lvschouwen/split-flap/README.md

# Split-Flap



Split Flap Display

---
**NOTE:** I will make my best attempt to provide answers where possible in issues and try to keep things up to date where possible dependency wise, however I do not have the time/capacity to work on this project on a consistent basis. Answers and updates may take time.

My personal Split-Flap has been working since I first published this repository and continues to work to this day happily. Several people have also successfully been in touch with their working creations of this Split-Flap which I am very happy it has worked for :) 

I hope this project continues to work for any whom wish to embark on it but be aware, it is a lot of work to complete.

Thank you everyone whom has contributed, included in the "main" release or not, it is very appreciated. I hope to keep the project going in future.

<3

---

This project has been forked from the brilliant [Split Flap Project](https://github.com/Dave19171/split-flap) by [David Königsmann](https://github.com/Dave19171). None of this would have been possible without the great foundations that have been put in place.

3D-files here on [Printables](https://www.prusaprinters.org/prints/69464-split-flap-display)!

---

## What this is

A mechanical split-flap display driven by an **ESP32-S3 master** that talks over I2C to a chain of **Arduino-Nano flap units** (one Nano per flap drum). The master hosts the web UI, WiFi portal, NTP clock, MQTT/Home-Assistant integration, and pushes both master and unit firmware over the air.

A Split-Flap can have more rows than the master drives itself: each further row hangs on a cheap **ESP-01 row board** that the master pairs with over your LAN. The master lays the text out over all rows, flips them at one instant, and keeps the row boards on its stored row image.

> **Release:** the current stack is **v2** — the full port of the original ESP8266 firmware onto the ESP32-S3 plus row boards for multi-row walls. Releases are date-versioned (`vYYYY.MM.DD`); see the [releases page](https://github.com/lvschouwen/split-flap/releases) for notes and firmware binaries.

## Firmware layout

Everything is built with [PlatformIO](https://platformio.org/) — no Arduino IDE. Each project has its own `platformio.ini`; run `pio` commands from the project directory.

| Folder | Target | Role |
|---|---|---|
| `firmware/v2/Master/` | ESP32-S3-WROOM-1 (N16R8) | **The master.** Web UI, WiFi, NTP, MQTT/HA, I2C unit bus, OTA, the wall link to its row boards. |
| `firmware/v2/Unit/` | Arduino Nano | Per-flap unit: stepper homing, I2C slave, EEPROM offset/address. |
| `firmware/v2/FollowerEsp01/` | ESP8266 ESP-01 | Optional row board — turns legacy ESP-01 master hardware into a further row of an S3 master's wall. |
| `firmware/v2/Rescue/` | ESP32-S3 (factory slot) | Break-glass recovery image; installs a good master image when the app slots are bad. |
| `firmware/v2/Bootloader/` | ESP32-S3 | Custom second-stage bootloader (adds a factory-reset button on GPIO 4). |
| `firmware/v2/UnitBootloader/` | Arduino Nano | Vendored + patched **twiboot** for reflashing units over I2C (see its README). |
| `firmware/v1/ESPMaster/` | ESP8266 ESP-01 | **Frozen, deprecated** — the original v1 master, kept as reference only, out of CI (see its README). |

Install PlatformIO Core once:

```bash
pip install -U platformio
```

Then, from a project directory:

```bash
pio run                  # build
pio run -t upload        # USB flash (first time / devkit)
pio device monitor       # serial monitor at 115200 baud
pio test -e native       # host-side unit tests
python -m pytest tests/  # python-side tests (where present)
```

The operator page and the bundled unit firmware are gzipped and compiled into the master binary at build time by `firmware/v2/Master/build_assets.py` — there is no separate filesystem-flash step; `pio run -t upload` lands the whole thing.

For a Nano whose upload fails on the stock bootloader, use the fallback env:

```bash
pio run -e unit_old_bootloader -t upload
```

## The master (ESP32-S3)

The master is an **ESP32-S3-WROOM-1-N16R8 devkit**. It drives the units over I2C (SDA = GPIO 8, SCL = GPIO 9, 100 kHz) and serves one operator page: the wall, then each board, then each unit, with everything about one thing on its own screen. The same surface is open to scripts as `/api/v2` (`GET /api` lists every route).

Highlights:

- **WiFi portal** — on first boot (or when the stored network can't be reached for ~30 s) the master brings up a `<device-name>-setup` access point. Connect, pick your network, done. Credentials live in NVS and survive reboots and firmware updates.
- **Clock / NTP** — full IANA timezone picker (baked table served at `/tz.json`); the time is set at boot, on WiFi join, and whenever you change the zone.
- **OTA** — upload a new `firmware-<rev>.bin` from **Firmware → Install an update** (mandatory `?md5=` integrity check). The S3's A/B slots mean a bad image rolls back automatically. The Firmware screen shows what every board, unit and bootloader should run and does run.
- **Rescue / factory reset** — hold the GPIO 4 button for 5 s through reset to boot the rescue app from the factory slot, or `POST /firmware/rescue-boot`. WiFi credentials always survive a factory reset.
- **MQTT / Home Assistant** — see below.
- **Verdicts and history** — every board and unit is judged working, worth knowing or needing attention, with the reason; what happened on the wall is kept as a history. The master's board screen shows heap, load, I2C traffic, MQTT state and NTP sync age.

The master takes IPv6 addresses beside its IPv4 one when the network hands them out — a link-local one always, a global one when the router announces a prefix — and the page and the API answer on them; `GET /api/v2/board/<master>` lists them under `ipv6`. The operator API has no login: it relies on the network's firewall, for IPv6 as for IPv4. A global IPv6 address is reachable from the internet unless the router blocks inbound connections, as most do by default; check yours before relying on it. The row boards take IPv6 addresses the same way and answer on them; the link between master and rows, pairing and the rescue image stay on IPv4.

## The units (Arduino Nano)

Each split-flap unit is an Arduino Nano on a custom PCB, driving a **28BYJ-48** 12 V stepper through a **ULN2003** and homing the drum against a **KY-003 hall sensor** + magnet. Per-unit calibration (step offset) and the I2C address live in the Nano's EEPROM.

Flash a unit's Nano from `firmware/v2/Unit/`:

```bash
pio run -t upload
```

### Set the unit address

Each unit's address comes from a 4-way DIP switch (the firmware adds 1 so DIP `0000` → I2C `0x01`; address `0x00` is the reserved general-call address). Set them ascending from zero:

| Unit | DIP  | I2C address |
| ---- | ---- | --- |
| 1 | 0000 | 0x01 |
| 2 | 0001 | 0x02 |
| 3 | 0010 | 0x03 |
| 4 | 0011 | 0x04 |
| 5 | 0100 | 0x05 |
| … | … | … |

The master scans the bus at boot and derives the display width from the highest responding address. A dead unit keeps its slot (the layout doesn't shift), but a unit parked on a high address with nothing below it widens the display. A unit count can also be pinned manually (the master's board screen → **Settings for this board** → **Number of units**) for headless/dummy setups.

### Calibrate the zero position

The zero (blank-flaps) position is set by homing to the hall sensor and stepping a few steps forward — an offset unique to each unit, stored in EEPROM. Calibrate from the page, no reflashing:

1. Open **Calibrate the wall** (under the wall picture).
2. Pick a test letter; the master shows it on every unit.
3. Mark the flaps that show something else, and say what each one actually shows.
4. The master corrects each marked unit's offset, stores it in the unit and finds home again, over I2C; repeat until the wall is right.

A single unit is lined up on its own screen (**Line up this flap**), which also has the raw offset and nudge controls.

### Reflash units over I2C

Units carry the [patched twiboot bootloader](./firmware/v2/UnitBootloader/README.md) (flashed once per unit via ICSP). The master ships the compiled unit sketch in its own binary and:

- auto-installs it on any Nano it finds sitting in twiboot (e.g. a freshly ICSP-flashed one), and
- updates every unit on demand from a board's screen (**Update units**), or automatically for out-of-date units when a board starts.

## Walls of several rows

One ESP32-S3 master per Split-Flap; every further row is an ESP-01 row board (`firmware/v2/FollowerEsp01`) on the same LAN. The row board dials its master and keeps one connection open (the wall link); the master wraps and aligns your text across the grid and names the instant all rows flip.

- Pair a row in **Wall settings → Rows** (**Look for more boards**, or add one by its address), and arrange the rows there. By script: `curl -X POST http://<master>/api/v2/action -H 'Content-Type: application/json' -d '{"name":"pair","target":{"host":"<row address>"}}'`; `release` and `arrange` change the wall the same way, and `GET /api/v2/wall` shows every board.
- Unit jobs (home, calibrate, self-test, unit firmware, bootloader) go through the same call for the master's own units and a row board's.
- Upload a `follower-<rev>.bin` once to the master (`POST /firmware/row?md5=`); every row board on another rev is offered it and fetches it.
- All boards are assumed to be on your own LAN: the link is not authenticated.

Design: [`docs/superpowers/specs/2026-10-05-wall-link-and-console-design.md`](./docs/superpowers/specs/2026-10-05-wall-link-and-console-design.md).

## MQTT / Home Assistant

The display joins Home Assistant over MQTT with automatic discovery: inbound notification text (shown for a dwell, then reverts), a **Mode** select (text/clock), and health telemetry — including per-unit wear and a wall problem sensor when the master has row boards. Configure it in **Wall settings → Home Assistant** (host, port, user, password); leave the host empty to keep MQTT off. Create a dedicated HA user for the display rather than reusing your own login.

## Device name & running multiple displays

Every network-facing name (mDNS `<name>.local`, DHCP hostname, MQTT client id/topics, AP SSIDs) derives from one per-device identity. Out of the box it's `split-flap-<hex chip id>` — unique per board, so several displays can share a LAN running the **same image** with no per-device edits. Set a friendly name on the master's board screen (**Settings for this board** → **Name**; lowercase letters/digits/hyphens, ≤24 chars). Note that the name is also the MQTT client id and the Home Assistant device id: renaming a master that Home Assistant already knows makes it a new device there. Use a **DHCP reservation** on the board's MAC for a fixed IP.

**Boards by their place on the wall.** Besides its identity, every board answers to a name that says where it hangs: `split-flap-row1.local` is the top row, `split-flap-row2.local` the one below, and so on (counted as the page shows them; when two boards share a grid row the name carries the column too, `split-flap-row2-c9`). A row board takes this name from its master as its DHCP hostname and mDNS name, so a router that registers DHCP hostnames in its DNS also knows it under its own domain; the name follows the row when it is moved on the Arrange screen (the row reconnects its WiFi once for that). The master answers for its own row's name on mDNS beside its own name; DHCP carries the master's own name only. A row without a master, or one that was released, is `split-flap-<hex chip id>` again. The identity is what the master's **Find row boards** scan and the pairing go by; it never changes.

## Flashing & provisioning

- **First flash** of an S3 is a USB job (`pio run -t upload`, or the merged factory-bin recipe in [`flashing/README.md`](./flashing/README.md) which lands the custom bootloader + rescue slot in one shot).
- **Subsequent flashes** go over the air — from the page's Firmware screen, or scripted with [`flashing/ota-flash.sh`](./flashing/ota-flash.sh) (fetches the latest staged bin, OTAs master/follower/rescue targets, reads the verdict back from `/settings`).
- The bundled unit firmware is staged into the master (and follower) `data/` dirs by `flashing/flasher/make_manifest.py stage`; CI's `gate` step enforces that it never drifts from the built Unit hex.

See [`flashing/README.md`](./flashing/README.md) for the full recipe (DIP address table, esptool factory-bin, OTA flags).

## PCB

The **currently deployed** hardware uses the original per-unit Arduino-Nano PCB (Gerbers under `PCB/v1/`), one board per unit. Services like [JLCPCB](https://jlcpcb.com/) or [PCBWay](https://www.pcbway.com/) can fabricate and assemble them — some surface-mount parts are best flow-soldered by the fab.

## Common problems

- **Display width looks wrong** — check each unit's DIP-switch address and wiring; address contiguously from DIP `0000` (I2C `0x01`). The **Units: N / W** field shows detected vs. derived width.
- **A unit never homes** — when powered, the KY-003 hall sensor should only light when the magnet passes it. Check the sensor lead and magnet alignment.
- **Only `pio run -t upload`** is needed to flash — web assets and the bundled unit firmware are baked into the binary; there is no separate filesystem upload.
- **WiFi range** — user [@beroliv](https://github.com/beroliv) reported ESP8266 WiFi issues on legacy hardware, resolved by soldering an extension wire to the antenna ([writeup, German](https://www.stall.biz/project/verbesserte-wlan-konnektivitaet-mit-externen-antennen-fuer-wiffi-weatherman-und-andere-module-mit-esp8266/)). Take care if you try it.

## Going deeper

- [`CLAUDE.md`](./CLAUDE.md) — the authoritative map of the current architecture, per-mechanism ownership, and hard invariants.
- [`docs/superpowers/specs/`](./docs/superpowers/specs/) — a dated design spec per feature.
- Per-mechanism detail lives in the header comment of the file that owns it.

Assembly of the mechanical build follows the [instruction manual](./Instructions/SplitFlapInstructions.pdf).
