lvschouwen/split-flap/docs/superpowers/specs/2026-10-02-in-system-twiboot-update-design.md

# In-system twiboot update over I2C (#499)

Status: design approved in chat 2026-10-02. Unit side implemented and
simavr-proven (`firmware/v2/Unit/BootUpdateAvr.h`, `UnitBootloader/sim/`);
master drivers pending. Stage 1 (boot-section dump, #511) already shipped.

## Goal

Replace the bootloader (twiboot) on fielded split-flap units over I2C, with no
ICSP, and leave behind a bootloader that can be updated routinely afterwards.
The update runs from the unit's own application firmware, driven one unit at a
time by whichever master owns the row. **Both masters must be able to drive it:**
the S3 master (16-unit row) and the ESP-01 follower (5-unit row). The unit-side
report + updater is master-agnostic by construction (it answers I2C ops), so the
only per-master work is the driving code; the S3 and ESP-01 drivers ship
together, not as a deferred follow-up. Rollout order on the wall is still S3 row
first, then the ESP-01 row, once the mechanism is proven.

## What is already known (stage 1, #511)

- All 16 S3-row units run the committed prebuilt image
  `UnitBootloader/prebuilt/twiboot-atmega328p-16mhz.hex`: 890 of 1024 bytes,
  CRC32 `18173add`. The vendored `main.c` built with the PlatformIO toolchain
  (avr-gcc 7.3.0) reproduces that image **byte for byte** — confirmed in this
  session. The new image is therefore a known delta from a known base.
- Boot section is the real NRWW section at `0x7C00`–`0x7FFF`,
  `VIRTUAL_BOOT_SECTION=0`, BOOTRST set (HFUSE `0xDC`), so reset enters the
  bootloader first. Interrupt vectors stay in the application section (IVSEL
  clear).
- **Page 7 (`0x7F80`–`0x7FFF`) is empty** (all `0xFF`).
- twiboot's SPM instructions sit at `0x7e60`, `0x7e86`, `0x7ea6`, `0x7eb2`.
  None is a clean callable `do_spm` — each is followed by a jump back into
  twiboot, not a return to the caller.
- The 5 ESP-01-row units were not dumped (the follower has no dump op); they are
  presumed on the same image and are guarded at update time by the same
  boot-section CRC check.

## Why it is safe to attempt

The only moment a unit can be bricked is while a page that is on the reset /
execution path is mid-write and power is lost. Reset always enters 0x7C00
(BOOTRST), so that page is boot page 0: from the start of its erase until its
write completes it is blank, and a reset then executes erased flash. Stage 2
rewrites page 0 twice (trampoline, then the real page), so there are exactly
two such windows per update, each one erase+write (~9 ms). Everything else is
resumable:

1. SPM executes only from the boot section. The application cannot write flash
   directly; it must transfer control to code in the boot section.
2. **Stage 1** gets a proper `do_spm` into the *empty* page 7 by driving
   twiboot's own write handler (below). Page 7 is not on any execution path, so
   a failure here cannot brick a unit — it is the proof of the technique, on the
   wall, at zero risk.
3. **Stage 2** uses that `do_spm` (now a normal callable routine) to rewrite
   pages 0–6. It writes a one-instruction trampoline into page 0 first, then
   pages 1–6, verifying each by read-back, and writes the real page 0 only
   once pages 1–7 all match the target. A reset or power loss after the
   trampoline write completes and before the final page-0 erase starts boots
   the (still intact) application, which detects the half-done state and
   resumes. The simavr kill sweep confirms the windows are exactly these two.

## Stage 1 mechanism — drive twiboot's own write handler (proven)

Writing page 7 needs an SPM, and no callable `do_spm` exists yet. An earlier
plan borrowed a bare boot-section `spm` per fill and returned via a timer IRQ;
simavr **disproved** it — after a non-halting fill `spm`, twiboot's *own* fill
loop (`0x7e86`, ~19 instructions later) starts running during the ~5-cycle
interrupt latency and walks a pointer out of bounds before the ISR can preempt
(crash at `0x7e7e`). Per-word borrow is not viable.

The method that works, and is proven in simavr against the fielded image
(`firmware/v2/UnitBootloader/sim/`), drives twiboot's *entire* write handler
once instead of fighting it:

1. Seed twiboot's page buffer in SRAM (`buf` at `0x011D`..`0x019C`) with the 128
   bytes destined for page 7 (the `do_spm` routine + `0xFF` padding) — plain
   `st`, twiboot is not running.
2. Set the handler's register inputs: `r24:r25 = 0x7F80` (pagestart), the SPMCSR
   constants `r9=0x03`/`r16=0x01`/`r13=0x05`/`r12=0x11`, the fill-loop end
   pointer `r14:r15 = 0x019D` (buf+128), and `r1 = 0`.
3. `jmp 0x7e5a` — into twiboot's handler *just past* its boot-section guard
   (`0x7e52`, `brcc` away if pagestart ≥ `0x7C00`). twiboot then erases page 7,
   fills it from `buf[]`, writes it, re-enables RWW, and `rjmp`s to its **idle
   main loop** (`0x7e12`→`0x7d02`) — no crash.
4. Control does **not** return to the running sketch: twiboot's `buf[]` and
   globals overlay the application's `.data`/`.bss`, so its RAM is gone. The
   updater disables interrupts and TWI *before* seeding (an ISR would run on, or
   write into, the seeded bytes; an ISR between twiboot's `sts SPMCSR` and
   `spm` voids the SPM), arms the watchdog at 250 ms, and jumps. twiboot then
   leaves its idle loop one of two ways: the watchdog reset, or — if the
   overlaid application byte at its command address `0x019D` happens to read
   `0x21` — an immediate jump to the application. Its timeout countdown cannot
   exit, because expiry stores `r10` as the command and the updater zeroes
   `r10`. Either way the application starts from its reset vector, and the
   outcome is read as boot-section state `Page7Installed`, not as a RAM result
   code. All three cases are exercised in simavr.

Stage 2 does **not** use any of this: `do_spm` in page 7 is a normal callable
boot-section routine ending in `ret`, so the sketch rewrites pages 0–6 with
plain `call`s (proven, `PAGE6 128/128`).

The borrow/entry addresses, SPMCSR values and buffer layout are **locked by a
test over the fielded hex** (`tests/test_twiboot_entry_points.py`) and the
mechanism is reproduced by the simavr harness before any unit is touched.

## New twiboot image (lean set)

Built from the vendored `main.c` + a small patch; delivered as a second
prebuilt hex plus a generated PROGMEM header for the unit firmware.

- **`do_spm` in page 7** at a fixed address, optiboot-style calling convention
  (`r24:r25` = address, `r22` = `SPMCSR` action, `r20:r21` = data word for
  fill; caller holds interrupts off; `UnitBootloader/do_spm.S`), plus a 2-byte
  ABI/generation marker at `0x7FFE` (version byte `0x01`, then its complement:
  `01 fe`) so future firmware can identify the bootloader generation it runs
  under.
- **MCUSR stash:** `.init3` copies `MCUSR` into `GPIOR0` before clearing it, so
  the sketch can finally read the reset cause (today twiboot clears it — see
  #502 item 6, which this partly addresses).
- **Bounded pin:** a pinned bootloader falls back to the application after a
  quiet period, *unless* application flash word 0 reads `0xFFFF` (blank, keep
  waiting for a push). The quiet period is anchored to the measured worst-case
  reflash batch gap, not an invented number.
- **EEPROM access removed** (the master never uses twiboot's EEPROM path) to
  buy space. Measured budget with avr-gcc 7.3.0: EEPROM off = 728 B text,
  EEPROM+LED off = 694 B. Built image: 778 B in pages 0–6 (896 B available),
  leaving headroom; `do_spm` lives in page 7.
- **Unchanged:** flash *write* stays bounded to the application section; flash
  *read* stays unbounded so `boot-dump` keeps working.

The generated PROGMEM header is gated to match the prebuilt hex, the same way
the unit bundle is gated against the Unit build.

## Unit firmware: report + updater

All additive to the I2C contract — no `SFP_PROTOCOL_VERSION` bump.

### `GET_BOOT_INFO` (query, 0x8B)

Checksummed reply carrying: lock byte, three fuse bytes, CRC32 of the boot
section, a classified boot-section state, and the last update result. Reading
lock/fuses is done by **application** code (twiboot cannot report them). This
closes **#502 item 8**.

Part of the fleet cannot read them: on 11 of 21 units the read returns the
sketch's own first four flash bytes (#518). The unit recognises that, sets the
unreadable flag (bit 7 of the result byte) and sends placeholder bytes; masters
report `lockfuse: unreadable`. For the update guard an unreadable lock counts as
open — the read-back verification is what catches a write that did not land.

Boot-section state is derived from flash, never stored — a pure,
natively-tested classifier in a new `shared/` header maps the section to:
`Old` (CRC == `18173add`), `Page7Installed`, `Trampoline`, `New`, or `Unknown`.

### `BOOT_UPDATE` (mutation, 0x9A, stage byte + complement)

Deferred to `loop()` via a `pending*` flag like every other mutation; refused
while the drum is moving or not homed.

- **Stage 1** allowed only from `Old` with lock bits permitting boot writes.
  Writes `do_spm` into page 7 by driving twiboot's write handler, then the unit
  restarts (above). Success = state `Page7Installed` on the next
  `GET_BOOT_INFO`. The unit comes back unhomed (staggered boot-home, #309) and
  stage 2 is refused `REFUSED_BUSY` until the master homes it. Brick-free: a half-done stage 1 keeps the fielded pages 0–6
  and classifies `Old`, so it is simply retried.
- **Stage 2** allowed only from `Page7Installed` or `Trampoline`, and only when
  page 7 is byte-identical to the target `do_spm` page (`Trampoline` is keyed on
  page 0 alone, so it does not imply this). Interrupts off and TWI disabled
  (bus NACKs) for the ~80 ms; TWI is re-initialised afterwards. Any EEPROM
  write still in progress is drained first (both stages, and before lock/fuse
  reads): it silently blocks SPM, and one ending between a page-0 erase and
  its write would program an unerased page 0. Order:
  1. page 0 → trampoline (`jmp 0` to the application), skipped when it already
     is one, then read back; a page-0 write that does not verify is retried
     (3 attempts) while the application is still alive to repair it;
  2. pages 1–6 → target, skipping pages that already match, each read back;
     the first mismatch stops with the trampoline in place (resumable);
  3. only when pages 1–7 all match: page 0 → target, read back. If it does not
     match, the trampoline is written back — the only page 0 a reset can boot;
  4. whole-section CRC must classify `New` → `STAGE2_OK`, else `VERIFY_FAILED`.
  No reset afterwards: the sketch at 0x0000 is untouched, so the master reads
  the result via `GET_BOOT_INFO` and then issues `REBOOT`. Masters key on the
  **state**; the result byte only explains it (a resent stage 2 on a unit
  already New is refused but does not overwrite `STAGE2_OK`).
- **Auto-resume:** a unit that boots and classifies as `Trampoline` runs stage
  2 once unprompted, from `setup()` before `Wire.begin()` — it has no working
  bootloader until stage 2 finishes, so it must not wait for a command. A
  resume adds no page-0 window (the trampoline is already there).

The updater and the embedded target image stay in the unit firmware afterwards
(unit firmware is 16.9 KB of 30.7 KB with them) as the routine path for future
bootloader updates.

## Masters (S3 **and** ESP-01 follower)

Both masters must be able to drive the report + update, so the master-side work
ships for both trees in this arc.

### S3 master

Mirrors the stage-1 (#511) op structure: a `DisplayOpcode`, a
`makeBootUpdateCommand`, an `exec*` in `DisplayTask.cpp`, a `UnitBus` entry, and
two web routes.

- **`POST /unit/boot-update?address=N&stage=1|2`** and **`POST
  /unit/boot-info?address=N`** / result reads, on the existing `{"seq":N}`
  op-result contract.
- Arms the probe-inhibit deadline after **both** stages (as `/unit/reboot` and
  the address burns do): stage 1 restarts the unit, and stage 2 is followed by
  a `REBOOT`. After stage 1 the result is the re-polled `GET_BOOT_INFO` state,
  not the result byte (it does not survive the restart).
- **Reflash-order change (load-bearing):** the normal unit reflash job writes
  application page 0 **last** (blank it first). An interrupted reflash then
  leaves word 0 blank, so both the old and the new twiboot stay in the
  bootloader for auto-install. This is what makes the new twiboot's bounded pin
  safe.
- **`flashing/update-unit-bootloaders.sh`:** gated, per-unit, stops at the
  first failure — the twiboot-generation twin of `commission-units.sh`.

### ESP-01 follower

The follower drives its own 5-unit row's update over the same I2C ops. It has no
web UI of its own, so the leader exposes the trigger (the follower already
proxies unit ops in the cluster). Constraints carried from the follower's known
limits: the ping/op digest body ceiling (#386) — the boot-info reply must fit —
and the follower's narrower flash/RAM budget for the embedded target image. The
boot-section CRC guard still protects the 5 ESP-01-row units even though they
were never dumped (#511).

1. OTA the master, then an ordinary unit reflash campaign carrying the report +
   updater (no EEPROM-layout bump, so it is a cheap reflash).
2. `GET_BOOT_INFO` on all 16 units; confirm `Old` and lock bits open.
3. Stage 1 on all 16; confirm `Page7Installed` by read-back, then home each
   unit (it restarts unhomed and stage 2 is refused until it is homed).
4. Stage 2 on **one** unit, then accept it three ways: `boot-dump` CRC through
   the new twiboot, a full application reflash through it, and the unit homing
   afterwards.
5. Stage 2 on the remaining 15, one at a time, stopping at the first failure.

## Verification

- **Native tests** (`pio test -e native`, Unit + Master): the boot-section
  classifier, the stage guards, and the reply encoders.
- **Entry-point gate** (pytest): asserts the fielded hex (CRC `18173add`) still
  carries the exact instruction bytes at every address the stage-1 borrow
  depends on, and the exact `do_spm` entry in the new image — proven by breaking
  it once (per the verify-guards-by-falsification rule). A toolchain or image
  change that moves a byte fails CI rather than bricking a unit.
- **Generated-header gate** (pytest): the PROGMEM target image header matches
  the prebuilt hex.
- **simavr** (installed on the build host), standing in for the declined
  spare-Nano bench stage: `UnitBootloader/sim/prove.sh` compiles the unit's own
  `BootUpdateAvr.h` into a test app and runs the whole update from the real
  fielded image, a power-loss + reset before every one of its 603 flash
  operations (each must recover by itself to the byte-exact target, except the
  130 points inside the two page-0 windows), verify failures on a middle page
  and on the final page 0, a missing `do_spm`, and an idempotent resume. Every
  guard is proven by breaking it. It does not model SPM duration, lock bits or
  other ISRs, but it exercises the register setup, addresses and page ordering
  — where a defect would actually live.
- **Review:** `cpp-reviewer` on the unit updater and the master reflash-order
  change (OTA/flash/concurrency surface).

## Risks and non-goals

- A power loss during either page-0 write (erase start to write end, ~9 ms
  each, twice per update) bricks that unit until ICSP. A failed final page-0
  read-back adds a third (the trampoline restore), which is still better than
  leaving an unverified page 0 for the next reset. Everything else is
  resumable. No brown-out handling is added: a slow supply collapse during a
  window is the same loss.
- A unit whose lock byte reads closed is refused and stays on the old twiboot.
  A unit whose lock byte cannot be read at all proceeds (#518).
- The ESP-01 row is in scope for this arc (both masters must drive the update).
  Its 5 units are still guarded by the boot-section CRC check even though they
  were never dumped. Only the on-the-wall rollout is sequenced S3-first.
- Not doing the "full #499 list": an in-twiboot application CRC check is
  deferred — it needs a length+CRC trailer and a wire change and does not fit
  the lean budget. The bounded pin + application-written page-0-last gives the
  interrupted-reflash safety without it.
