lvschouwen/split-flap/PCB/v1/BOM_PCB_Splitflap_2022-03-11.csv

ID | Name | Designator | Footprint | Quantity | Manufacturer Part | Manufacturer | Supplier | Supplier Part
1 | 22μF | C5 | CAP-SMD_L3.2-W1.6 | 1 | CA45-A-10V-22μF-K | TORCH | LCSC | C503893
2 | AMS1117-3.3 | U9 | SOT-223-3_L6.5-W3.4-P2.30-LS7.0-BR | 1 | AMS1117-3.3 | AMS | LCSC | C6186
3 | 330nF | C1 | C0805 | 1 | GCJ219R71H334KA12D | Murata Electronics | LCSC | C527609
4 | 100nF | C2 | C0805 | 1 | GCM21BR11E104KA01L | Murata Electronics | LCSC | C521242
5 | BSS138 | Q1,Q2 | SOT-23-3_L2.9-W1.3-P1.90-LS2.4-BR | 2 | BSS138 | CJ | LCSC | C78284
6 | ULN2003A | U4 | SOP-16_L10.0-W3.9-P1.27-LS6.0-BL | 1 | ULN2003A | MIXIC | LCSC | C107221
7 | 10K | R1,R2,R3,R4 | R0805 | 4 | RMC080510K1%N | Tyohm | LCSC | C269742
8 | DSWB04LHGET | SW1 | SW-TH_DSWB04LHGET | 1 | - | Dongguan Guangzhu Industrial | LCSC | C99418
9 | B5B-XH-AM (LF)(SN) | U10 | CONN-TH_B5B-XH-AM-LF-SN | 1 | - | JST Sales America | LCSC | C161872
10 | ESP-01S | U2 | WIFIM-TH_ESP-01S | 1 | ESP-01S | Ai-Thinker | LCSC | C111009
11 | ARDUINO_NANO | U1 | ARDUINO_NANO | 1
12 | L7805CV | U3 | TO-220-3_L10.0-W4.5-P2.54-L | 1 | L7805CV | STMicroelectronics | LCSC | C111887
13 | B3B-XH-A(LF)(SN) | U6 | CONN-TH_3P-P2.50_B3B-XH-A-LF-SN | 1 | B3B-XH-A(LF)(SN) | JST Sales America | LCSC | C144394
14 | B4B-XH-AM(LF)(SN) | U7,U8 | CONN-TH_B4B-XH-AM-LF-SN | 2 | B4B-XH-AM(LF)(SN) | JST Sales America | LCSC | C161871
