lvschouwen/split-flap/firmware/v2/Unit/UnitMotion.ino

// Stepper motion + hall-sensor calibration, extracted from Unit.ino (#175).
// Same single-translation-unit rules as UnitI2CProtocol.ino: Unit.ino's
// globals/#defines are visible here (main sketch concatenates first).
// The blocking step loops here kick the 8 s watchdog per iteration.

// Hall-edge latch inhibit (#372): runSelfTest() drives ~2 full revolutions
// through raw stepCounted() calls that never feed driftObserveEdge(), so the
// odometer boundary latch in stepCounted() would otherwise snapshot a phantom
// near-zero hall-edge count and make a healthy unit report a false
// "edges/rev != 1" degraded-sensor fault. Set for the duration of a self-test;
// the odometer's own revolution counting is unaffected (wear still accrues).
static bool extHallLatchInhibit = false;

//Single funnel for every drum move (#231): steps the motor and folds the
//magnitude into the revolution odometer. All motion runs in loop context,
//so the plain-state update is safe; the ISR-visible mirror write must be
//interrupt-guarded (4 bytes — torn-read class #96) and only happens when a
//revolution actually completed.
void stepCounted(int steps) {
  stepper.step(steps);
  odometerAddSteps(odometer, steps, STEPS);
  // Drift position tracking (#263): drumPosition advances along the drum's
  // physical rotation direction. Callers already bake ROTATIONDIRECTION
  // into `steps`, so multiplying again deliberately CANCELS it (d² = 1) —
  // physical-forward motion always advances the position regardless of the
  // wiring direction. Not a bug; do not "fix" to a single multiply.
  driftAdvance(drift, (long)steps * ROTATIONDIRECTION, STEPS);
  if (odometer.revolutions != odometerRevolutions) {
    noInterrupts();
    odometerRevolutions = odometer.revolutions;
    interrupts();
    // Hall-edges-per-rev (#372): a healthy drum sweeps the fixed hall marker
    // exactly once per full revolution. Latch the running count at the
    // odometer's revolution boundary (the marker need not align with it — any
    // 2038-step window passes the marker once) and start the next window.
    // Skip while self-test stepping owns the drum (extHallLatchInhibit): that
    // motion never feeds the edge counter, so latching it would report a
    // phantom fault. The odometerRevolutions mirror above still advances.
    if (!extHallLatchInhibit) {
      extHallEdgesLastRev =
          (extHallEdgesThisRev > 0xFF) ? 0xFF : (uint8_t)extHallEdgesThisRev;
      extHallEdgesThisRev = 0;
    }
  }
}

//Steps the drum forward by `flaps` flap-positions. Each flap is
//STEPS_PER_FLAP_WHOLE whole steps plus a fractional remainder accumulated in
//missedSteps — when it exceeds one step we add a step and subtract, keeping
//cumulative drift below one flap. Caller must have set the speed and started
//the motor. Extracted from the two identical loops in rotateToLetter (#136).
//
//Steps one at a time with a per-step hall watch (#263): a forward move only
//sweeps the hall marker when the drum physically slipped (letter 0 sits at
//the marker and forward moves never wrap past it — any backward target goes
//through calibrate instead), so an entering edge here is a direct drift
//observation. Two consecutive low samples debounce the edge; the ~4 us
//digitalRead per >=2 ms step is noise. Stepper::step(1) keeps its inter-step
//pacing across calls (last_step_time is a member). driftObserveEdge resyncs
//the position to the edge (truth for the #264 readback) and past-threshold
//deviations arm the idle re-home in loop().
void stepFlaps(int flaps) {
  bool inWindow = digitalRead(HALLPIN) == 0;  // no re-fire when starting inside
  uint8_t lowStreak = 0;
  for (int i = 0; i < flaps; i++) {
    wdt_reset(); //a many-flap move at low speed exceeds the 8 s window (#107)
    int roundedStep = STEPS_PER_FLAP_WHOLE;
    missedSteps += STEPS_PER_FLAP_FRAC;
    if (missedSteps > 1) {
      roundedStep++;
      missedSteps--;
    }
    for (int s = 0; s < roundedStep; s++) {
      stepCounted(ROTATIONDIRECTION * 1);
      if (digitalRead(HALLPIN) == 0) {
        if (lowStreak < 2) lowStreak++;
        if (lowStreak == 2 && !inWindow) {
          inWindow = true;
          if (extHallEdgesThisRev < 0xFFFF) extHallEdgesThisRev++;  // #372
          if (driftObserveEdge(drift, STEPS, DRIFT_THRESHOLD_STEPS)) {
            drift.driftPending = true;
          }
        }
      } else {
        lowStreak = 0;
        inWindow = false;
      }
    }
  }
}

//rotate to letter
void rotateToLetter(int toLetter) {
  // Defensive bounds check (#136): receiveLetter() already constrains letter
  // indices to 0..AMOUNTFLAPS-1, but a corrupted target must never drive the
  // step loop below into a runaway motor spin. Kept before the overheat gate so
  // an invalid target can never latch currentlyrotating = 1 below and leave the
  // unit reporting busy forever — it just no-ops, staying idle.
  if (toLetter < 0 || toLetter >= AMOUNTFLAPS) {
    return;
  }

  // A unit whose home failed has no position to move from, and seeking again
  // before the retry gap is over would only repeat the failure
  // (UnitHomePolicy.h). The letter stays commanded: loop() calls back every
  // pass and the seek runs when the gap ends. Ahead of the overheat gate,
  // which would report the unit busy for the whole wait.
  if (!homed && !homeAttemptAllowed(homeBackoff, millis())) {
    return;
  }

  // Anti-overheat gate: after a rotation starts, the stepper won't move again
  // until OVERHEATINGTIMEOUT has passed. While a target is pending but the gate
  // hasn't cleared, report "busy" so the master's waitForDisplayToStop() waits
  // for the deferred move instead of running its #106 verify pass against the
  // stale displayedLetter. loop() keeps re-calling us (displayedLetter !=
  // receivedNumber) until the gate opens and the move actually runs (#135).
  if (!(lastRotation == 0 || (millis() - lastRotation > OVERHEATINGTIMEOUT * 1000UL))) {
    currentlyrotating = 1;
    return;
  }

  // Supply hold (#505, UnitSupplyWait.h), behind its gate: with the rail well
  // under this unit's idle level the coils stay off and the unit answers busy, like the overheat
  // gate above; loop() calls back every pass. Bounded, so a rail that stays
  // low delays the move and never parks it.
  if (unitGateEnabled(lifetime.featureGates, UNIT_GATE_SUPPLY_WAIT)) {
    vitalsSample(false);
    if (supplyWaitHold(supplyWait, vitalsVccNow, supplyIdleLevelMv, millis())) {
      currentlyrotating = 1;
      return;
    }
  }
  if (supplyWaitTakeHeld(supplyWait)) {
    extStatusBits |= EXT_DIAG_STATUS_SUPPLY_WAIT;
  } else {
    extStatusBits &= ~EXT_DIAG_STATUS_SUPPLY_WAIT;
  }

  lastRotation = millis();
  if (lastRotation == 0) lastRotation = 1;  // 0 = "no rotation yet" sentinel
  // Committed to a move now (past the overheat/unhomed gates): arm the per-move
  // Vcc sag (#371) and count the move into the rolling duty window (#373).
  extVccSagLastMove = 0xFFFF;
  if (extDutyWindow < 0xFFFF) extDutyWindow++;
  unsigned long extMoveStartMs = millis();  // #374 stall timing
  uint32_t extExpectedMs = 0;
  int posCurrentLetter = displayedLetter;
#ifdef SERIAL_ENABLE
  Serial.print("go to letter: ");
  Serial.println((char)pgm_read_byte(&LETTER_CHARS[toLetter]));
#endif
  //letter on a higher-or-equal index: no full rotation needed, step directly.
  //But while UNHOMED (#309 boot-home trigger 2) the drum position is unknown —
  //force the calibrate branch so a driving master that skips an explicit HOME
  //still gets a homed unit before the first move.
  if (homed && toLetter >= posCurrentLetter) {
#ifdef SERIAL_ENABLE
    Serial.println("direct");
#endif
    startMotor();
    stepper.setSpeed(stepperSpeed);
    int flaps = toLetter - posCurrentLetter;
    extExpectedMs = stallExpectedMoveMs((uint32_t)flaps * STEPS / AMOUNTFLAPS,
                                        stepperSpeed, STEPS);  // #374
    stepFlaps(flaps);
  }
  else {
    //full rotation is needed, good time for a calibration
#ifdef SERIAL_ENABLE
    Serial.println("full rotation incl. calibration");
#endif
    int homingSteps = calibrate(false); //calibrate revolver and do not stop motor
    if (homingSteps < 0) {
      // No marker, so no position to count flaps from: stepping on would park
      // the drum on an arbitrary flap and report it as the letter. calibrate()
      // already stopped the motor, dropped `homed` and started the retry gap;
      // the letter stays commanded for that retry.
      return;
    }
    stepper.setSpeed(stepperSpeed);
    // #374: the homing seek and the offset steps calibrate() made after it
    // (at HOMING_RPM) plus the flap move (at the commanded speed).
    extExpectedMs = stallExpectedSeekMoveMs(
        (uint32_t)homingSteps, (int16_t)calOffset,
        (uint32_t)toLetter * STEPS / AMOUNTFLAPS, HOMING_RPM, stepperSpeed, STEPS);
    stepFlaps(toLetter);
  }
  //store new position
  displayedLetter = toLetter;
  // Stall detection (#374, UnitStallPolicy.h). The stepper blocks a fixed
  // period per step regardless of mechanical load, so this catches abnormal
  // wall-time stretch, not a silently-slipping drum — bench-tier heuristic.
  unsigned long extActualMs = millis() - extMoveStartMs;
  if (stallExceeded(extActualMs, extExpectedMs)) {
    extStatusBits |= EXT_DIAG_STATUS_STALL;
  } else {
    extStatusBits &= ~EXT_DIAG_STATUS_STALL;
  }
  //Loaded Vcc sample (#306): the coils are still energised here, so the rail
  //is at its steady loaded level — the sag the #305 brownout saga chased.
  //Taken once per move, before the motor de-energises below.
  vitalsSample(true);
  //rotation is done, stop the motor
  delay(100); //important to stop rotation before shutting of the motor to avoid rotation after switching off current
  stopMotor();
}

//gets magnet sensor offset from EEPROM in steps
void getOffset() {
  uint8_t block[EE_CAL_BLOCK_LEN];
  for (uint8_t i = 0; i < EE_CAL_BLOCK_LEN; i++) {
    block[i] = EEPROM.read(EE_CAL_OFFSET + i);
  }
  // A blank or torn block decodes to 0 (uncalibrated), never to whatever the
  // bytes happened to say. The range clamp stays as the second guard: an
  // offset beyond one full revolution is never a legitimate calibration and
  // would make every homing overshoot by whole turns.
  int16_t stored = 0;
  unitEeCalDecode(block, stored);
  if (stored < -STEPS || stored > STEPS) {
    stored = 0;
  }
  calOffset = stored;
#ifdef SERIAL_ENABLE
  Serial.print("CalOffset from EEPROM: ");
  Serial.print(calOffset);
  Serial.println();
#endif
}

// Every seek's outcome goes through here, so the ISR's copy of the stand-down
// (#667) never lags the policy.
void recordHomeOutcome(bool found, bool hallSeen) {
  homeNoteResult(homeBackoff, found, hallSeen, millis());
  statusHomeStoodDown = homeStoodDown(homeBackoff);
}

//doing a calibration of the revolver using the hall sensor
int calibrate(bool initialCalibration) {
#ifdef SERIAL_ENABLE
  Serial.println("calibrate revolver");
#endif
  currentlyrotating = 1; //set active state to active
  // Any seek stands in for the boot self-home (#309): once this one fails and
  // drops `homed`, that fallback must not fire a second seek on the next pass.
  bootHomeAttempted = true;
  // Step-excess (#370): snapshot the believed drum position BEFORE any search
  // stepping mutates it. Meaningful only with a prior belief — a homed unit
  // whose position is known. The initial boot-home has neither, so skip it
  // there and never pollute the worst-seen max with a fabricated first value.
  bool extExcessValid = homed && drift.positionKnown;
  uint16_t extStartPos = drift.drumPosition;
  bool reachedMarker = false;
  // Track whether the hall sensor ever read 0 (magnet detected) during this
  // homing attempt. Stays true only if hall was 0 from step 0 OR we stepped
  // through to find it. If we time out with hall stuck at 1, the status bit
  // tells the master "magnet fell off / bad KY-003 / wiring issue".
  // Issue #47.
  bool hallSawMagnet = false;
  stepper.setSpeed(HOMING_RPM); //fixed speed — never the last message's speed (issue #108). rotateToLetter() re-sets the commanded speed after calibrate(false).
  int i = 0;
  while (!reachedMarker) {
    wdt_reset(); //a full homing at low speed legitimately exceeds the 8 s window (#107)
    int currentHallValue = digitalRead(HALLPIN);
    if (currentHallValue == 0) {
      hallSawMagnet = true;
    }
    if (currentHallValue == 0 && i == 0) {
      //Started inside the magnet window (e.g. SFP_CMD_HOME while parked at the
      //calibrated zero). Accepting this position as "marker found" would
      //make the zero point drift with wherever we happened to stop inside
      //the window — step out until the sensor releases, then clear the
      //edge, so the marker is always approached from the same side (#96).
      while (digitalRead(HALLPIN) == 0) {
        wdt_reset(); //stepping out of the magnet window can also run long (#107)
        stepCounted(ROTATIONDIRECTION * 1);
        i++;
        if (i > 3 * STEPS) break; //hall stuck at 0 — fall through to the failure check below
      }
      if (i <= 3 * STEPS) {
        stepCounted(ROTATIONDIRECTION * 50);
        i += 50;
      }
    }
    else if (currentHallValue == 1 && i == 0) { //already in zero position move out a bit and do the calibration {
      //not reached yet
      i = 50;
      stepCounted(ROTATIONDIRECTION * 50); //move 50 steps to get out of scope of hall
    }
    else if (currentHallValue == 1) {
      //not reached yet
      stepCounted(ROTATIONDIRECTION * 1);
    }
    else {
      //reached marker, go to calibrated offset position
      reachedMarker = true;
      //Drift measurement (#263): the search stepping above flowed through
      //stepCounted, so drumPosition says where the belief expected this
      //edge — a past-threshold deviation is a measured drift event. The
      //homing itself IS the correction, so only count; pending clears.
      driftObserveEdge(drift, STEPS, DRIFT_THRESHOLD_STEPS);
      drift.driftPending = false;
      if (extHallEdgesThisRev < 0xFFFF) extHallEdgesThisRev++;  // #372
      // #370: actual homing steps (i) vs geometry-expected (belief -> edge =
      // one rev minus the believed distance already past the last edge). Excess
      // = extra commanded steps to physically reach the marker = drag/slip.
      if (extExcessValid) {
        uint16_t expected = (uint16_t)(STEPS - extStartPos);
        uint16_t excess = ((uint16_t)i >= expected)
                              ? (uint16_t)((uint16_t)i - expected) : 0;
        extStepExcessLast = excess;
        if (excess > extStepExcessMax) extStepExcessMax = excess;
        // #406: extStepExcessMax is the SINCE-BOOT worst, so every reboot
        // forgets the drag record. Keep a lifetime high-water mark too — it
        // is what turns a one-off reading into evidence of slow mechanical
        // decline. Only a new record writes EEPROM.
        if (unitEeRecordStepExcess(lifetime, excess)) persistLifetimeHealth();
      }
      stepCounted(ROTATIONDIRECTION * calOffset);
      displayedLetter = 0;
      missedSteps = 0;
#ifdef SERIAL_ENABLE
      Serial.println("revolver calibrated");
#endif
      noInterrupts();
      statusLastHomeFailed = false;
      statusHallNeverTriggered = !hallSawMagnet;
      lastHomingStepCount = (uint16_t)i;
      homed = true;  // boot-home satisfied (#309); disables the self-home drain
      interrupts();
      recordHomeOutcome(true, true);
      //Only stop motor for initial calibration
      if (initialCalibration) {
        stopMotor();
      }
      return i;
    }
    if (i > 3 * STEPS) {
      //seems that there is a problem with the marker or the sensor. turn of the motor to avoid overheating.
      displayedLetter = 0;
      reachedMarker = true;
      //No marker found: the position estimate is meaningless and an auto
      //re-home would just fail the same way — drop both (#263). The master
      //sees the fault via statusLastHomeFailed / hallNeverTriggered.
      drift.positionKnown = false;
      drift.driftPending = false;
#ifdef SERIAL_ENABLE
      Serial.println("calibration revolver failed");
#endif
      noInterrupts();
      statusLastHomeFailed = true;
      statusHallNeverTriggered = !hallSawMagnet;
      lastHomingStepCount = (uint16_t)i;
      homed = false;  // position unknown: no direct moves, no letter to report
      interrupts();
      // #406: statusLastHomeFailed is a single current-state bit, so a unit
      // that fails intermittently looks healthy between attempts. The
      // lifetime count would have been climbing on a15 for hours before
      // anything else showed it.
      unitEeBumpSaturating(lifetime.homeFailedCount);
      persistLifetimeHealth();
      stopMotor();
      // The retry gap starts here; a third seek in a row that never saw the
      // magnet stands the unit down (#667).
      recordHomeOutcome(false, hallSawMagnet);
      return -1;
    }
    i++;
  }
  return i;
}

//switching off the motor driver
void stopMotor() {
  lastInd1 = digitalRead(STEPPERPIN1);
  lastInd2 = digitalRead(STEPPERPIN2);
  lastInd3 = digitalRead(STEPPERPIN3);
  lastInd4 = digitalRead(STEPPERPIN4);

  digitalWrite(STEPPERPIN1, LOW);
  digitalWrite(STEPPERPIN2, LOW);
  digitalWrite(STEPPERPIN3, LOW);
  digitalWrite(STEPPERPIN4, LOW);
#ifdef SERIAL_ENABLE
  Serial.println("Motor Stop");
#endif
  currentlyrotating = 0; //set active state to not active
  delay(100);
}

void startMotor() {
#ifdef SERIAL_ENABLE
  Serial.println("Motor Start");
#endif
  currentlyrotating = 1; //set active state to active
  digitalWrite(STEPPERPIN1, lastInd1);
  digitalWrite(STEPPERPIN2, lastInd2);
  digitalWrite(STEPPERPIN3, lastInd3);
  digitalWrite(STEPPERPIN4, lastInd4);
}

//Re-encodes the ISR-visible GET_DIAG / GET_SELF_TEST reply buffers from the
//loop-context drift/selfTest state (#263/#265). The interrupt-guarded copy
//is the only ISR handshake — requestEvent() streams the buffers verbatim,
//so it can never see a torn multi-byte value (#96 class). Called once per
//loop() pass, from setup() before the Wire handlers register (#173), and at
//runSelfTest's state transitions.
void driftRefreshReplyBuffers() {
  uint8_t diag[DRIFT_REPLY_LEN];
  uint8_t flags = 0;
  if (drift.driftPending) flags |= DRIFT_FLAG_PENDING;
  if (drift.positionKnown) flags |= DRIFT_FLAG_POSITION_KNOWN;
  int16_t offsetShadow = (int16_t)calOffset;  //volatile → local
  driftEncodeDiagReply(
      driftPhysicalLetter(drift, offsetShadow, STEPS, AMOUNTFLAPS), flags,
      drift.driftEvents, drift.lastDriftSteps, diag);
  uint8_t st[SELFTEST_REPLY_LEN];
  selfTestEncodeReply(selfTest, st);
  noInterrupts();
  for (uint8_t i = 0; i < DRIFT_REPLY_LEN; i++) diagReplyBuf[i] = diag[i];
  for (uint8_t i = 0; i < SELFTEST_REPLY_LEN; i++) selfTestReplyBuf[i] = st[i];
  interrupts();
}

//Supply-Vcc diagnostics (#306). Reads the AVR's own rail via the internal
//1.1V bandgap referenced to AVcc — no external divider, so it works on any
//unit. ADMUX 0b1110 selects the bandgap channel; the reference needs ~1 ms
//to settle after the mux switch before a valid conversion. Runs in loop
//context (never the Wire ISR) — the blocking conversion is ~0.1 ms.
uint16_t readVccMv() {
  ADMUX = (1 << REFS0) | 0b1110;  // AVcc ref, 1.1V bandgap as input
  delay(2);                        // let the bandgap settle
  ADCSRA |= (1 << ADSC);           // start conversion
  while (ADCSRA & (1 << ADSC)) {}  // wait (~13 ADC clocks)
  uint16_t adc = ADC;
  return unitVccFromAdc(adc);
}

//Free SRAM = gap between the heap top (__brkval, or __heap_start before any
//malloc) and the current stack pointer. The classic AVR idiom; a lower value
//means less headroom before a stack/heap collision.
uint16_t freeRamBytes() {
  extern int __heap_start, *__brkval;
  int v;
  int top = (__brkval == 0) ? (int)&__heap_start : (int)__brkval;
  int freeBytes = (int)&v - top;
  return (freeBytes < 0) ? 0 : (uint16_t)freeBytes;
}

//Take one Vcc + free-RAM sample and fold the minima. `loaded` distinguishes a
//mid-move sample (coils energised, the sag we care about) from an idle rail
//check; both feed the since-boot minimum, so the loaded samples drive vccMin
//down toward the brownout floor while idle samples keep vccNow fresh.
void vitalsSample(bool loaded) {
  vitalsVccNow = readVccMv();
  if (vitalsVccNow != 0 && vitalsVccNow < vitalsVccMin) vitalsVccMin = vitalsVccNow;
  // Per-move Vcc sag (#371): only loaded samples (coils energised, taken from
  // rotateToLetter) feed it — idle samples refresh vccNow but say nothing about
  // the move's rail droop. rotateToLetter re-arms the 0xFFFF sentinel per move.
  if (loaded && vitalsVccNow != 0 && vitalsVccNow < extVccSagLastMove) {
    extVccSagLastMove = vitalsVccNow;
  }
  uint16_t fr = freeRamBytes();
  if (fr < vitalsFreeRamMin) vitalsFreeRamMin = fr;
}

//Re-encodes the ISR-visible GET_VITALS reply from loop-context state (#306),
//same interrupt-guarded handshake as driftRefreshReplyBuffers(). Cheap (no
//ADC — the sampling is throttled separately), so it runs every loop pass and
//once in setup() before the Wire handlers register.
void vitalsRefreshReplyBuffer() {
  UnitVitals v;
  v.vccNow_mV = vitalsVccNow;
  v.vccMin_mV = (vitalsVccMin == 0xFFFF) ? vitalsVccNow : vitalsVccMin;
  v.cmdPos = (uint8_t)(receivedNumber & 0xFF);  // last commanded flap index
  v.freeRamMin = (vitalsFreeRamMin == 0xFFFF) ? 0 : vitalsFreeRamMin;
  uint8_t buf[VITALS_REPLY_LEN];
  vitalsEncodeReply(v, buf);
  noInterrupts();
  for (uint8_t i = 0; i < VITALS_REPLY_LEN; i++) vitalsReplyBuf[i] = buf[i];
  interrupts();
}

//Re-encodes the ISR-visible GET_EXT_DIAG reply from loop-context measurement
//state (#365), same interrupt-guarded handshake as the buffers above. The raw
//counters are folded by the UnitMotion.ino hooks; here we only snapshot them
//into the wire struct. The Vcc-sag sentinel falls back to vccNow exactly like
//vitalsRefreshReplyBuffer() handles its min sentinel.
void refreshExtDiagReply() {
  UnitExtDiag d;
  d.stepExcessLast   = extStepExcessLast;
  d.stepExcessMax    = extStepExcessMax;
  d.vccSagLastMove   = (extVccSagLastMove == 0xFFFF) ? vitalsVccNow : extVccSagLastMove;
  d.hallEdgesLastRev = extHallEdgesLastRev;
  d.dutyWindow       = extDutyWindow;
  d.statusBits       = extDiagWithTwiHeal(extStatusBits, twiHeal.selfResets);
  uint8_t buf[EXT_DIAG_REPLY_LEN];
  extDiagEncodeReply(d, buf);
  noInterrupts();
  for (uint8_t i = 0; i < EXT_DIAG_REPLY_LEN; i++) extDiagReplyBuf[i] = buf[i];
  interrupts();
}

//Phase 1: approach the entering edge from outside the window. Returns true
//when it failed (selfTest.reason says why).
static bool selfTestFindEdge() {
  long guard = 0;
  bool failed = false;
  if (digitalRead(HALLPIN) == 0) {
    while (digitalRead(HALLPIN) == 0) {
      wdt_reset();
      stepCounted(ROTATIONDIRECTION * 1);
      if (++guard > 3L * STEPS) {
        //Could not step OUT of the window: magnet against the sensor, or a
        //sensor stuck low (#404).
        failed = true;
        selfTest.reason = SELFTEST_REASON_HALL_STUCK;
        break;
      }
    }
    if (!failed) {
      stepCounted(ROTATIONDIRECTION * 50);  //clear the release edge
      guard += 50;
    }
  }
  while (!failed && digitalRead(HALLPIN) != 0) {
    wdt_reset();
    stepCounted(ROTATIONDIRECTION * 1);
    if (++guard > 3L * STEPS) {
      //Never saw the hall go low: magnet fallen off, dead KY-003, or broken
      //wiring (#404).
      failed = true;
      selfTest.reason = SELFTEST_REASON_HALL_NEVER;
    }
  }
  return failed;
}

//Phase 2: one measured revolution from the edge. The window width is the
//initial hall-low stretch; the revolution completes when the hall goes
//low again after leaving it (2-sample debounce on both transitions).
//Returns true when it failed; on success parks at the calibrated zero and
//counts as a home.
static bool selfTestMeasureRev() {
  bool failed = false;
  driftMarkSynced(drift);  //we are AT the entering edge
  uint16_t measuredSteps = 0;
  //Seed 1: the entering-edge position itself (where phase 1 stopped) is
  //inside the window but phase 2 only samples AFTER each step.
  uint16_t windowSteps = 1;
  unsigned long t0 = millis();
  bool leftWindow = false;
  uint8_t streak = 0;
  for (;;) {
    wdt_reset();
    stepCounted(ROTATIONDIRECTION * 1);
    measuredSteps++;
    if (measuredSteps > (uint16_t)(2 * STEPS)) {  //edge never came back
      //A drum that slips or binds part-way round (#404). windowSteps was
      //already measured this pass — runSelfTest keeps it, it is the most
      //diagnostic number available for this failure.
      failed = true;
      selfTest.reason = SELFTEST_REASON_REV_INCOMPLETE;
      selfTest.hallWindowSteps = windowSteps;
      break;
    }
    int hall = digitalRead(HALLPIN);
    if (!leftWindow) {
      if (hall == 0) {
        windowSteps++;
        streak = 0;
      } else if (++streak >= 2) {
        leftWindow = true;
        streak = 0;
      }
    } else {
      if (hall == 0) {
        if (++streak >= 2) break;  //re-entered: revolution complete
      } else {
        streak = 0;
      }
    }
  }
  if (!failed) {
    unsigned long dt = millis() - t0;
    selfTest.revTimeMs = dt > 65535UL ? 65535 : (uint16_t)dt;
    //The break landed on the debounce CONFIRM sample — the true edge was
    //one step earlier (phase 1 stopped at the first low sample, so both
    //ends of the measurement use the same edge definition).
    selfTest.stepsPerRev = measuredSteps - 1;
    selfTest.hallWindowSteps = windowSteps;
    selfTest.state = SELFTEST_STATE_OK;
    //Parked <=2 steps past the entering edge (the debounce confirm) —
    //well under the drift threshold; re-park at the calibrated zero.
    driftMarkSynced(drift);
    stepCounted(ROTATIONDIRECTION * calOffset);
    displayedLetter = 0;
    missedSteps = 0;
    drift.driftPending = false;
    // Parked at the calibrated zero from a freshly found edge — the state a
    // successful home leaves, so it counts as one.
    noInterrupts();
    statusLastHomeFailed = false;
    statusHallNeverTriggered = false;
    homed = true;
    interrupts();
    recordHomeOutcome(true, true);
  }
  return failed;
}

//On-demand diagnostic revolution (#265): sync to the hall entering edge
//(calibrate's approach rules), then measure one full revolution stepping 1
//at a time — actual steps/rev, hall window width in steps, wall time. All
//at HOMING_RPM. Parks at the calibrated zero like calibrate() so the
//letter-diff check in loop() restores the commanded letter; the 2 s
//overheat gate gives the motor a breather after the ~2 revolutions of
//continuous motion. A timeout in either phase reports FAILED and drops the
//position estimate (same reasoning as calibrate's failure path).
void runSelfTest() {
  selfTest.state = SELFTEST_STATE_RUNNING;
  bootHomeAttempted = true;  // a seek, like calibrate(): no boot self-home after it
  selfTest.reason = SELFTEST_REASON_NONE;  //#404: never report a stale reason
  selfTest.stepsPerRev = 0;
  selfTest.hallWindowSteps = 0;
  selfTest.revTimeMs = 0;
  extHallLatchInhibit = true;  //#372: don't latch the phantom edge count below
  driftRefreshReplyBuffers();  //publish RUNNING before the ~12 s of motion
  startMotor();
  stepper.setSpeed(HOMING_RPM);

  //Phase 1: approach the entering edge from outside the window, then
  //phase 2: one measured revolution from it.
  bool failed = selfTestFindEdge();
  if (!failed) failed = selfTestMeasureRev();
  if (failed) {
    //#404: keep whatever WAS measured instead of zeroing it. A phase-2
    //failure already knows its hall window, and that number is exactly what
    //diagnoses the unit; throwing it away is what made address 15 take four
    //runs and a healthy control to explain.
    selfTest.state = SELFTEST_STATE_FAILED;
    //The hall edge was never found: the drum's position is unknowable, so
    //park instead of letting the letter-diff check "restore" the commanded
    //letter from a fake blank origin. The master's next
    //frame re-sends content deliberately; until then the unit stays put.
    displayedLetter = 0;
    receivedNumber = 0;
    drift.positionKnown = false;
    drift.driftPending = false;
    // Same consequence as a failed home: the next letter must seek the marker
    // rather than step from here, and that seek waits out the retry gap.
    noInterrupts();
    homed = false;
    interrupts();
    recordHomeOutcome(false, selfTest.reason != SELFTEST_REASON_HALL_NEVER);
  }
  // #406: carry the measurements into lifetime storage. The FIRST valid
  // reading becomes the baseline this unit is compared against forever;
  // later ones move `last`. a15's healthy hallWindow of 46 survived only in
  // a session note, so "46 when new, failing now" was a thing a human had to
  // remember — now the unit carries it.
  //
  // ONLY a passing run records. #404 deliberately preserves whatever a failed
  // run measured — but that is for the GET_SELF_TEST reply a human reads, not
  // for the lifetime record. A REV_INCOMPLETE failure carries a windowSteps
  // measured against a drum that then stopped cooperating, and #268 now
  // consumes this field as a CONTROL input, so persisting it would let one bad
  // run drive the idle check's model until someone re-runs the test. The
  // reply keeps the number; the record does not.
  if (selfTest.state == SELFTEST_STATE_OK) {
    unitEeRecordSelfTest(lifetime, selfTest.hallWindowSteps,
                         selfTest.stepsPerRev);
    persistLifetimeHealth();
  }

  lastRotation = millis();  //overheat gate before the restore move
  if (lastRotation == 0) lastRotation = 1;  // 0 = "no rotation yet" sentinel
  delay(100);
  stopMotor();
  // #372: drop the partial window the self-test stepping spanned (it crossed
  // one or two odometer boundaries with the latch inhibited) so the first
  // post-self-test normal revolution latches a clean count, then re-enable.
  extHallEdgesThisRev = 0;
  extHallLatchInhibit = false;
  driftRefreshReplyBuffers();  //publish the result before loop() resumes
}
