lvschouwen/split-flap/firmware/v2/shared/MaintenancePolicy.h

#pragma once
// MaintenancePolicy.h — pure validation, wire encoding, postcondition
// classification and the result vocabulary ({"seq":N} → /unit/op-result,
// /unit/self-test-result) of the calibration/provisioning ops (#204). Both
// row masters answer through it, so an op means the same on every row.
// Natively tested by test_maintenance_policy and test_follower_ops.
//
// The validators are v1's parseCalibrationAddress/endpoint checks as a
// seam. The occupancy check deliberately runs TWICE per set-address: at the
// web boundary against the handler's snapshot copy (fast 409 for the user)
// and in displayTask against its live facts right before the EEPROM burn
// (authoritative — the queue delay makes the web-side view stale by
// design). Postcondition classifiers grade the compound address ops after
// their reprobe: "ok" means the expected bus state was OBSERVED, not merely
// that the EEPROM write ACKed.

#ifdef UNIT_TEST
  #include <cstdint>
  #include <cstdio>
  #include <cstdlib>
#else
  #include <Arduino.h>
#endif

#include "BootUpdatePlan.h"  // BootUpdateFailure (#516)
#include "SplitFlapProtocol.h"
#include "UnitHealth.h"
#include "UnitWireContract.h"  // UNIT_BUS_GATES_*
#include "UnitSelfTest.h"  // SELFTEST_REASON_* + selfTestReasonName (#404)

// The validators below spell the lower I2C bound as literal 1; they only
// stay correct while the wire contract's base agrees.
static_assert(SFP_I2C_ADDRESS_BASE == 1,
              "maintenance validators assume address base 1");

// Verdict for a web-boundary check: httpStatus 200 = pass, else the HTTP
// error to send with `message` as the body (v1's response texts).
struct MaintVerdict {
  int httpStatus = 200;
  const char* message = "";
};

// v1 parseCalibrationAddress: raw query param (nullptr = missing) → 1..126
// I2C range → within the managed window → sketch-running unit. On pass,
// `outAddr` holds the parsed address. strtol base 0 keeps v1's hex support.
inline MaintVerdict maintValidateAddress(const char* raw,
                                         const UnitFacts* units, int maxUnits,
                                         int& outAddr) {
  if (raw == nullptr) {
    return {400, "Missing 'address' query param"};
  }
  char* end = nullptr;
  long parsed = strtol(raw, &end, 0);
  if (end == raw) {
    return {400, "Address must be a number"};
  }
  if (parsed < 1 || parsed > 126) {
    return {400, "Address must be 1..126"};
  }
  int unitIndex = (int)parsed - SFP_I2C_ADDRESS_BASE;
  if (unitIndex < 0 || unitIndex >= maxUnits || units[unitIndex].state != 1) {
    return {404, "No sketch-running unit at that address"};
  }
  // #405: a unit reporting a wire contract we do not speak is present but not
  // drivable, so every single-unit op behind this gate is refused. Without it
  // an operator could still fire the most consequential one of all —
  // SET_I2C_ADDRESS, an unverifiable address burn whose recovery is a physical
  // trip — at a unit whose reply layout we cannot even parse.
  //
  // POST /unit/reboot deliberately does NOT come through here (it range-checks
  // itself), which is what keeps ENTER_BOOTLOADER reachable and a mismatched
  // unit always recoverable by reflash.
  if (!unitDrivable(units[unitIndex])) {
    return {409, "Unit reports an unrecognised protocol version — reflash it"};
  }
  outAddr = (int)parsed;
  return {};
}

// ±one drum revolution (v1 #171): the unit clamps the same bound in its
// SET_OFFSET path — past it, its post-homing rotation outruns the 8 s
// watchdog. Rejecting here gives the calibration UI a real error instead of
// a silently-dropped write.
inline MaintVerdict maintValidateOffset(long value) {
  if (value < -SFP_OFFSET_LIMIT_STEPS || value > SFP_OFFSET_LIMIT_STEPS) {
    return {400, "Offset must be within +/-2038 steps (one revolution)"};
  }
  return {};
}

// Jog rides the wire as one signed byte.
inline MaintVerdict maintValidateJog(long steps) {
  if (steps < -127 || steps > 127) {
    return {400, "Steps must be -127..127"};
  }
  return {};
}

// Feature gates ride the wire as one byte (#409). This used to check the byte
// range only, on the reasoning that the vocabulary belongs to the unit's
// firmware, "which refuses any bit it has no code for", with the write's
// read-back grading that refusal as a postcondition failure.
//
// The reasoning was sound; the premise was false (#458). UNIT_GATE_ALL admits
// 0x02 — declared in UnitEeprom.h, implemented nowhere — so the unit accepts
// it, persists it to EEPROM, and reports it as ACTIVE in GET_LIFETIME. The
// read-back then CONFIRMS a feature that does not exist, because it is
// truthful about storage and silent about behaviour. It cannot grade a
// vocabulary it never observes.
//
// Narrowing UNIT_GATE_ALL needs a fleet reflash, so until one happens the
// master refuses to send a bit nothing honours. The old comment's
// counter-argument still stands — a master second-guessing the vocabulary
// could reject gates a newer unit understands — which is why the mask lives
// in the shared wire contract next to the opcode, to be widened in the same
// change that adds the code honouring the bit.
inline MaintVerdict maintValidateGates(long gates) {
  if (gates < 0 || gates > 255) {
    return {400, "Gates must be a 0..255 bit mask"};
  }
  if ((gates & ~(long)SFP_UNIT_GATE_IMPLEMENTED) != 0) {
    return {400, "Gates contain bits no unit firmware implements"};
  }
  return {};
}

// Set-address target: bounded to the managed window (an address above it
// would strand the unit beyond all over-I2C management — v1 rule), and the
// target must not answer on the bus unless it IS the unit's current address
// (the bulk-migration case is always allowed).
inline MaintVerdict maintValidateSetAddressTarget(long target, int currentAddr,
                                                  const UnitFacts* units,
                                                  int maxUnits) {
  if (target < 1 || target > maxUnits) {
    return {400, "Address must be within the managed unit range"};
  }
  if (target != currentAddr &&
      units[(int)target - SFP_I2C_ADDRESS_BASE].state != 0) {
    return {409, "Target address is already occupied on the bus"};
  }
  return {};
}

// --- wire-byte encoders ---------------------------------------------------------
// Kept pure so the negative encodings UnitBus puts on the bus are asserted
// natively (v1 encoded these inline in ServiceFlapFunctions.ino).

inline void maintEncodeOffsetLE(int16_t value, uint8_t out[2]) {
  out[0] = (uint8_t)((uint16_t)value & 0xFF);
  out[1] = (uint8_t)(((uint16_t)value >> 8) & 0xFF);
}

inline uint8_t maintEncodeJogByte(int steps) {
  if (steps > 127) steps = 127;
  if (steps < -127) steps = -127;
  return (uint8_t)(int8_t)steps;
}

// --- execution outcomes (the /unit/op-result vocabulary) ------------------------

enum class MaintOutcome : uint8_t {
  Pending = 0,         // slot default; a real result always overwrites it
  Ok,                  // wire ACK + (for compound ops) postcondition observed
  WireFail,            // Wire transaction failed / unit did not ACK
  ExecValidationFail,  // displayTask recheck refused the op (stale web view)
  PostconditionFail,   // burn ACKed but the reprobe contradicts the intent
};

enum class MaintReason : uint8_t {
  None = 0,
  UnitMissingAfterReprobe,  // expected responder absent from the rescan
  TargetAddressOccupied,    // pre-burn exec recheck found the target taken
  BootInfoReadFail,         // GET_BOOT_INFO wire fail or checksum rejected
  BootStateUnknown,         // boot section is in an unrecognized state
  BootLockRefused,          // lock bits prohibit boot-section self-program
  BootUnitLost,             // unit did not come back after stage 1 WDT reset
  BootVerifyFailed,         // boot state after update is not the expected one
  BootAlreadyNew,           // already on the new twiboot — nothing to do (Ok)
  BootUnitBusy,             // unit refused: drum moving or not homed
  BootNotStarted,           // stage 1 was requested and the unit never left the
                            // bus, without recording a refusal
  HomeNotFound,             // the unit reports that its home search failed
  HomeNotEnded,             // the drum was still turning when the wait ran out
};

// The reason for a failure the unit itself reported. BOOT_FAIL_NONE means it
// reported none; the caller says what that amounts to at its point in the op.
inline MaintReason maintReasonForBootFailure(BootUpdateFailure f,
                                             MaintReason whenNone) {
  switch (f) {
    case BOOT_FAIL_BUSY:   return MaintReason::BootUnitBusy;
    case BOOT_FAIL_LOCK:   return MaintReason::BootLockRefused;
    case BOOT_FAIL_STATE:  return MaintReason::BootStateUnknown;
    case BOOT_FAIL_VERIFY: return MaintReason::BootVerifyFailed;
    default:               return whenNone;
  }
}

// What an op amounts to once it ran: the outcome and, where one applies, why.
struct MaintGrade {
  MaintOutcome outcome;
  MaintReason reason;
};

// A plain single-write op: the unit ACKed it or it did not.
inline MaintGrade maintGradeWire(int wireStatus) {
  return {wireStatus == 0 ? MaintOutcome::Ok : MaintOutcome::WireFail,
          MaintReason::None};
}

// SET_GATES is verified by a read-back (#409). A unit that refused the bits
// answers with its old gates: the write landed on the wire and the intent did
// not, which is a postcondition failure rather than a wire one.
inline MaintGrade maintGradeGates(int status) {
  if (status == UNIT_BUS_GATES_MISMATCH || status == UNIT_BUS_GATES_UNVERIFIED) {
    return {MaintOutcome::PostconditionFail, MaintReason::None};
  }
  return maintGradeWire(status);
}

// An op whose wire traffic went through and whose result is a reading of the
// unit: the boot report, the boot-section dump, a self-test.
inline MaintGrade maintGradeObserved(bool ok,
                                     MaintReason whyNot = MaintReason::None) {
  if (ok) return {MaintOutcome::Ok, MaintReason::None};
  return {MaintOutcome::PostconditionFail, whyNot};
}

// After SetAddress burn + settle + reprobe: the unit must answer in sketch
// mode at its new address.
inline MaintOutcome classifySetAddressOutcome(const UnitFacts* facts,
                                              int maxUnits, int target,
                                              MaintReason& reason) {
  int idx = target - SFP_I2C_ADDRESS_BASE;
  if (idx >= 0 && idx < maxUnits && facts[idx].state == 1) {
    reason = MaintReason::None;
    return MaintOutcome::Ok;
  }
  reason = MaintReason::UnitMissingAfterReprobe;
  return MaintOutcome::PostconditionFail;
}

// After ClearAddress + settle + reprobe the unit rejoins at its DIP-derived
// address, which the master cannot know — the observable postcondition is
// that no unit vanished. A drop means DIP collision or DIP beyond the
// managed window (recoverable by DIP switches + power cycle; the UI warns).
inline MaintOutcome classifyClearAddressOutcome(int countBefore,
                                                int countAfter,
                                                MaintReason& reason) {
  if (countAfter >= countBefore) {
    reason = MaintReason::None;
    return MaintOutcome::Ok;
  }
  reason = MaintReason::UnitMissingAfterReprobe;
  return MaintOutcome::PostconditionFail;
}

// --- /unit/op-result (#204) -------------------------------------------------------

enum class OpResultState : uint8_t { Pending, Found, Expired };

// The result slot of the LAST maintenance op is one per row master; each tree
// declares its own (the S3 adds the opcode and address it ran). These read
// only `seq`, `outcome` and `reason`.

// The seq counter is monotonic, so ordering answers everything: the slot
// hasn't reached the queried op (pending), holds it (found), or moved past
// it (expired — the outcome is gone for good; UI treats it as unknown).
template <typename Slot>
inline OpResultState opResultQuery(const Slot& slot, uint32_t seq) {
  if (slot.seq < seq) return OpResultState::Pending;
  if (slot.seq == seq && slot.outcome != MaintOutcome::Pending)
    return OpResultState::Found;
  if (slot.seq == seq) return OpResultState::Pending;
  return OpResultState::Expired;
}

inline const char* maintOutcomeName(MaintOutcome o) {
  switch (o) {
    case MaintOutcome::Ok:                 return "ok";
    case MaintOutcome::WireFail:           return "wire-fail";
    case MaintOutcome::ExecValidationFail: return "exec-validation-fail";
    case MaintOutcome::PostconditionFail:  return "postcondition-fail";
    default:                               return "pending";
  }
}

inline const char* maintReasonName(MaintReason r) {
  switch (r) {
    case MaintReason::UnitMissingAfterReprobe:
      return "unit-missing-after-reprobe";
    case MaintReason::TargetAddressOccupied:
      return "target-address-occupied";
    case MaintReason::BootInfoReadFail:
      return "boot-info-read-fail";
    case MaintReason::BootStateUnknown:
      return "boot-state-unknown";
    case MaintReason::BootLockRefused:
      return "boot-lock-refused";
    case MaintReason::BootUnitLost:
      return "boot-unit-lost";
    case MaintReason::BootVerifyFailed:
      return "boot-verify-failed";
    case MaintReason::BootAlreadyNew:
      return "boot-already-new";
    case MaintReason::BootUnitBusy:
      return "boot-unit-busy";
    case MaintReason::BootNotStarted:
      return "boot-not-started";
    case MaintReason::HomeNotFound:
      return "home-not-found";
    case MaintReason::HomeNotEnded:
      return "home-not-ended";
    default:
      return "";
  }
}

// --- /unit/self-test-result (#265) -----------------------------------------------

// Execution result of the LAST self-test op (#265) — same single-slot,
// best-effort contract as MaintResult (the UI serializes self-tests and
// polls /unit/self-test-result). Carries the unit's three measurements on
// success.
enum class SelfTestOutcome : uint8_t {
  Pending = 0,  // slot default; a real result always overwrites it
  Ok,
  WireFail,     // the START write was not ACKed
  Timeout,      // unit never reported done within the master's window
  UnitFailed,   // unit reported FAILED (hall/marker problem mid-test)
  Unsupported,  // every poll answered garbage — firmware predates #265
  Aborted,      // /stop arrived while waiting
};

// Did the unit turn its drum for this test? Then it stands at home, not at
// the flap its row shows. A start that was never taken, a unit that does not
// know the test and a wait cut short say nothing about the drum.
inline bool selfTestMovedTheDrum(SelfTestOutcome o) {
  return o == SelfTestOutcome::Ok || o == SelfTestOutcome::UnitFailed ||
         o == SelfTestOutcome::Timeout;
}

struct SelfTestSlot {
  uint32_t seq = 0;
  uint8_t addr = 0;
  SelfTestOutcome outcome = SelfTestOutcome::Pending;
  uint16_t stepsPerRev = 0;
  uint16_t hallWindowSteps = 0;
  uint16_t revTimeMs = 0;
  // Which of the unit's three failure modes fired (#404), SELFTEST_REASON_*.
  // `outcome` above is the MASTER's view (wire-fail, timeout, unit-failed);
  // this is the unit's own account of why, which is what tells a person
  // whether to reseat a magnet, replace a sensor, or free a binding drum.
  uint8_t unitReason = SELFTEST_REASON_NONE;
};

inline const char* selfTestOutcomeName(SelfTestOutcome o) {
  switch (o) {
    case SelfTestOutcome::Ok:          return "ok";
    case SelfTestOutcome::WireFail:    return "wire-fail";
    case SelfTestOutcome::Timeout:     return "timeout";
    case SelfTestOutcome::UnitFailed:  return "unit-failed";
    case SelfTestOutcome::Unsupported: return "unsupported";
    case SelfTestOutcome::Aborted:     return "aborted";
    default:                           return "pending";
  }
}

// Renders the self-test result JSON for a queried seq (#265) — the same
// pending / found / expired ordering rules as opResultQuery, from the
// self-test's own slot. Fits well inside 128 bytes.
inline void buildSelfTestJson(char* buf, size_t cap, const SelfTestSlot& slot,
                              uint32_t seq) {
  if (slot.seq < seq ||
      (slot.seq == seq && slot.outcome == SelfTestOutcome::Pending)) {
    snprintf(buf, cap, "{\"state\":\"pending\"}");
    return;
  }
  if (slot.seq > seq) {
    snprintf(buf, cap, "{\"state\":\"expired\"}");
    return;
  }
  if (slot.outcome == SelfTestOutcome::Ok) {
    snprintf(buf, cap,
             "{\"state\":\"ok\",\"steps_per_rev\":%u,\"hall_window\":%u,"
             "\"rev_time_ms\":%u}",
             (unsigned)slot.stepsPerRev, (unsigned)slot.hallWindowSteps,
             (unsigned)slot.revTimeMs);
    return;
  }
  // #404: the failure branch used to be a bare state+reason with every
  // measurement zeroed, so /unit/self-test-result said exactly why the MASTER
  // gave up and nothing about what the unit found. Now it carries the unit's
  // own failure mode and whatever it managed to measure first.
  snprintf(buf, cap,
           "{\"state\":\"failed\",\"reason\":\"%s\",\"unit_reason\":\"%s\","
           "\"steps_per_rev\":%u,\"hall_window\":%u,\"rev_time_ms\":%u}",
           selfTestOutcomeName(slot.outcome),
           selfTestReasonName(slot.unitReason),
           (unsigned)slot.stepsPerRev, (unsigned)slot.hallWindowSteps,
           (unsigned)slot.revTimeMs);
}

// Renders the op-result JSON for a queried seq from the result slot. Fits well inside 96 bytes.
template <typename Slot>
inline void buildOpResultJson(char* buf, size_t cap, const Slot& slot,
                              uint32_t seq) {
  switch (opResultQuery(slot, seq)) {
    case OpResultState::Pending:
      snprintf(buf, cap, "{\"state\":\"pending\"}");
      return;
    case OpResultState::Expired:
      snprintf(buf, cap, "{\"state\":\"expired\"}");
      return;
    case OpResultState::Found:
      break;
  }
  if (slot.outcome == MaintOutcome::Ok) {
    // An ok can carry a reason too — "already new" is not "updated" (#516).
    if (slot.reason == MaintReason::None) {
      snprintf(buf, cap, "{\"state\":\"ok\"}");
    } else {
      snprintf(buf, cap, "{\"state\":\"ok\",\"detail\":\"%s\"}",
               maintReasonName(slot.reason));
    }
  } else if (slot.reason == MaintReason::None) {
    snprintf(buf, cap, "{\"state\":\"failed\",\"reason\":\"%s\"}",
             maintOutcomeName(slot.outcome));
  } else {
    snprintf(buf, cap,
             "{\"state\":\"failed\",\"reason\":\"%s\",\"detail\":\"%s\"}",
             maintOutcomeName(slot.outcome), maintReasonName(slot.reason));
  }
}
