lvschouwen/split-flap/firmware/v2/shared/SplitFlapProtocol.h

#pragma once
/* ###########################################################################
 * SplitFlapProtocol.h — single source of truth for the master<->unit contract
 * ###########################################################################
 *
 * Included by the active firmwares (separate PlatformIO projects — each adds
 * `-I ../shared` to its build so this resolves as a flat include):
 *   - firmware/v2/Master        (ESP32-S3 master / I2C bus master)
 *   - firmware/v2/Unit          (Arduino Nano per-flap / I2C slave)
 *   - firmware/v2/FollowerEsp01 (ESP-01 cluster row master)
 * Migrated from firmware/v1/shared at #311. The frozen firmware/v1/ESPMaster
 * still references it by the old path (dangling — never rebuilt).
 *
 * Before #149 the opcodes, address base and 45-char alphabet were duplicated
 * across the two sketches AND data/script.js, kept in sync by comment only —
 * drift silently sent wrong characters or mis-decoded opcodes and nothing in
 * CI caught it. Everything on the wire now derives from the macros below:
 *   - master  : FlapLetters.h maps text through SFP_ALPHABET
 *   - unit    : `LETTER_CHARS[]` = SFP_ALPHABET, AMOUNTFLAPS  = SFP_FLAP_AMOUNT
 *   - web UI  : data/script.js CALIBRATION_LETTERS is verified byte-for-byte
 *               against SFP_ALPHABET at build time by build_assets.py.
 * The native test env asserts the header's own consistency (test_unit_protocol).
 *
 * Pure preprocessor + a static_assert only — no system includes — so it is
 * safe to include anywhere on AVR, ESP8266 and the native (host) test build.
 */

// ---------------------------------------------------------------------------
// Alphabet — the drum's fixed character set. The master sends an INDEX into
// this table (0..SFP_FLAP_AMOUNT-1), never the character itself. Index 0 is
// blank. ä/ö/ü are wire-encoded as $ & # (the web UI translates user input
// before sending). Changing this string changes what every flap must show —
// keep it in lock-step with the physical flap ordering on the drums.
//Tail order is the PHYSICAL drum order: '!' sits before '?', '-' last —
//verified against hardware (#177). The intuitive ":.-?!" is wrong.
#define SFP_ALPHABET " ABCDEFGHIJKLMNOPQRSTUVWXYZ$&#0123456789:.!?-"

// Number of flaps per unit, derived from the alphabet so the two can never
// disagree. Cast to int to match the historical `#define ... 45` type and to
// avoid size_t/int promotion surprises in the arithmetic both sketches do.
#define SFP_FLAP_AMOUNT ((int)(sizeof(SFP_ALPHABET) - 1))

// ---------------------------------------------------------------------------
// I2C addressing. Address 0x00 is reserved (general call); every unit's
// address is offset by SFP_I2C_ADDRESS_BASE so the master's 0-based unit
// index maps to 0x01..0x10 (DIP "0000" -> 0x01, DIP "1111" -> 0x10).
#define SFP_I2C_ADDRESS_BASE          1

// General-call broadcast address — a write to 0x00 reaches every unit with
// TWGCE enabled. By convention the master only ever broadcasts SFP_CMD_HOME
// (see broadcastHome()); units treat received opcodes the same whether
// addressed individually or via general call, so other opcodes on broadcast
// would produce unintended side effects.
#define SFP_I2C_GENERAL_CALL_ADDRESS  0x00

// ---------------------------------------------------------------------------
// Wire contract version (#405). ONE number describes what a unit speaks — no
// per-command version byte. The master reads it from the GET_VERSION reply,
// which is why that opcode's format is frozen forever: you cannot ask "which
// contract do you speak" through an opcode whose shape depends on the answer.
//
// A unit reporting anything else is NOT ignored — that would take a wall of
// newer units under an older master dark with no way back, since the master
// is what drives the reflash. It is reachable through GET_VERSION and
// ENTER_BOOTLOADER only, surfaced as a fault, and always a reflash target.
// Gate helpers live in UnitWireContract.h.
//
// Bump this whenever any reply length, payload layout or checksum mask below
// changes. It does NOT track the EEPROM layout — that is the unit's own
// UNIT_EE_LAYOUT_VERSION, describing stored bytes rather than the wire.
//
//   1  The #407 day-0 contract, all of it landing in one fleet reflash:
//        #405 checksums on GET_STATUS/GET_VERSION/GET_OFFSET, complement-
//             protected SET_OFFSET/SET_I2C_ADDRESS
//        #406 GET_LIFETIME added
//        #404 GET_SELF_TEST byte 7 (was reserved) carries the failure reason
//        #409 SET_GATES added — the write half of #406's feature-gate byte
#define SFP_PROTOCOL_VERSION       1

// ---------------------------------------------------------------------------
// Command opcodes understood by the unit's receiveLetter(). The unit's first
// received byte is a letter index (0..SFP_FLAP_AMOUNT-1) for a normal display
// command, or one of these opcodes (all >= SFP_FLAP_AMOUNT, i.e. >= 45) for a
// command — so opcode values MUST stay above the highest letter index.
//
// Organized into semantic bands (issue #47):
//   0x80..0x8F  queries   — write opcode, then requestFrom for the reply
//   0x90..0x9F  mutations — write opcode (+ args), no read follow-up
//
// 0x80 (ENTER_BOOTLOADER) and 0x81 (GET_VERSION) are FIXED FOREVER across
// protocol bumps — they are the cross-generation recovery path (how a new
// master updates / detects an old unit). Do not renumber them.

// Highest stepper speed (RPM) a unit runs a letter move at. The speed byte of
// a letter write is clamped to it on the unit, so a corrupted byte cannot ask a
// 28BYJ-48 for a rate at which it only buzzes and loses its position. It is
// the top of the range both row masters send (their MAX_SPEED).
#define SFP_UNIT_SPEED_MAX         12

// SFP_CMD_GET_LETTER index of a unit that does not know where its drum is
// (not homed, or its last home failed). Outside every flap index, so a master
// treats the reply as unreadable instead of verifying against a guess.
#define SFP_LETTER_UNKNOWN         0xFF

// --- 0x8X queries ---
#define SFP_CMD_ENTER_BOOTLOADER   0x80  // trigger watchdog reset into twiboot
#define SFP_CMD_GET_VERSION        0x81  // reply: 8 bytes GIT_REV (null-padded)
#define SFP_CMD_GET_OFFSET         0x82  // reply: 2 bytes int16 LE calOffset
#define SFP_CMD_GET_STATUS         0x83  // reply: 8 bytes health/diag (issue #47)
#define SFP_CMD_GET_LETTER         0x84  // reply: 2 bytes index + ~index (issue #106)
#define SFP_CMD_GET_ODOMETER       0x85  // reply: 5 bytes — uint32 LE drum
                                         //     revolutions + XOR checksum ^ 0xA5
                                         //     (wire format in UnitOdometer.h, #231)
#define SFP_CMD_GET_DIAG           0x86  // reply: 6 bytes — physical letter,
                                         //     drift flags/events/magnitude +
                                         //     XOR checksum ^ 0xB7 (wire format
                                         //     in UnitDrift.h, #263/#264)
#define SFP_CMD_GET_SELF_TEST      0x87  // reply: 9 bytes — state + steps/rev,
                                         //     hall window, rev time (u16 LE) +
                                         //     XOR checksum ^ 0x5C (wire format
                                         //     in UnitSelfTest.h, #265)
#define SFP_CMD_GET_VITALS         0x88  // reply: 8 bytes — supply Vcc now/min
                                         //     (u16 LE mV), last commanded flap
                                         //     index, min free SRAM (u16 LE) +
                                         //     XOR checksum ^ 0x3C (wire format
                                         //     in UnitVitals.h, #306). Frozen v1
                                         //     ESPMaster never sends it.
#define SFP_CMD_GET_EXT_DIAG       0x89  // reply: 11 bytes — step-excess last/max,
                                         //     per-move Vcc sag, hall edges/rev,
                                         //     duty window, status bits + XOR
                                         //     checksum ^ 0x93 (wire format in
                                         //     UnitExtDiag.h, #365). Unversioned;
                                         //     a format change takes a new opcode.
#define SFP_CMD_GET_LIFETIME       0x8A  // reply: 15 bytes — EEPROM layout
                                         //     version, lifetime home-failure
                                         //     count, active feature gates,
                                         //     lifetime step-excess max, first/
                                         //     last self-test measurements +
                                         //     XOR checksum ^ 0x6E (wire format
                                         //     in UnitLifetime.h, #406/#407).
                                         //     GET_EXT_DIAG's since-boot twin:
                                         //     this is what survives a reboot.
#define SFP_CMD_GET_BOOT_INFO      0x8B  // reply: 11 bytes — lock byte, 3 fuse
                                         //     bytes, boot-section CRC32 LE,
                                         //     classified boot-section state,
                                         //     last update result + XOR checksum
                                         //     ^ 0x5A (wire format in
                                         //     BootUpdateReport.h, #499). Lets a
                                         //     master see each unit's bootloader
                                         //     generation + whether a twiboot
                                         //     update is safe. Closes #502 item 8.
#define SFP_CMD_GET_BUS_RECORD     0x8C  // reply: 9 bytes — the silences the
                                         //     unit lived through (how often,
                                         //     how long, what it tried, whether
                                         //     it saw traffic) + XOR checksum
                                         //     ^ 0xD4 (wire format in
                                         //     UnitBusRecord.h, #584). Kept in
                                         //     EEPROM: it survives the power
                                         //     cycle that ends a silence.

// --- 0x9X mutations ---
// The no-argument ones travel as opcode + ~opcode (#512); the acceptance
// rules, and why ENTER_BOOTLOADER above is the exception, are in
// UnitWireContract.h.
// All mutation opcodes defer heavy work (EEPROM write, motor moves, WDT reset)
// to the unit's loop() via pending* flags — doing it in the Wire ISR stalls
// the bus and can drop follow-up transactions.
#define SFP_CMD_HOME               0x90  // no args; unit runs full calibrate(true)
#define SFP_CMD_JOG                0x91  // +1 signed byte (-127..+127) + its
                                         //     complement (#512)
#define SFP_CMD_REBOOT             0x92  // no args; soft watchdog reset (stays in sketch)
#define SFP_CMD_SET_OFFSET         0x93  // +2 bytes int16 LE; persist to EEPROM
                                         //     accepted range: ±SFP_OFFSET_LIMIT_STEPS
// Provisioning wizard opcodes (issue #56). EEPROM address takes precedence
// over DIP, so burning an EEPROM address makes the DIP switch irrelevant.
#define SFP_CMD_SET_I2C_ADDRESS    0x94  // +1 byte new I2C address (1..126); persist + reboot
#define SFP_CMD_CLEAR_I2C_ADDRESS  0x95  // no args; clear EEPROM magic, reboot -> DIP
#define SFP_CMD_IDENTIFY           0x96  // no args; non-blocking LED_BUILTIN blink (~3 s)
#define SFP_CMD_RESET_ODOMETER     0x97  // no args; zero the revolution odometer +
                                         //     its EEPROM ring — for physical rebuilds
                                         //     (flap swap, new motor) only (#231)
#define SFP_CMD_START_SELF_TEST    0x98  // no args; unit runs the ~2-revolution
                                         //     diagnostic (#265), reports busy while
                                         //     running; result via GET_SELF_TEST
#define SFP_CMD_SET_GATES          0x99  // +2 bytes gates + ~gates; persist the
                                         //     UNIT_GATE_* byte to EEPROM (#409).
                                         //     The write half of #406's feature-gate
                                         //     byte: motion changes ship OFF and are
                                         //     switched on over the wire, so enabling
                                         //     one costs no second reflash. Verify by
                                         //     reading GET_LIFETIME back.
#define SFP_CMD_BOOT_UPDATE        0x9A  // +2 bytes: stage (1 or 2) + ~stage.
                                         //     In-system twiboot update (#499),
                                         //     deferred to loop() like every
                                         //     mutation and refused unless the
                                         //     drum is homed and idle. Stage 1
                                         //     installs do_spm into twiboot's
                                         //     empty page 7 (brick-free); stage 2
                                         //     rewrites pages 0-6 with the new
                                         //     bootloader (page 0 last). Result
                                         //     and state read back via
                                         //     GET_BOOT_INFO.

// Feature-gate bits a master may SET_GATES, i.e. the ones some unit firmware
// actually implements. Mirrors the unit's UNIT_GATE_* (Unit/UnitEeprom.h),
// which is unit-local because it also names the EEPROM byte.
//
// WHY A SEPARATE MASK (#458): the unit's UNIT_GATE_ALL is knowingly WIDER
// than this — it still admits 0x02 (#269 scheduled re-home), a bit declared
// but implemented nowhere. A unit accepts it, persists it, and reports it as
// active through GET_LIFETIME, so the op's read-back verification confirms a
// feature that does not exist: the read-back is truthful about STORAGE and
// silent about BEHAVIOUR. Narrowing UNIT_GATE_ALL needs a reflash, so the
// masters refuse to send an unimplemented bit in the meantime. Widen this
// only together with the code that honours the bit.
#define SFP_UNIT_GATE_IDLE_HALL_CHECK  0x01  // #268 idle hall consistency check
#define SFP_UNIT_GATE_STRICT_OPCODES   0x04  // #512 no-argument mutations must
                                             //     carry their ~opcode guard
                                             //     byte and JOG its complement
                                             //     (UnitWireContract.h).
                                             //     Turn on only once every
                                             //     master on that row sends it.
#define SFP_UNIT_GATE_SUPPLY_WAIT      0x08  // #505 a letter move waits while
                                             //     the unit's own supply reads
                                             //     low. A unit without the
                                             //     code refuses the bit.
#define SFP_UNIT_GATE_SILENCE_RESTART  0x10  // #584 a unit that is not
                                             //     addressed for twenty minutes
                                             //     restarts itself, once (it
                                             //     then finds home: the drum
                                             //     moves). A unit without the
                                             //     code refuses the bit.
#define SFP_UNIT_GATE_IMPLEMENTED                                 \
  (SFP_UNIT_GATE_IDLE_HALL_CHECK | SFP_UNIT_GATE_STRICT_OPCODES | \
   SFP_UNIT_GATE_SUPPLY_WAIT | SFP_UNIT_GATE_SILENCE_RESTART)

// SET_OFFSET's accepted range (#171). The bound is one full revolution of the
// unit's 28BYJ-48 drum (its STEPS constant — a static_assert there pins the
// two together): a larger offset is never a legitimate calibration, and past
// ~2700 steps the unit's post-homing stepper.step(calOffset) — one blocking
// library call — outruns its 8 s watchdog window and resets the Nano
// mid-rotation. Enforced on BOTH sides: the master's /unit/offset rejects
// out-of-range values with a 400, the unit's SET_OFFSET path drops them and
// bumps its bad-command counter.
#define SFP_OFFSET_LIMIT_STEPS     2038

// Opcodes must never collide with a valid letter index. Guard it here so a
// future alphabet growth (or opcode renumber) fails at compile time on both
// firmwares rather than silently mis-decoding on the wire.
static_assert(SFP_CMD_ENTER_BOOTLOADER >= SFP_FLAP_AMOUNT,
              "command opcodes must be >= SFP_FLAP_AMOUNT to not alias letter indices");
