lvschouwen/split-flap/firmware/v2/Master/MqttService.cpp

// MQTT / Home Assistant service (#224) — v1 ServiceMqttFunctions.ino ported
// onto espMqttClient and the v2 task model. See MqttService.h for the
// threading contract; deviations from v1 are called out inline and in the
// spec (docs/superpowers/specs/2026-07-12-v2-mqtt-ha-slice.md).

#include "MqttService.h"

#include <WiFi.h>
#include <espMqttClient.h>

#include <atomic>
#include <time.h>

#include "BuildVersion.h"  // GIT_REV — the discovery device block's sw field
#include "ClockPolicy.h"
#include "QuietPolicy.h"  // #227
#include "ReleaseSource.h"  // RELEASE_NOTES_URL_PREFIX (#620)
#include "ReleaseUpdate.h"  // releaseStatusGet (#620)
#include "RestartUnits.h"  // restartUnitsStart (#624)
#include "DisplayCommand.h"
#include "DisplayIpc.h"
#include "HelpersSerialHandling.h"
#include "MqttHelpers.h"
#include "WearPolicy.h"
#include "MqttLifecyclePolicy.h"
#include "MqttTransport.h"  // #630: writes that never wait
#include "OtaService.h"
#include "SplitFlapProtocol.h"
#include "UnitHealth.h"
#include "WallMqtt.h"
#include "TextTransliterate.h"  // #618
#include "WallShow.h"
#include "WallState.h"
#include "WallWatch.h"
#include "WallUpdatePolicy.h"  // wallUpdatePhaseName
#include "WebEndpoints.h"

#include <memory>

#define MQTT_TELEMETRY_INTERVAL_S 60
#define MQTT_MAX_TEXT_LEN 256

#include "MqttTextResult.h"  // #622, after the length above

// Wall surfacing cadence: it copies the wall snapshot and every row's unit
// facts — too heavy for every ~10 ms pass, and Home Assistant needs nothing
// faster for supervision state.
#define MQTT_WALL_INTERVAL_MS 5000

// A frozen session must never outlive a torn upload forever (v1 resumed
// from loop() when the display thawed; v2's upload callbacks resume on
// their error paths, which misses a dead-TCP upload) — failsafe deadline.
#define MQTT_OTA_FREEZE_FAILSAFE_MS (10UL * 60UL * 1000UL)

// The inbox POD must fit the wire: the longest command topic is
// "splitflap/<name>/alignment/set" and text/set payloads run to
// MQTT_MAX_TEXT_LEN (v1 truncation rule).
static_assert(10 + DEVICE_NAME_MAX_LEN + 14 + 1 <=
                  sizeof(MqttInboxMessage::topic),
              "MqttInboxMessage.topic too small for a command topic");
static_assert(MQTT_MAX_TEXT_LEN + 1 <= sizeof(MqttInboxMessage::payload),
              "MqttInboxMessage.payload too small for a text/set payload");

// The client runs WITHOUT its internal task: the default ESP32 constructor
// would spawn one on core 1 — the display core. UseInternalTask::NO means
// loop() (and therefore every callback) runs inside mqttServiceTick() on
// mqttTask, core 0.
static MqttWallClient mqttClient;  // #630: its writes never wait for the broker

// --- service state (mqttTask-owned unless noted) -----------------------------
static bool mqttInitialised = false;
static bool mqttStoppedForOta = false;
static uint32_t mqttFrozenAtMs = 0;
static MqttBackoffState mqttBackoff;
static uint32_t mqttNextTelemetryMs = 0;

// Cross-task staging (any task -> tick). Atomics, not a mutex: each is an
// independent single-shot request flag.
static std::atomic<bool> stopForOtaRequested{false};
static std::atomic<bool> resumeAfterOtaRequested{false};
static std::atomic<bool> cancelNotificationRequested{false};
// Web transient request (#219/#616/#625): the fields are written before the
// flag (release) and read after it (acquire). The dwell is pre-applied to
// the 600 s default by the requester.
static std::atomic<bool> transientRequested{false};
static std::atomic<long> transientDwellRequested{0};
static std::atomic<bool> transientHoldRequested{false};
static std::atomic<int> transientPriorityRequested{0};
static std::atomic<bool> discoveryClearRequested{false};
static std::atomic<bool> connectedAtomic{false};
static std::atomic<bool> notifActiveAtomic{false};
static std::atomic<bool> notifHeldAtomic{false};
static std::atomic<int> notifPriorityAtomic{0};
static std::atomic<uint32_t> notifEndsAtomic{0};

// Text results (#622): noted from any task, published by the tick. Static
// queue, a few deep — a burst past that loses its oldest-but-unsent, never
// blocks a producer.
static constexpr UBaseType_t TEXT_RESULT_DEPTH = 4;
static StaticQueue_t textResultQueueBuf;
static uint8_t textResultQueueStorage[TEXT_RESULT_DEPTH * sizeof(MqttTextResult)];
static QueueHandle_t textResultQueue = nullptr;
static uint32_t textResultSeq = 0;

// Callback -> tick hand-off (same task here, but callbacks stay dumb —
// v1's copy+flag rule kept structural).
static volatile bool mqttJustConnected = false;
static volatile bool mqttDisconnectedEvent = false;

// Show-then-revert notification state (MqttHelpers.h), mqttTask-owned.
// notifActiveAtomic mirrors .active for the cross-core clockTask gate.
static MqttNotification mqttNotification;

// Stable broker identity + topics (espMqttClient stores raw POINTERS for
// host/client id/credentials/will — these must outlive the client and never
// be reassigned after init; the settings Strings can be reassigned by a web
// POST mid-run, which is exactly why the client gets its own copies, v1 #57).
static String mqttResolvedDeviceId;
static String mqttActiveHost;
static String mqttActiveUser;
static String mqttActivePassword;
static String mqttTopicAvailability;
static String mqttTopicTelemetry;
static String mqttTopicModeState;
static MqttCommandTopics mqttCmdTopics;
static String mqttFwVersion;
static uint32_t mqttBootCount = 0;

// Event-driven state trackers (v1 #132): publish a retained topic only on
// change; reset to sentinels on each (re)connect to force a full republish.
static String mqttLastPublishedMode;
static String mqttLastPublishedText = "\x01";
static int mqttLastPublishedNotif = -1;
static int mqttLastPublishedWidth = -1;
static int mqttLastPublishedUnits = -1;
static int mqttLastPublishedSpeed = -1;
static String mqttLastPublishedAlignment = "\x01";

// Wall surfacing trackers. mqttLastWallConfigured is -1 on every fresh
// session: the first wall pass RECONCILES — publish the discovery config
// when the rows table has rows, blank the retained wall topics when not (the
// last row may have been released while the broker was unreachable, leaving
// a stale retained config only this sweep can remove; blanking never-set
// retained topics is a broker no-op). mqttWallCapacity caches the wall's
// total units between 5 s wall passes for the width publish below.
// The update entity's state (#620): published when what it says changes,
// looked at every MQTT_WALL_INTERVAL_MS.
static String mqttLastUpdateState = "\x01";
static uint32_t mqttNextUpdateMs = 0;
static int mqttLastWallConfigured = -1;
static int mqttLastWallState = -1;
// Quiet switch (#227, QuietPolicy.h): command topic, last published state
// (-1 = not yet this session).
static String mqttQuietCmdTopic;
static int mqttLastQuietState = -1;
static String mqttLastWallAttrs = "\x01";
static uint32_t mqttNextWallMs = 0;
static int mqttWallCapacity = 0;

// Inbound chunk assembly (callback context). MQTT delivers one message at a
// time per connection, so a single staging pair suffices; payloads past the
// buffer truncate (v1 rule — the display path truncates to width anyway).
static char rxTopic[sizeof(MqttInboxMessage::topic)];
static char rxPayload[sizeof(MqttInboxMessage::payload)];

static void onMqttConnect(bool /*sessionPresent*/) { mqttJustConnected = true; }

static std::atomic<uint32_t> mqttDropCounter{0};  // the board page (#245);
                                                  // mqttTask writes, sampler reads

uint32_t mqttDropCount() { return mqttDropCounter.load(); }

static void onMqttDisconnect(espMqttClientTypes::DisconnectReason /*reason*/) {
  mqttDisconnectedEvent = true;
  mqttDropCounter.fetch_add(1);
}

static void onMqttMessage(const espMqttClientTypes::MessageProperties& props,
                          const char* topic, const uint8_t* payload,
                          size_t len, size_t index, size_t total) {
  // Retained messages replay on every (re)connect — a retained command
  // would re-trigger after every broker restart or WiFi blip, forever.
  // Command topics are live-only by convention: drop them (v1 rule).
  if (props.retain) return;

  if (index == 0) {
    strncpy(rxTopic, topic, sizeof(rxTopic) - 1);
    rxTopic[sizeof(rxTopic) - 1] = '\0';
  }
  for (size_t i = 0; i < len; i++) {
    size_t pos = index + i;
    if (pos >= sizeof(rxPayload) - 1) break;
    rxPayload[pos] = (char)payload[i];
  }
  if (index + len >= total) {
    size_t end =
        total > sizeof(rxPayload) - 1 ? sizeof(rxPayload) - 1 : total;
    rxPayload[end] = '\0';
    MqttInboxMessage msg;
    strncpy(msg.topic, rxTopic, sizeof(msg.topic) - 1);
    strncpy(msg.payload, rxPayload, sizeof(msg.payload) - 1);
    if (!mqttInboxPost(msg)) {
      SerialPrintln(F("MQTT: inbox full — inbound command dropped"));
    }
  }
}

void mqttServiceInit(MasterSettings& settings, SettingsStore& store,
                     const String& effectiveDeviceName, uint32_t bootCount) {
  (void)store;
  mqttBootCount = bootCount;
  textResultQueue = xQueueCreateStatic(TEXT_RESULT_DEPTH, sizeof(MqttTextResult),
                                       textResultQueueStorage, &textResultQueueBuf);
  if (settings.mqttHost.length() == 0) {
    SerialPrintln(
        F("MQTT: no broker configured (web UI, General card) — MQTT disabled"));
    return;
  }
  mqttActiveHost = settings.mqttHost;
  mqttActiveUser = settings.mqttUser;
  mqttActivePassword = settings.mqttPassword;
  int port = settings.mqttPort;
  if (port < 1 || port > 65535) port = SETTINGS_DEFAULT_MQTT_PORT;

  // MQTT identity follows the per-device network identity (#125) — chip-id
  // default or the stored pretty name. No separate mqttDeviceId knob.
  mqttResolvedDeviceId = effectiveDeviceName;
  mqttFwVersion = GIT_REV;
  mqttCmdTopics = makeMqttCommandTopics(mqttResolvedDeviceId);
  mqttQuietCmdTopic = mqttTopic(mqttResolvedDeviceId, "quiet/set");
  mqttTopicAvailability = mqttTopic(mqttResolvedDeviceId, "availability");
  mqttTopicTelemetry = mqttTopic(mqttResolvedDeviceId, "telemetry");
  mqttTopicModeState = mqttTopic(mqttResolvedDeviceId, "mode");

  mqttClient.setServer(mqttActiveHost.c_str(), (uint16_t)port);
  if (mqttActiveUser.length() > 0) {
    mqttClient.setCredentials(mqttActiveUser.c_str(),
                              mqttActivePassword.c_str());
  }
  mqttClient.setClientId(mqttResolvedDeviceId.c_str());
  mqttClient.setKeepAlive(30);
  // Last Will: broker publishes retained "offline" if we vanish uncleanly.
  mqttClient.setWill(mqttTopicAvailability.c_str(), 1, true, "offline");
  mqttClient.onConnect(onMqttConnect);
  mqttClient.onDisconnect(onMqttDisconnect);
  mqttClient.onMessage(onMqttMessage);

  mqttInitialised = true;
  mqttBackoffInit(mqttBackoff, millis());
  SerialPrintln("MQTT: initialised, device id: " + mqttResolvedDeviceId);
}

// Retained HA discovery configs, one per entity. Truncation guard (v1):
// snprintf returning >= bufLen means a cut-mid-string JSON/topic that would
// poison HA's retained config — skip and log instead.
static void publishMqttDiscovery() {
  char topicBuf[96];
  char payloadBuf[MQTT_DISCOVERY_MAX];
  for (int entity = 0; entity < DISCOVERY_ENTITY_COUNT; entity++) {
    size_t tLen = buildDiscoveryTopic(topicBuf, sizeof(topicBuf), entity,
                                      mqttResolvedDeviceId.c_str());
    size_t pLen =
        buildDiscoveryPayload(payloadBuf, sizeof(payloadBuf), entity,
                              mqttResolvedDeviceId.c_str(),
                              mqttFwVersion.c_str());
    if (tLen == 0 || tLen >= sizeof(topicBuf) || pLen == 0 ||
        pLen >= sizeof(payloadBuf)) {
      SerialPrintf(
          "MQTT: discovery entity %d skipped — would truncate (device id too "
          "long?)\n",
          entity);
      continue;
    }
    mqttClient.publish(topicBuf, 0, true, payloadBuf);
  }
  // The text result event (#622), outside the shared enum.
  size_t tLen = buildTextResultDiscoveryTopic(topicBuf, sizeof(topicBuf), mqttResolvedDeviceId.c_str());
  size_t pLen = buildTextResultDiscovery(payloadBuf, sizeof(payloadBuf), mqttResolvedDeviceId.c_str(),
                                         mqttFwVersion.c_str());
  if (tLen > 0 && tLen < sizeof(topicBuf) && pLen > 0 && pLen < sizeof(payloadBuf)) {
    mqttClient.publish(topicBuf, 0, true, payloadBuf);
  } else {
    SerialPrintln(F("MQTT: text result discovery skipped — would truncate"));
  }
}

// What became of the texts since the last pass (#622): published as events
// while connected, dropped while not — a result is about now.
static void mqttPublishTextResults(const DisplaySnapshot& snap, bool connected) {
  if (textResultQueue == nullptr) return;
  MqttTextResult r;
  while (xQueueReceive(textResultQueue, &r, 0) == pdTRUE) {
    if (!connected) continue;
    const int width = mqttWallCapacity > 0 ? mqttWallCapacity : snap.displayWidth;
    const String json = buildTextResultJson(r, ++textResultSeq, width, unsupportedFlapCount(String(r.text)));
    mqttClient.publish(mqttTopic(mqttResolvedDeviceId, "text/result").c_str(), 0, false, json.c_str());
  }
}

// The update entity's state (#620): the running rev against the release the
// master would install (#629); in progress while its update runs.
static void mqttPublishUpdateState() {
  if ((int32_t)(millis() - mqttNextUpdateMs) < 0) return;
  mqttNextUpdateMs = millis() + MQTT_WALL_INTERVAL_MS;
  const ReleaseStatus status = releaseStatusGet();
  const bool found = releaseOffered(status);
  char buf[256];
  const size_t n = buildUpdateStateJson(buf, sizeof(buf), mqttFwVersion.c_str(),
                                        found ? status.release.master.rev : "",
                                        found ? status.release.tag : "", RELEASE_NOTES_URL_PREFIX,
                                        status.op != 0 && status.step != ReleaseStep::None &&
                                            status.step != ReleaseStep::Looking);
  if (n == 0 || n >= sizeof(buf)) return;
  if (mqttLastUpdateState == buf) return;
  mqttLastUpdateState = buf;
  mqttClient.publish(mqttTopic(mqttResolvedDeviceId, "update").c_str(), 0, true, buf);
}

// Retained, static-ish diagnostics — once per connect (they change only on
// reboot/reconfig). Plain per-field payloads, no JSON escaping (v1 #132).
static void publishMqttDiagnostics() {
  mqttClient.publish(mqttTopic(mqttResolvedDeviceId, "diag/ip").c_str(), 0,
                     true, WiFi.localIP().toString().c_str());
  mqttClient.publish(mqttTopic(mqttResolvedDeviceId, "diag/ssid").c_str(), 0,
                     true, WiFi.SSID().c_str());
  mqttClient.publish(mqttTopic(mqttResolvedDeviceId, "diag/reset").c_str(), 0,
                     true, webResetReasonString());
  char n[12];
  snprintf(n, sizeof(n), "%lu", (unsigned long)mqttBootCount);
  mqttClient.publish(mqttTopic(mqttResolvedDeviceId, "diag/boots").c_str(), 0,
                     true, n);
  mqttClient.publish(mqttTopic(mqttResolvedDeviceId, "diag/ota").c_str(), 0,
                     true, otaVerdictSnapshot().otaReverted ? "ON" : "OFF");
  mqttClient.publish(mqttTopic(mqttResolvedDeviceId, "diag/tz").c_str(), 0,
                     true, webTimezoneSnapshot().c_str());
}

// mqttTask: the overlay's mirrors for the other tasks, from its state.
static void mirrorNotification() {
  notifPriorityAtomic.store(mqttNotification.priority);
  notifHeldAtomic.store(mqttNotification.held);
  notifActiveAtomic.store(mqttNotification.active);
  if (!mqttNotification.active || mqttNotification.held) notifEndsAtomic.store(0);
}

// #618: what a text may be made of, beside the Text entity. The character
// set is the drum's (SplitFlapProtocol.h); the width is the wall's units.
static void publishMqttTextAttrs() {
  char buf[128];
  const size_t n = buildTextAttrsJson(buf, sizeof(buf), SFP_ALPHABET,
                                      mqttWallCapacity > 0 ? mqttWallCapacity
                                                           : displaySnapshotGet().displayWidth);
  if (n > 0 && n < sizeof(buf)) {
    mqttClient.publish(mqttTopic(mqttResolvedDeviceId, "text/attrs").c_str(), 0, true, buf);
  }
}

static void cancelNotificationLocal() {
  notificationCancel(mqttNotification);
  mirrorNotification();
}

// mqttTask: a notification of `dwellSeconds` has just been started.
static void noteNotificationEnd(long dwellSeconds) {
  const time_t now = time(nullptr);
  notifEndsAtomic.store(notificationEndsEpoch((uint32_t)now, clockIsTimeSynced(now), dwellSeconds));
}

// mqttTask: the overlay takes `text` as asked (#616/#625). The text itself
// was handed to the display or the wall by the caller.
static void startNotificationLocal(const String& text, const MqttTextRequest& req) {
  if (req.hold) {
    notificationHold(mqttNotification, text, req.priority);
    mirrorNotification();
  } else {
    notificationStart(mqttNotification, text, req.dwellSeconds, millis(), req.priority);
    mirrorNotification();
    noteNotificationEnd(req.dwellSeconds);
  }
}

// mqttTask: hands a text to the wall (every row board, #566) or, on a master
// on its own, to the display. False when the display queue is full.
static bool showTextNow(const String& text) {
  WebContentSnapshot content = webDisplayContentSnapshot();
  if (wallShowActive()) {
    // The gate first: a text under the clock is dropped by a clock frame that
    // meets it without one (WallShow.h). The caller starts the overlay next.
    notifActiveAtomic.store(true);
    wallShowOverMode(text, content.alignment, content.flapSpeed,
                     content.deviceMode == "clock" && !tasksQuiet());
    return true;
  }
  return displayEnqueue(makeShowTextCommand(text, content.alignment, content.flapSpeed));
}

// Device renamed (#125): while this run still IS the old identity, blank
// the old retained discovery configs (empty retained payload = "delete this
// entry" per the HA spec) and every retained state topic under the old id.
static void publishDiscoveryClear() {
  char topicBuf[96];
  for (int entity = 0; entity < DISCOVERY_ENTITY_COUNT; entity++) {
    size_t tLen = buildDiscoveryTopic(topicBuf, sizeof(topicBuf), entity,
                                      mqttResolvedDeviceId.c_str());
    if (tLen == 0 || tLen >= sizeof(topicBuf)) continue;
    mqttClient.publish(topicBuf, 0, true, "");
  }
  // The wall sensor lives outside the shared enum — clear its config too
  // (blanking a never-set retained topic is harmless).
  size_t cLen = buildWallProblemDiscoveryTopic(
      topicBuf, sizeof(topicBuf), mqttResolvedDeviceId.c_str());
  if (cLen > 0 && cLen < sizeof(topicBuf)) {
    mqttClient.publish(topicBuf, 0, true, "");
  }
  // So does the text result event (#622).
  cLen = buildTextResultDiscoveryTopic(topicBuf, sizeof(topicBuf), mqttResolvedDeviceId.c_str());
  if (cLen > 0 && cLen < sizeof(topicBuf)) {
    mqttClient.publish(topicBuf, 0, true, "");
  }
  // So does the quiet switch (#227), with its retained command.
  cLen = buildQuietDiscoveryTopic(topicBuf, sizeof(topicBuf),
                                  mqttResolvedDeviceId.c_str());
  if (cLen > 0 && cLen < sizeof(topicBuf)) {
    mqttClient.publish(topicBuf, 0, true, "");
  }
  mqttClient.publish(mqttQuietCmdTopic.c_str(), 0, true, "");
  static const char* const stateSuffixes[] = {
      "mode",     "text/state", "notification", "width",     "units", "text/attrs",
      "speed",    "alignment",  "units_faulty", "units/attrs",
      "diag/ip",  "diag/ssid",  "diag/reset",   "diag/boots",
      "diag/ota", "diag/tz",    "wall_problem", "wall/attrs",
      "quiet",    "update",     "flips"};
  for (unsigned i = 0; i < sizeof(stateSuffixes) / sizeof(stateSuffixes[0]);
       i++) {
    mqttClient.publish(mqttTopic(mqttResolvedDeviceId, stateSuffixes[i]).c_str(),
                       0, true, "");
  }
  SerialPrintln(
      F("MQTT: cleared retained discovery configs for old device id (rename)"));
}

// Quiet (#227): its own topic, outside the shared command table.
static void mqttHandleQuietCommand(const String& payload) {
  bool want = false;
  if (!quietParseCommand(payload, want)) {
    SerialPrintln("MQTT: ignored invalid quiet command: " + payload);
  } else if (webMqttApplyQuiet(want)) {
    SerialPrintln(want ? F("quiet: ON (MQTT) — no flap commands")
                       : F("quiet: OFF (MQTT)"));
  }
}

static void mqttHandleModeCommand(const String& payload) {
  String requested = parseModeCommand(payload);
  if (requested.length() == 0) {
    SerialPrintln("MQTT: ignored invalid mode command: " + payload);
  } else if (webMqttApplyMode(requested)) {
    // Explicit mode change trumps a running notification (v1 #130); the
    // 1 Hz ticker re-shows the new mode's content by itself.
    cancelNotificationLocal();
    SerialPrintln("MQTT: mode set to " + requested);
  }
}

static void mqttHandleSpeedCommand(const String& payload) {
  int v = parseSpeedCommand(payload);
  if (v < 0) {
    SerialPrintln("MQTT: ignored invalid speed command: " + payload);
  } else if (webMqttApplySpeed(v)) {
    SerialPrintf("MQTT: flap speed set to %d\n", v);
  }
}

static void mqttHandleAlignmentCommand(const String& payload) {
  String a = parseAlignmentCommand(payload);
  if (a.length() == 0) {
    SerialPrintln("MQTT: ignored invalid alignment command: " + payload);
  } else if (webMqttApplyAlignment(a)) {
    SerialPrintln("MQTT: alignment set to " + a);
  }
}

// #620: the update entity's install runs the update-from-release job, under
// the gates the API's action has.
static void mqttHandleInstallCommand(const String& payload) {
  if (!parseInstallCommand(payload)) return;
  uint32_t op = 0;
  int status = 0;
  if (const char* refusal = webStartRelease(true, op, status)) {
    SerialPrintln("MQTT: update from the release refused: " + String(refusal));
  } else {
    SerialPrintf("MQTT: update from the release started (op %lu)\n", (unsigned long)op);
  }
}

// #624: the button restarts every unit of the wall, one at a time, under the
// gates the API's action has.
static void mqttHandleRestartUnitsCommand(const String& payload) {
  if (!parseRestartCommand(payload)) return;
  uint32_t op = 0;
  int status = 0;
  if (const char* refusal = restartUnitsStart(op, status)) {
    SerialPrintln("MQTT: restart of the units refused: " + String(refusal));
  } else {
    SerialPrintf("MQTT: restart of the units started (op %lu)\n", (unsigned long)op);
  }
}

static void mqttHandleTextCommand(const String& payload) {
  MqttTextRequest req;
  if (!parseMqttTextRequest(payload, req)) {
    // Malformed/plain payload → show it verbatim with the default dwell.
    req = MqttTextRequest();
    req.text = payload;
  }
  req.text = transliterateForFlaps(req.text);  // #618
  if (req.text.length() == 0) {  // #616: an empty text is a clear
    SerialPrintln(F("MQTT: text cleared (empty text)"));
    cancelNotificationLocal();
    mqttNoteTextResult(MqttTextResultKind::Cleared, String());
    return;
  }
  const String& text = req.text;
  const long dwell = req.hold ? 0 : req.dwellSeconds;
  // Producer gate (#205): while a reflash job runs nothing display-
  // mutating queues. HA commands are live-only — drop, don't defer.
  if (reflashInProgress(displaySnapshotGet().reflash) || wallUnitUpdateRunning()) {
    SerialPrintln("MQTT: text dropped (unit update running): " + text);
    mqttNoteTextResult(MqttTextResultKind::DroppedBusy, text, req.priority, req.hold, dwell);
    return;
  }
  // Quiet (#227): dropped, not deferred — unless the sender forces it,
  // which is the top priority (#625).
  if (quietBlocksContent(tasksQuiet(), req.priority >= MQTT_TEXT_PRIORITY_MAX)) {
    SerialPrintln("MQTT: text dropped (quiet): " + text);
    mqttNoteTextResult(MqttTextResultKind::DroppedQuiet, text, req.priority, req.hold, dwell);
    return;
  }
  // #625: a lower priority than the text showing is refused.
  if (!notificationAdmits(mqttNotification, req.priority)) {
    SerialPrintf("MQTT: text refused (priority %d under the %d showing): %s\n",
                 req.priority, mqttNotification.priority, text.c_str());
    mqttNoteTextResult(MqttTextResultKind::Refused, text, req.priority, req.hold, dwell);
    return;
  }
  if (!showTextNow(text)) {
    SerialPrintln("MQTT: text dropped (display queue full): " + text);
    mqttNoteTextResult(MqttTextResultKind::DroppedBusy, text, req.priority, req.hold, dwell);
    return;
  }
  if (req.hold) {
    SerialPrintf("MQTT: text held (priority %d): %s\n", req.priority, text.c_str());
  } else {
    SerialPrintf("MQTT: text for %ld s (priority %d): %s\n", req.dwellSeconds,
                 req.priority, text.c_str());
  }
  startNotificationLocal(text, req);
  mqttNoteTextResult(req.hold ? MqttTextResultKind::Held : MqttTextResultKind::Shown, text,
                     req.priority, req.hold, dwell);
}

void mqttServiceHandleInbox(const MqttInboxMessage& msg) {
  if (!mqttInitialised) return;
  String payload(msg.payload);
  if (mqttQuietCmdTopic == msg.topic) {
    mqttHandleQuietCommand(payload);
    return;
  }
  switch (classifyMqttCommandTopic(mqttCmdTopics, msg.topic)) {
    case MqttCommand::Mode:
      mqttHandleModeCommand(payload);
      break;
    case MqttCommand::Speed:
      mqttHandleSpeedCommand(payload);
      break;
    case MqttCommand::Alignment:
      mqttHandleAlignmentCommand(payload);
      break;
    case MqttCommand::Restart:
      // Defer to the netTask reboot dispatcher like every other trigger —
      // never restart inline (v1 #116: the response/LWT story needs the
      // socket torn down by the reboot, and the drain's grace period).
      if (parseRestartCommand(payload)) {
        SerialPrintln(
            F("MQTT: restart requested via HA button — reboot pending"));
        webRequestReboot("restart command via MQTT/HA");
      }
      break;
    case MqttCommand::Install:
      mqttHandleInstallCommand(payload);
      break;
    case MqttCommand::RestartUnits:
      mqttHandleRestartUnitsCommand(payload);
      break;
    case MqttCommand::Clear:
      // #616: takes the text down, whatever the payload. Passes quiet: the
      // flaps do not move for it, the mode content returns when they may.
      SerialPrintln(F("MQTT: text cleared"));
      cancelNotificationLocal();
      mqttNoteTextResult(MqttTextResultKind::Cleared, String());
      break;
    case MqttCommand::Text:
      mqttHandleTextCommand(payload);
      break;
    case MqttCommand::None:
    default:
      SerialPrintln("MQTT: message on unexpected topic dropped: " +
                    String(msg.topic));
      break;
  }
}

// --- mqttServiceTick stages (#353): one static helper per mechanism the
// tick interleaves — OTA freeze, event-driven state, wall surfacing,
// periodic telemetry. All file-scope state; mqttTask-only execution.

// OTA freeze/resume (#116 semantics). Returns true while frozen — the
// caller skips the rest of the tick.
static bool mqttHandleOtaFreeze() {
  if (stopForOtaRequested.exchange(false) && !mqttStoppedForOta) {
    mqttStoppedForOta = true;
    mqttFrozenAtMs = millis();
    // Abrupt on purpose: no DISCONNECT packet → the broker fires the
    // retained "offline" LWT, so HA availability stays correct without a
    // publish that would only go out if the broker ACKed mid-upload.
    mqttClient.disconnect(true);
    connectedAtomic.store(false);
    SerialPrintln(F("MQTT: force-closed for master OTA upload"));
}
if (mqttStoppedForOta) {
  bool resume = resumeAfterOtaRequested.exchange(false);
  if (!resume &&
      (int32_t)(millis() - mqttFrozenAtMs) >
          (int32_t)MQTT_OTA_FREEZE_FAILSAFE_MS) {
    SerialPrintln(F("MQTT: OTA freeze failsafe — resuming"));
    resume = true;
  }
  if (!resume) {
    mqttClient.loop();  // lets the disconnect complete; no reconnects
    return true;
  }
  mqttStoppedForOta = false;
  // The freeze's own force-close fired a disconnect event that was never
  // consumed while frozen — drain it (and a racing connect flag) so it
  // can't clobber the fresh immediate-attempt schedule.
  mqttDisconnectedEvent = false;
  mqttJustConnected = false;
  connectedAtomic.store(false);
  mqttBackoffInit(mqttBackoff, millis());
  SerialPrintln(F("MQTT: resuming after OTA upload ended without reboot"));
}
resumeAfterOtaRequested.store(false);
  return false;
}

// Event-driven retained state (v1 #130/#132): publish only on change so HA
// updates instantly. Cheap compares every pass. MUST run before the rename
// clear — the connect block resets the trackers, and running after the
// clear would repopulate the just-blanked old-id topics.
static void mqttPublishEventDrivenState(const DisplaySnapshot& snap,
                                        const WebContentSnapshot& content,
                                        bool leading) {
if (content.deviceMode != mqttLastPublishedMode &&
    (content.deviceMode == "text" || content.deviceMode == "clock")) {
  mqttClient.publish(mqttTopicModeState.c_str(), 0, true,
                     content.deviceMode.c_str());
  mqttLastPublishedMode = content.deviceMode;
}
// With row boards, text/state carries the whole wall (published in
// the wall block below) — the own-row slice alone would be a lie.
// Shared-tracker contract: mqttLastPublishedText/Width track the TOPIC's
// last retained value, not a mode — this own-facts path and the wall
// path below share them ON PURPOSE (one topic, one dedup), and the
// transition branch resets both when ownership flips.
if (!leading) {
  String writtenText(snap.currentText);
  if (writtenText != mqttLastPublishedText) {
    mqttLastPublishedText = writtenText;
    mqttClient.publish(mqttTopic(mqttResolvedDeviceId, "text/state").c_str(),
                       0, true, writtenText.c_str());
  }
}
int notif = mqttNotification.active ? 1 : 0;
if (notif != mqttLastPublishedNotif) {
  mqttLastPublishedNotif = notif;
  mqttClient.publish(mqttTopic(mqttResolvedDeviceId, "notification").c_str(),
                     0, true, notif ? "ON" : "OFF");
}
// Text capacity = the whole wall's units. Capacity is the 5 s wall pass's
// cached fact, so the first publish after pairing may briefly show the own
// width — retained, self-corrects next pass.
int widthValue = (leading && mqttWallCapacity > 0) ? mqttWallCapacity
                                                   : snap.displayWidth;
if (widthValue != mqttLastPublishedWidth) {
  mqttLastPublishedWidth = widthValue;
  char n[12];
  snprintf(n, sizeof(n), "%d", widthValue);
  mqttClient.publish(mqttTopic(mqttResolvedDeviceId, "width").c_str(), 0,
                     true, n);
  publishMqttTextAttrs();  // #618: the width is one of the text's attributes
}
if (snap.detectedUnitCount != mqttLastPublishedUnits) {
  mqttLastPublishedUnits = snap.detectedUnitCount;
  char n[12];
  snprintf(n, sizeof(n), "%d", (int)snap.detectedUnitCount);
  mqttClient.publish(mqttTopic(mqttResolvedDeviceId, "units").c_str(), 0,
                     true, n);
}
if (content.flapSpeed != mqttLastPublishedSpeed) {
  mqttLastPublishedSpeed = content.flapSpeed;
  char n[12];
  snprintf(n, sizeof(n), "%d", content.flapSpeed);
  mqttClient.publish(mqttTopic(mqttResolvedDeviceId, "speed").c_str(), 0,
                     true, n);
}
if (content.alignment != mqttLastPublishedAlignment) {
  mqttLastPublishedAlignment = content.alignment;
  mqttClient.publish(mqttTopic(mqttResolvedDeviceId, "alignment").c_str(), 0,
                     true, content.alignment.c_str());
}
}

// Quiet switch (#227): the discovery config once per session, the state
// retained on every change — Home Assistant reads back what the board did.
static void mqttPublishQuiet() {
  int state = tasksQuiet() ? 1 : 0;
  if (state == mqttLastQuietState) return;
  if (mqttLastQuietState < 0) {
    char topicBuf[96];
    char payloadBuf[MQTT_DISCOVERY_MAX];
    size_t tLen = buildQuietDiscoveryTopic(topicBuf, sizeof(topicBuf),
                                           mqttResolvedDeviceId.c_str());
    size_t pLen = buildQuietDiscovery(payloadBuf, sizeof(payloadBuf),
                                      mqttResolvedDeviceId.c_str(),
                                      mqttFwVersion.c_str());
    if (tLen > 0 && tLen < sizeof(topicBuf) && pLen > 0 &&
        pLen < sizeof(payloadBuf)) {
      mqttClient.publish(topicBuf, 0, true, payloadBuf);
    }
  }
  // A change made anywhere but on the command topic (the web toggle, a
  // takeover) is written back to it, retained: the broker redelivers the
  // retained command on every reconnect, and a stale one would undo the
  // change. Not on the first publish of a session — the retained command HA
  // sent while this board was offline has not arrived yet and must win.
  if (mqttLastQuietState >= 0) {
    mqttClient.publish(mqttQuietCmdTopic.c_str(), 0, true,
                       state ? "ON" : "OFF");
  }
  mqttLastQuietState = state;
  mqttClient.publish(mqttTopic(mqttResolvedDeviceId, "quiet").c_str(), 0, true,
                     state ? "ON" : "OFF");
}

// Entities of the firmware before the wall link: blanked once per session.
static bool mqttRetiredCleared = false;

static void mqttClearRetiredEntities() {
  char topicBuf[96];
  for (int i = 0;; i++) {
    size_t n = buildRetiredDiscoveryTopic(topicBuf, sizeof(topicBuf),
                                          mqttResolvedDeviceId.c_str(), i);
    if (n == 0) break;
    if (n < sizeof(topicBuf)) mqttClient.publish(topicBuf, 0, true, "");
  }
  static const char* const retiredState[] = {"cluster_degraded", "cluster/attrs",
                                             "leader_lost"};
  for (const char* suffix : retiredState) {
    mqttClient.publish(mqttTopic(mqttResolvedDeviceId, suffix).c_str(), 0, true, "");
  }
}

// Per-board state (#619/#621/#623), mqttTask-owned. The boards' discovery
// configs follow the rows table: on a fresh session and whenever the table
// changes, configs of boards no longer in it are blanked and every board's is
// published (its name may have changed with its place).
static WallMqttFlips mqttFlips;
static uint32_t mqttLastFlips = 0xFFFFFFFFUL;
static uint32_t mqttBoardsGeneration = 0;
static bool mqttBoardsPublished = false;
static int mqttBoardKeyCount = 0;
static char mqttBoardKeys[WALL_VERDICT_BOARDS][WALL_ROW_ID_MAX + 1];
static String mqttLastBoardAttrs[WALL_VERDICT_BOARDS];
static int mqttLastBoardProblem[WALL_VERDICT_BOARDS];
// The wall's supply, for the telemetry packet (its own cadence).
static MqttSupplyFacts mqttSupply;
static char mqttSupplyBoard[CLUSTER_HOST_MAX_LEN + 1] = {0};
static uint16_t mqttSupplyMinMv = 0;

static void mqttPublishBoardConfigs(const WallMqttRow* rows, int count) {
  char topicBuf[128];
  // Wider than the shared entities' 512: the board's id sits in four of the
  // fields beside the device id (WALL_MQTT_BOARD_DISCOVERY_MAX, tested).
  char payloadBuf[WALL_MQTT_BOARD_DISCOVERY_MAX];
  // Boards that left the table.
  for (int k = 0; k < mqttBoardKeyCount; k++) {
    bool present = false;
    for (int i = 0; i < count && !present; i++) {
      present = strcmp(wallMqttBoardKey(rows[i]), mqttBoardKeys[k]) == 0;
    }
    if (present) continue;
    size_t tLen = buildBoardProblemDiscoveryTopic(topicBuf, sizeof(topicBuf),
                                                  mqttResolvedDeviceId.c_str(), mqttBoardKeys[k]);
    if (tLen > 0 && tLen < sizeof(topicBuf)) mqttClient.publish(topicBuf, 0, true, "");
    mqttClient.publish(mqttTopic(mqttResolvedDeviceId, (String("board/") + mqttBoardKeys[k] + "/problem").c_str()).c_str(), 0, true, "");
    mqttClient.publish(mqttTopic(mqttResolvedDeviceId, (String("board/") + mqttBoardKeys[k] + "/attrs").c_str()).c_str(), 0, true, "");
  }
  mqttBoardKeyCount = 0;
  for (int i = 0; i < count && i < WALL_VERDICT_BOARDS; i++) {
    const char* key = wallMqttBoardKey(rows[i]);
    strlcpy(mqttBoardKeys[mqttBoardKeyCount++], key, sizeof(mqttBoardKeys[0]));
    size_t tLen = buildBoardProblemDiscoveryTopic(topicBuf, sizeof(topicBuf),
                                                  mqttResolvedDeviceId.c_str(), key);
    size_t pLen = buildBoardProblemDiscovery(payloadBuf, sizeof(payloadBuf),
                                             mqttResolvedDeviceId.c_str(), mqttFwVersion.c_str(),
                                             key, rows[i].host);
    if (tLen > 0 && tLen < sizeof(topicBuf) && pLen > 0 && pLen < sizeof(payloadBuf)) {
      mqttClient.publish(topicBuf, 0, true, payloadBuf);
    } else {
      SerialPrintln(F("MQTT: board discovery skipped — would truncate"));
    }
    mqttLastBoardAttrs[i] = "\x01";
    mqttLastBoardProblem[i] = -1;
  }
}

// One problem sensor a board (#621), its facts as attributes: on change.
static void mqttPublishBoards(const WallMqttRow* rows, int count) {
  for (int i = 0; i < count && i < WALL_VERDICT_BOARDS; i++) {
    const String base = String("board/") + wallMqttBoardKey(rows[i]);
    const int problem = wallMqttBoardProblem(rows[i]) ? 1 : 0;
    if (problem != mqttLastBoardProblem[i]) {
      mqttLastBoardProblem[i] = problem;
      mqttClient.publish(mqttTopic(mqttResolvedDeviceId, (base + "/problem").c_str()).c_str(), 0,
                         true, problem ? "ON" : "OFF");
    }
    const String attrs = wallMqttBoardAttrsJson(rows[i]);
    if (attrs != mqttLastBoardAttrs[i]) {
      mqttLastBoardAttrs[i] = attrs;
      mqttClient.publish(mqttTopic(mqttResolvedDeviceId, (base + "/attrs").c_str()).c_str(), 0,
                         true, attrs.c_str());
    }
  }
}

// The wall problem sensor's config follows whether there are rows: published
// when the first one appears, blanked (with its topics) when the last goes.
static void mqttSyncWallConfig(bool active) {
  int activeNow = active ? 1 : 0;
  if (activeNow == mqttLastWallConfigured) return;
  char topicBuf[96];
  size_t tLen = buildWallProblemDiscoveryTopic(topicBuf, sizeof(topicBuf),
                                               mqttResolvedDeviceId.c_str());
  if (tLen > 0 && tLen < sizeof(topicBuf)) {
    if (activeNow) {
      char payloadBuf[MQTT_DISCOVERY_MAX];
      size_t pLen = buildWallProblemDiscovery(payloadBuf, sizeof(payloadBuf),
                                              mqttResolvedDeviceId.c_str(),
                                              mqttFwVersion.c_str());
      if (pLen > 0 && pLen < sizeof(payloadBuf)) {
        mqttClient.publish(topicBuf, 0, true, payloadBuf);
      } else {
        SerialPrintln(F("MQTT: wall discovery skipped — would truncate"));
      }
    } else {
      // No rows (the last one released, OR the reconcile sweep of a fresh
      // session): blank the retained config + topics so Home Assistant
      // drops the entity instead of showing it stale, and force the
      // width/text publishes back onto this board's own facts.
      mqttClient.publish(topicBuf, 0, true, "");
      mqttClient.publish(mqttTopic(mqttResolvedDeviceId, "wall_problem").c_str(), 0, true,
                         "");
      mqttClient.publish(mqttTopic(mqttResolvedDeviceId, "wall/attrs").c_str(), 0, true, "");
      mqttWallCapacity = 0;
      mqttLastPublishedWidth = -1;
      mqttLastPublishedText = "\x01";
    }
  }
  mqttLastWallState = -1;
  mqttLastWallAttrs = "\x01";
  mqttLastWallConfigured = activeNow;
}

// What one pass over the wall's rows reads from.
struct MqttWallPass {
  const DisplaySnapshot& snap;
  const WallSnapshot& wall;
  const WallVerdicts& verdicts;
  bool judged;
  UnitFactsDoc& units;  // scratch for one row's unit facts
  uint32_t nowMs;
  const char* ownAddress;
  int ownRssi;
};

static void mqttRowVerdict(WallMqttRow& r, const WallVerdictBoard* board) {
  if (!board) return;
  r.judged = true;
  r.fault = board->verdict.level == VerdictLevel::Fault;
  r.level = verdictLevelName(board->verdict.level);
  r.reason = boardReasonName(board->verdict.reason);
  r.unitsFaulty = (uint8_t)unitFaultCount(board->unit, board->units);
}

// Who row i is: a master on its own is its row (`alone`), otherwise the table's.
static void mqttRowIdentity(const MqttWallPass& p, bool alone, int i, WallMqttRow& r,
                            char* text, char* host, size_t hostSize) {
  if (alone) {
    r.own = true;
    r.width = (uint8_t)p.snap.displayWidth;
    wallRowsOwnHostName(p.wall.rows, host, hostSize);
    mqttRowVerdict(r, p.judged ? p.verdicts.own() : nullptr);
    return;
  }
  const WallRowDef& def = p.wall.rows.rows[i];
  r.id = def.id;
  r.row = def.row;
  r.col = def.col;
  r.width = def.width;
  r.own = wallRowIsOwn(def);
  wallRowsHostName(p.wall.rows, i, host, hostSize);
  mqttRowVerdict(r, p.judged ? p.verdicts.ofRow(i) : nullptr);
  wallShowRowText(i, text, WALL_ROW_TEXT_MAX + 1);
}

// This board's own row: what is on the flaps and the units it reads itself.
static void mqttRowOwnFacts(const MqttWallPass& p, int i, WallMqttRow& r, bool& flipsComplete) {
  const DisplaySnapshot& snap = p.snap;
  r.text = snap.currentText;  // what is on the flaps, as for a master on its own
  r.rev = mqttFwVersion.c_str();
  r.address = p.ownAddress;
  r.rssiKnown = true;
  r.rssi = p.ownRssi;
  r.unitsKnown = true;
  r.unitsFound = snap.detectedUnitCount;
  r.unitsLost = (uint8_t)computeLostUnitCount(snap.units, snap.displayWidth);
  wallMqttUnitAggregates(snap.units, snap.displayWidth, SFP_I2C_ADDRESS_BASE, r);
  if (!wallMqttFlipsNote(mqttFlips, i, snap.units, snap.displayWidth)) flipsComplete = false;
}

// A row board's row: its link and the units it last reported.
static void mqttRowRemoteFacts(const MqttWallPass& p, int i, WallMqttRow& r, bool& flipsComplete) {
  const WallRowLink& link = p.wall.link[i];
  const WallRowReach reach = wallRowReach(link.contact, p.nowMs);
  r.reach = wallRowReachName(reach);
  // A row never heard since this master started is gone once the time a
  // connected one would have been written off has passed.
  r.lost = reach == WallRowReach::Lost ||
           (reach == WallRowReach::Never && p.nowMs >= WALL_LINK_LOST_MS);
  r.welcomed = link.everWelcomed;
  r.rev = link.rev;
  r.rescue = link.rescue;
  r.updateBlocked = link.updateBlocked;
  r.busDead = link.haveStatus && link.status.bus_dead;
  r.address = link.address;
  if (link.haveStatus) {
    r.rssiKnown = true;
    r.rssi = link.status.rssi;
  }
  UnitFactsDoc& units = p.units;
  uint32_t atMs = 0;
  if (!wallStateRowUnits(i, units, atMs)) {
    flipsComplete = false;  // its units are not known yet
    return;
  }
  r.unitsKnown = true;
  int found = 0;
  for (int u = 0; u < units.width && u < UNITS_AMOUNT; u++) {
    if (units.units[u].state != 0) found++;
  }
  r.unitsFound = (uint8_t)found;
  r.unitsLost = (uint8_t)computeLostUnitCount(units.units, units.width);
  wallMqttUnitAggregates(units.units, units.width, SFP_I2C_ADDRESS_BASE, r);
  if (!wallMqttFlipsNote(mqttFlips, i, units.units, units.width)) flipsComplete = false;
}

// The supply (#623), for the telemetry packet, and the flips (#619), once
// every found unit has been read.
static void mqttPublishSupplyAndFlips(const WallMqttRow* rows, int count, bool flipsComplete) {
  const WallMqttSupply supply = wallMqttSupply(rows, count);
  mqttSupplyMinMv = supply.mV;
  mqttSupply.unit = supply.unit;
  mqttSupply.under = supply.under;
  mqttSupply.unitUpS = supply.unitUpS;
  strlcpy(mqttSupplyBoard, supply.board >= 0 ? rows[supply.board].host : "", sizeof(mqttSupplyBoard));
  mqttSupply.board = mqttSupplyBoard;
  if (!flipsComplete) return;
  const uint32_t flips = wallMqttFlipsTotal(mqttFlips, count);
  if (flips != mqttLastFlips) {
    mqttLastFlips = flips;
    char n[12];
    snprintf(n, sizeof(n), "%lu", (unsigned long)flips);
    mqttClient.publish(mqttTopic(mqttResolvedDeviceId, "flips").c_str(), 0, true, n);
  }
}

// The wall problem sensor, its attributes and the wall's text/state.
static void mqttPublishWallState(const WallMqttRow* rows, int count, const WallSnapshot& wall) {
  mqttWallCapacity = wallMqttCapacity(rows, count);
  int problem = wallMqttProblem(rows, count) ? 1 : 0;
  if (problem != mqttLastWallState) {
    mqttLastWallState = problem;
    mqttClient.publish(mqttTopic(mqttResolvedDeviceId, "wall_problem").c_str(), 0, true,
                       problem ? "ON" : "OFF");
  }
  String attrs = wallMqttAttrsJson(
      rows, count, wallUpdatePhaseName((WallUpdatePhase)wall.updatePhase));
  if (attrs != mqttLastWallAttrs) {
    mqttLastWallAttrs = attrs;
    mqttClient.publish(mqttTopic(mqttResolvedDeviceId, "wall/attrs").c_str(), 0, true,
                       attrs.c_str());
  }
  // Wall text/state — shares mqttLastPublishedText with the own-facts path
  // (same topic; see the contract note above the leading gate).
  String text = wallMqttStateText(rows, count);
  if (text != mqttLastPublishedText) {
    mqttLastPublishedText = text;
    mqttClient.publish(mqttTopic(mqttResolvedDeviceId, "text/state").c_str(), 0, true,
                       text.c_str());
  }
}

// Wall surfacing, 5 s cadence (MQTT_WALL_INTERVAL_MS; cadence check lives
// inside): every board's problem sensor (#621), the wall's supply (#623) and
// flips (#619) — on a master on its own too, its row being the wall — and,
// with row boards (`active` = the rows table has rows), the wall problem
// sensor with the boards as its attributes and the wall's text/state.
static void mqttPublishWallSurfacing(const DisplaySnapshot& snap, bool active) {
  if ((int32_t)(millis() - mqttNextWallMs) < 0) return;
  mqttNextWallMs = millis() + MQTT_WALL_INTERVAL_MS;
  if (!mqttRetiredCleared) {
    mqttRetiredCleared = true;
    mqttClearRetiredEntities();
  }
  mqttSyncWallConfig(active);

  // Heap, not this task's stack: the snapshot and one row's unit facts.
  std::unique_ptr<WallSnapshot> wall(new WallSnapshot(wallStateGet()));
  std::unique_ptr<UnitFactsDoc> units(new UnitFactsDoc);
  // The verdicts of this very table, or none this round.
  std::unique_ptr<WallVerdicts> verdicts(new WallVerdicts);
  const uint32_t generation = wallStateRowsGeneration();
  const bool judged = wallVerdictsGet(*verdicts, generation);
  WallMqttRow rows[WALL_VERDICT_BOARDS];
  char texts[WALL_VERDICT_BOARDS][WALL_ROW_TEXT_MAX + 1];
  char hosts[WALL_VERDICT_BOARDS][CLUSTER_HOST_MAX_LEN + 1];
  const String ownAddress = WiFi.localIP().toString();
  const MqttWallPass pass{snap, *wall, *verdicts, judged, *units, millis(),
                          ownAddress.c_str(), WiFi.RSSI()};
  // A master on its own: its row is the wall.
  const bool alone = wall->rows.count == 0;
  const int count = alone ? 1 : wall->rows.count;
  if (generation != mqttBoardsGeneration) {
    wallMqttFlipsReset(mqttFlips);  // the boards are numbered by the table
    mqttBoardsGeneration = generation;
    mqttBoardsPublished = false;
  }
  bool flipsComplete = true;
  for (int i = 0; i < count; i++) {
    WallMqttRow& r = rows[i];
    r = WallMqttRow{};
    texts[i][0] = '\0';
    mqttRowIdentity(pass, alone, i, r, texts[i], hosts[i], sizeof(hosts[i]));
    r.host = hosts[i];
    r.text = texts[i];
    if (r.own) {
      mqttRowOwnFacts(pass, i, r, flipsComplete);
    } else {
      mqttRowRemoteFacts(pass, i, r, flipsComplete);
    }
  }

  // The boards (#621).
  if (!mqttBoardsPublished) {
    mqttBoardsPublished = true;
    mqttPublishBoardConfigs(rows, count);
  }
  mqttPublishBoards(rows, count);
  mqttPublishSupplyAndFlips(rows, count, flipsComplete);
  if (!active) return;
  mqttPublishWallState(rows, count, *wall);
}

// Periodic telemetry + per-unit health, 60 s (wraparound-safe; cadence
// check lives inside). Deviation from v1 (spec): no blocking bus poll from
// here — displayTask owns the bus; the attrs are probe-time facts from the
// snapshot, the faulty count is the wall's verdicts.
static void mqttPublishTelemetry(const DisplaySnapshot& snap) {
  if ((int32_t)(millis() - mqttNextTelemetryMs) >= 0) {
    mqttNextTelemetryMs = millis() + MQTT_TELEMETRY_INTERVAL_S * 1000UL;
    uint32_t freeHeap = ESP.getFreeHeap();
    uint32_t maxBlock = ESP.getMaxAllocHeap();
    int heapFragPct = (freeHeap > 0 && maxBlock <= freeHeap)
                          ? (int)(100 - (maxBlock * 100ULL) / freeHeap)
                          : 0;
    char buf[MQTT_TELEMETRY_MAX];
    MqttTelemetryFacts facts;
    facts.freeHeap = freeHeap;
    facts.heapFragPct = heapFragPct;
    facts.rssi = WiFi.RSSI();
    facts.unitErrors = snap.lastShowWriteErrors;
    facts.uptimeSec = millis() / 1000UL;
    facts.ntpSynced = clockIsTimeSynced(time(nullptr));
    facts.vccMin_mV = mqttSupplyMinMv;  // #366 vccMin, every board's units since #623 (the 5 s wall pass)
    facts.rebootTotal = unitFleetRebootTotal(snap.units, snap.displayWidth);  // #368 HA reboot-total sensor
    facts.anyJam = unitFleetAnyJam(snap.units, snap.displayWidth);            // #365 HA jam binary_sensor
    facts.maxExcess = unitFleetMaxExcess(snap.units, snap.displayWidth);      // #365 HA steps-excess sensor
    facts.supply = &mqttSupply;                                               // #623 weakest unit, under the floor
    size_t tn = buildTelemetryPayload(buf, sizeof(buf), facts);
    if (tn > 0 && tn < sizeof(buf)) {
      mqttClient.publish(mqttTopicTelemetry.c_str(), 0, false, buf);
    }

    // The units at fault by the wall's verdicts (WallWatch), on every board;
    // nothing is said before the first look.
    const WallFaultCounts faults = wallFaultCounts();
    if (faults.wall >= 0) {
      char fc[12];
      snprintf(fc, sizeof(fc), "%d", faults.wall);
      mqttClient.publish(mqttTopic(mqttResolvedDeviceId, "units_faulty").c_str(),
                         0, true, fc);
    }
    // Wear warning (#231): binary problem state + median/flagged attrs, both
    // computed from the same snapshot the health payload uses.
    WearAssessment wear;
    assessWear(snap.units, snap.displayWidth, wear);
    mqttClient.publish(mqttTopic(mqttResolvedDeviceId, "units_wear").c_str(),
                       0, true, wear.flaggedCount > 0 ? "ON" : "OFF");
    char wearAttrs[100];
    wearAttrs[0] = '{';
    size_t wn = buildWearJson(wear, wearAttrs + 1, sizeof(wearAttrs) - 2);
    if (wn > 0 && wn < sizeof(wearAttrs) - 2) {
      wearAttrs[wn + 1] = '}';
      wearAttrs[wn + 2] = '\0';
      mqttClient.publish(mqttTopic(mqttResolvedDeviceId, "units/wear").c_str(),
                         0, true, wearAttrs);
    }
    // Static, not stack (~2 KB doesn't belong on mqttTask's stack) and not
    // heap (a forever-periodic alloc/free is churn the memory policy
    // forbids). mqttTask-only access, so no guard needed.
    static char health[UNIT_HEALTH_JSON_CAP];
    size_t hn = buildUnitHealthJson(health, UNIT_HEALTH_JSON_CAP, snap.units,
                                    snap.displayWidth, faults.own >= 0 ? faults.own : 0,
                                    SFP_I2C_ADDRESS_BASE, millis());
    if (hn > 0 && hn < UNIT_HEALTH_JSON_CAP) {
      mqttClient.publish(mqttTopic(mqttResolvedDeviceId, "units/attrs").c_str(),
                         0, true, health);
    }
}
}

void mqttServiceTick() {
  // Overlay lifecycle runs BEFORE the initialised gate: web transients ride
  // this overlay on broker-less devices too (#219, v1 rule — calibration
  // transients exist without a broker). Cancel drains before start; expiry
  // just releases the clockTask gate — the 1 Hz ticker re-shows the active
  // mode's content by itself. The overlay is ONE slot with two producers
  // (this staged web path and the inbox's direct MQTT-text arm): within a
  // ~10 ms tick window the later writer silently replaces the earlier
  // dwell/text — v1's single-notification-slot last-write-wins, with the
  // tick boundary deciding "later" — an accepted race.
  if (cancelNotificationRequested.exchange(false)) cancelNotificationLocal();
  if (transientRequested.exchange(false, std::memory_order_acquire)) {
    MqttTextRequest req;
    req.hold = transientHoldRequested.load();
    req.priority = transientPriorityRequested.load();
    req.dwellSeconds = transientDwellRequested.load();
    startNotificationLocal(String(), req);
  }
  if (mqttNotification.active &&
      !notificationTick(mqttNotification, millis())) {
    mirrorNotification();
    SerialPrintln(F("Notification/transient expired — reverting"));
  }

  if (!mqttInitialised) return;
  if (mqttHandleOtaFreeze()) return;

  // Pump the client: socket reads/writes + all callbacks fire in here.
  mqttClient.loop();

  if (mqttDisconnectedEvent) {
    mqttDisconnectedEvent = false;
    connectedAtomic.store(false);
    mqttBackoffOnDisconnect(mqttBackoff, millis());
  }

  if (mqttBackoffShouldAttempt(mqttBackoff, millis(),
                               WiFi.status() == WL_CONNECTED,
                               mqttClient.connected())) {
    mqttBackoffAttemptStarted(mqttBackoff);
    SerialPrintln(F("MQTT: connecting to broker..."));
    if (!mqttClient.connect()) {
      // connect() failing here (CONNECT packet allocation) never reaches
      // the TCP layer, so no disconnect event will ever re-arm the
      // schedule — re-arm it ourselves or reconnects stop forever.
      SerialPrintln(F("MQTT: connect attempt failed to start — rescheduled"));
      mqttBackoffOnDisconnect(mqttBackoff, millis());
    }
  }

  if (mqttJustConnected) {
    mqttJustConnected = false;
    connectedAtomic.store(true);
    mqttBackoffOnConnect(mqttBackoff);
    SerialPrintln(F("MQTT: connected"));
    mqttClient.subscribe(mqttCmdTopics.text.c_str(), 0);
    mqttClient.subscribe(mqttCmdTopics.mode.c_str(), 0);
    mqttClient.subscribe(mqttCmdTopics.speed.c_str(), 0);
    mqttClient.subscribe(mqttCmdTopics.alignment.c_str(), 0);
    mqttClient.subscribe(mqttCmdTopics.restart.c_str(), 0);
    mqttClient.subscribe(mqttCmdTopics.clear.c_str(), 0);  // #616
    mqttClient.subscribe(mqttCmdTopics.install.c_str(), 0);  // #620
    mqttClient.subscribe(mqttCmdTopics.restartUnits.c_str(), 0);  // #624
    mqttClient.subscribe(mqttQuietCmdTopic.c_str(), 0);  // #227
    mqttClient.publish(mqttTopicAvailability.c_str(), 1, true, "online");
    publishMqttDiscovery();
    publishMqttDiagnostics();
    publishMqttTextAttrs();  // #618
    mqttNextTelemetryMs = millis();  // first telemetry immediately
    // Force a fresh publish of all event-driven state on this connection.
    mqttLastPublishedMode = "";
    mqttLastPublishedText = "\x01";
    mqttLastPublishedNotif = -1;
    mqttLastPublishedWidth = -1;
    mqttLastPublishedUnits = -1;
    mqttLastPublishedSpeed = -1;
    mqttLastPublishedAlignment = "\x01";
    // A fresh session reconciles the wall sensor's retained config and
    // re-publishes state/attrs on the first wall pass.
    mqttLastWallConfigured = -1;
    mqttLastWallState = -1;
    mqttLastWallAttrs = "\x01";
    mqttNextWallMs = millis();
    mqttRetiredCleared = false;
    mqttLastQuietState = -1;
    mqttLastUpdateState = "\x01";
    mqttNextUpdateMs = millis();
    mqttBoardsPublished = false;  // #621: the boards' configs again
    mqttLastFlips = 0xFFFFFFFFUL;
  }

  DisplaySnapshot snap = displaySnapshotGet();
  mqttPublishTextResults(snap, mqttClient.connected());  // #622
  if (!mqttClient.connected()) return;

  WebContentSnapshot content = webDisplayContentSnapshot();
  bool leading = wallShowActive();

  mqttPublishEventDrivenState(snap, content, leading);
  mqttPublishWallSurfacing(snap, leading);
  mqttPublishQuiet();
  mqttPublishUpdateState();  // #620

  if (discoveryClearRequested.exchange(false)) publishDiscoveryClear();

  mqttPublishTelemetry(snap);
}

bool mqttIsConnected() { return mqttInitialised && connectedAtomic.load(); }

bool mqttNotificationActive() { return notifActiveAtomic.load(); }

bool mqttNotificationHeld() { return notifHeldAtomic.load(); }

bool mqttNotificationAdmits(int priority) {
  return !notifActiveAtomic.load() || priority >= notifPriorityAtomic.load();
}

uint32_t mqttNotificationEndsEpoch() { return notifEndsAtomic.load(); }

// Must NOT be gated on mqttInitialised: broker-less devices still clear the
// (never-set) overlay harmlessly, and the web drain calls this untangled
// from MQTT state (v1 cancelActiveNotification rule).
void mqttCancelNotification() { cancelNotificationRequested.store(true); }

// See MqttService.h (#219/#616/#625).
void mqttStartNotification(long dwellSeconds, bool hold, int priority) {
  transientDwellRequested.store(
      dwellSeconds > 0 ? dwellSeconds : TRANSIENT_TEXT_DEFAULT_DWELL_SECONDS);
  transientHoldRequested.store(hold);
  transientPriorityRequested.store(priority);
  // The gate and the priority flip from the caller's task, not the tick: the
  // 1 Hz clock ticker must not sneak a mode re-show in behind the
  // just-queued transient during the <=10 ms until the tick stamps the
  // deadline, and a second text in that window is judged against this one.
  notifPriorityAtomic.store(priority);
  notifHeldAtomic.store(hold);
  notifActiveAtomic.store(true);
  transientRequested.store(true, std::memory_order_release);
}

void mqttStopForOta() {
  if (!mqttInitialised) return;
  stopForOtaRequested.store(true);
}

void mqttResumeAfterOta() {
  if (!mqttInitialised) return;
  resumeAfterOtaRequested.store(true);
}

void mqttNoteTextResult(MqttTextResultKind kind, const String& text, int priority, bool hold,
                        long dwellSeconds) {
  if (textResultQueue == nullptr) return;
  MqttTextResult r;
  r.kind = kind;
  r.priority = priority;
  r.hold = hold;
  r.dwellSeconds = dwellSeconds;
  strlcpy(r.text, text.c_str(), sizeof(r.text));
  if (xQueueSend(textResultQueue, &r, 0) != pdTRUE) {
    // Full: the oldest waits for a broker that is not there; make room.
    MqttTextResult dropped;
    xQueueReceive(textResultQueue, &dropped, 0);
    xQueueSend(textResultQueue, &r, 0);
  }
}

void mqttRequestDiscoveryClear() {
  if (!mqttInitialised) return;
  discoveryClearRequested.store(true);
}
