lvschouwen/split-flap/(commit log)

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2026-04-19 fix: offset unit I2C addresses past reserved 0x00, probe bus at boot (#9)
    Closes #7, closes #8.
    Background: the README documents DIP "0000" as Unit 1, which maps to I2C
    address 0x00. 0x00 is the reserved general-call address — a slave cannot
    be assigned to it, so the first unit in the chain never responded to
    targeted writes. This was the root cause of users reporting that
    out-of-the-box builds don't talk to the daughter boards.
    Fix (#7):
    - Unit/Unit.ino: getaddress() returns `I2C_ADDRESS_BASE + dipValue`, so
    DIP 0000 -> 0x01, DIP 1111 -> 0x10.
    - ESPMaster/ServiceFlapFunctions.ino: new `toI2cAddress(unitIndex)`
    helper, used by both writeToUnit() and checkIfMoving() so the
    0-based u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
    [Unit.ino]
2026-04-19 I2C bootloader phase 1: vendor + patch twiboot for Nano (#11)
    * feat(bootloader): phase 1 — vendor and patch twiboot for ATmega328p @ 16MHz
    First phase of issue #10 (I2C OTA for unit firmware). Sets up the
    bootloader itself; no sketch or master changes yet.
    Vendored upstream twiboot (GPLv2) into UnitBootloader/ with two small
    patches:
    - Makefile: default MCU -> atmega328p, fuses for 16MHz crystal
    (LFUSE=0xff), default programmer -> USBasp. Upstream defaults were for
    attiny85 @ 8MHz.
    - main.c: #ifndef-guard F_CPU and TIMER_IRQFREQ_MS so the Makefile can
    override per-MCU. At 16MHz the stock TIMER_IRQFREQ_MS=25 overflows the
    8-bit TCNT0 preload; override to 16 so the boot-window tim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
    [main.c]
2026-04-19 feat: master-side log viewer in the web UI (#14)
    Closes #13.
    Adds a 4KB in-RAM ring buffer on the master that captures every
    SerialPrint* call (regardless of SERIAL_ENABLE, because on the ESP-01
    SERIAL_ENABLE=true disables I2C — so in any real install you can't see
    serial output). Exposed via GET /log as text/plain.
    Implementation:
    - WebLog.h / ServiceWebLog.ino: ring buffer + a Print-derived
    WebLogPrinter so we inherit every overload Serial.print already knows
    (int, float, String, IPAddress, Printable, ...) for free.
    - HelpersSerialHandling.h: templates funnel to webLogPrinter as well as
    Serial. Skipped under UNIT_TEST so the native test harness doesn't
    pull in the ring buffer.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
    [HelpersSerialHandling.h, WebLog.h]
2026-04-19 feat(bootloader): phase 2 — sketch EEPROM identity + enter-bootloader opcode (#12)
    Second slice of #10. The Unit sketch can now:
    - Resolve its I2C address from EEPROM first (magic byte + address byte at
    slots 2,3), falling back to I2C_ADDRESS_BASE + DIP value if the magic
    isn't set. Future position-wizard writes to those slots.
    - Accept an I2C command opcode in the receive handler. Values >=
    AMOUNTFLAPS are commands (letters are 0..44 so command opcodes don't
    collide with legacy clients).
    - Handle CMD_ENTER_BOOTLOADER (0x80) by setting a flag; the main loop
    flushes Wire and triggers a watchdog reset. Twiboot takes over for
    ~1s at 0x29.
    - Defensive MCUSR clear + wdt_disable at s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
    [Unit.ino]
2026-04-20 feat: unit firmware I2C OTA, master web-OTA, LittleFS-free build, host-side test harness (#15)
    * feat: I2C firmware OTA (phase 3+4) + Windows one-time flasher
    Completes the bootloader project started in #10 and ships an end-user
    initial-flash tool.
    Phase 3 — master-side twiboot protocol client:
    - ServiceFirmwareFunctions.ino: streaming Intel HEX parser + twiboot
    I2C client (CMD_WAIT ping, CMD_ACCESS_MEMORY for chip info, write
    flash page, CMD_SWITCH_APPLICATION to exit).
    - POST /firmware/unit?address=0x01 accepts a multipart .hex upload;
    reboots the target unit, streams the hex page-by-page to 0x29,
    exits the bootloader, verifies the unit answers on its normal
    address post-flas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
    [Unit.ino, build_assets.py, main.c]
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2026-04-20 fix(unit): use SLEEP_MODE_IDLE so TWI stays responsive while sleeping
    SLEEP_MODE_PWR_DOWN clock-gates TWI on the ATmega328P, so the master's
    requestFrom() could return 0 bytes whenever a unit happened to be
    sleeping during a poll — the web log showed "<addr>:-1 / Try to wake
    up unit / A unit in the display is busy" in a tight loop.
    SLEEP_MODE_IDLE stops the CPU clock but leaves peripheral clocks
    running, so TWI continues to ACK and respond to read requests normally.
    Unit is mains-powered so the extra mA draw is immaterial.
    Also drop the post-wake TWCR reset + Wire.begin() re-init that were
    PWR_DOWN workarounds; in IDLE mode they would abort in-flight I2C
    transactions instead of fixing an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
    [Unit.ino]
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2026-04-20 fix(unit): flip ROTATIONDIRECTION so the drum rotates forward
    The drum was cycling backwards through the alphabet, making every letter
    change take a near-full revolution. Flipping the constant from -1 to +1
    matches the stock 28BYJ-48 wiring + coil-order used in the Stepper
    constructor on this board revision.
    The constant stays a #define with a comment: if a future build has
    mirror-wired coils the fix is to flip it back rather than re-wire.
    Regenerate ESPMaster/data/unit-firmware.hex so the master's PROGMEM
    auto-install bundle ships the fixed direction.
    Verified: pio run -e unit + pio run -e espmaster green, pio test -e
    native 25/25 pass. Hardware smoke test still needed on device.
    Closes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
    [Unit.ino]
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2026-04-20 feat: stamp firmware with git commit hash + show detected/max units
    - build_assets.py now writes BuildVersion.h with GIT_REV (short hash,
    suffixed -dirty if the tree has uncommitted edits). ESPMaster.ino
    picks that up as espVersion instead of the stale 2.2.0 literal, so
    the web UI reports exactly what's running on the device.
    - BuildVersion.h added to .gitignore (regenerated every build).
    - Units label shows "<detected> / <max>" so users can see at a glance
    whether every unit made it onto the bus. The JS unitCount global
    stays at the compile-time max so the textarea line-count maths is
    unaffected.
    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
    [build_assets.py]
2026-04-20 build: stamp firmware.bin copy with git rev in the filename
    Adds a post-build SCons hook: after PIO produces firmware.bin, drop a
    sibling copy named firmware-<short-rev>[-dirty].bin next to it so
    shipped artifacts are self-describing.
    The plain firmware.bin is kept (that's what PIO's upload tooling looks
    for); the stamped copy is the one to archive or scp.
    [build_assets.py]
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2026-04-20 feat: unit firmware version check via I2C (#28)
    Adds a CMD_GET_VERSION (0x81) opcode on the unit and a post-scan probe
    on the master. Units now embed GIT_REV in flash via a new pre-build
    script (Unit/build_version.py, same pattern as the master's
    build_assets.py) and return it as an 8-byte ASCII response.
    Master compares each sketch-mode unit's reply against its own GIT_REV
    and flags each as ok / outdated / unknown. Old firmware that predates
    the opcode silently drops it and returns the 1-byte rotation status,
    which the master detects as a short response (-> unknown).
    Results are stored per-unit (detectedUnitVersions +
    detectedUnitVersionStatus) and surfaced via /settings so the UI can
    sho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
    [Unit.ino, build_version.py]
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2026-04-20 fix: compare unit versions against bundled rev, not master's rev (#31)
    The bundled unit-firmware.hex is checked in, so the commit that
    regenerates it also bumps the master's GIT_REV — creating a one-commit
    skew where every freshly-installed unit reports OUTDATED even though
    it's running the current bundled firmware.
    Fix: plumb the unit build's rev through to the master at build time.
    - Unit/build_version.py now writes a sidecar Unit/.pio/build/unit/firmware.rev
    alongside BuildVersion.h.
    - ESPMaster/build_assets.py reads ESPMaster/data/unit-firmware.rev (copied
    from the unit build) and emits BUNDLED_UNIT_REV into BuildVersion.h.
    Falls back to master's own GIT_REV if the sidecar is m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
    [build_assets.py, build_version.py]
2026-04-20 Interactive unit calibration via web UI + auto-update outdated units (#34)
    * feat: interactive web-UI calibration + auto-update outdated units (#32)
    Adds four new I2C opcodes to Unit.ino (CMD_GET_OFFSET / CMD_SET_OFFSET /
    CMD_JOG / CMD_HOME), matching helpers in the master, four HTTP endpoints
    (/unit/offset GET+POST, /unit/jog POST, /unit/home POST), and a new
    Calibration card in the web UI built around an "Expect vs Reality" flow:
    pick a test letter, send it to every unit, then type what each drum is
    actually showing. Apply All reads each unit's current offset, computes the
    corrective delta (steps = (reality − expect) × STEPS/AMOUNTFLAPS), writes
    EEPROM, and re-homes — all over I2C, n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
    [Unit.ino]
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2026-04-20 chore: drop ArduinoLibraries/, Drivers/, EEPROM_Write_Offset/
    Three dead directories after the PlatformIO-only / web-UI calibration
    work:
    - ArduinoLibraries/ESP8266LittleFS.zip — Arduino IDE plugin, no longer
    used; master web assets are PROGMEM-compiled and units build via
    `pio run`.
    - Drivers/CH341SER-*.zip — Windows USB-to-UART drivers; users can grab
    these from the manufacturer, no reason to vendor them here.
    - EEPROM_Write_Offset/ — per-unit calibration sketch, fully replaced by
    the web UI's Calibration card (jog/home/get-offset/set-offset over I2C,
    introduced in #34).
    Also drops EEPROM_Write_Offset from the CI build matrix, rewrites the
    README "Set Zero Position Offset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
    [Unit.ino]
2026-04-20 feat: richer unit I2C protocol — CMD_GET_STATUS, CMD_REBOOT, broadcast CMD_HOME, opcode renumber
    Protocol rework on the unit/master I2C boundary (issue #47).
    Opcodes regrouped into semantic bands:
    0x80..0x8F queries (read-after-write)
    0x90..0x9F mutations (write with optional args)
    ENTER_BOOTLOADER (0x80) and GET_VERSION (0x81) stay fixed forever across
    protocol bumps because they are the cross-generation recovery path:
    GET_VERSION is how the master identifies outdated firmware, and
    ENTER_BOOTLOADER is how it pushes new firmware into a running unit.
    Moving either would break cross-version auto-update.
    Renumbered: HOME 0x85->0x90, JOG 0x84->0x91, SET_OFFSET 0x83->0x93.
    New opcodes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
    [Unit.ino]
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2026-04-21 feat: unit-side provisioning opcodes (#56 partial)
    Add three I2C opcodes to the unit firmware so the master can burn,
    clear, and identify units at runtime. Address reads already prefer
    EEPROM over DIP (Unit.ino getaddress()) — this fills in the write
    side so the position wizard can actually provision.
    - CMD_SET_I2C_ADDRESS (0x94): write magic+addr to EEPROM, reboot
    - CMD_CLEAR_I2C_ADDRESS (0x95): clear magic, reboot, fall back to DIP
    - CMD_IDENTIFY (0x96): non-blocking LED_BUILTIN blink for 3 s
    Also fixes a latent bug: LED_BUILTIN was never put in OUTPUT mode,
    so the existing SERIAL_ENABLE debug LED toggles only shifted the
    pull-up. pinMode is now called unconditionally in setup().
    Mast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
    [Unit.ino]
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2026-04-22 feat: SkeletonMaster minimal OTA bootstrap firmware (#61)
    Stripped-down ESP8266 master: WiFi + sync ESP8266WebServer +
    /firmware/master handler (with the TX-power reduce from #60) +
    /settings JSON + RTC pre-flash cookie resolution. No I2C, no web UI
    assets, no clock, no SoftAP fallback, no GET /.
    Builds at 310,187 bytes (30.3% flash) vs 373,937 bytes for the full
    firmware — 64 KB less for eboot to erase and copy during the vulnerable
    post-reboot phase. Shares flash layout (eagle.flash.1m.ld), EEPROM
    layout (SettingsEepromLayout.h), RTC boot-state struct + MAGIC, and
    WifiCredentials.h with ESPMaster, so an OTA hop through the skeleton
    preserves user settings and either firmware can resolve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
    [build_version.py]
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2026-04-22 chore: freeze ESP8266 firmware, retire SkeletonMaster (#62, #58)
    Pre-work for the ESP32-S3 / ESP32-H2 firmware port (meta #58).
    - ESPMaster/ frozen at tag v-esp8266-final (pushed separately).
    - SkeletonMaster/ deleted — no longer needed once ESP8266 is no
    longer being iterated on. Closes #61.
    - CI matrix in build.yml drops SkeletonMaster.
    - README + CLAUDE.md gain a Firmware Status callout pointing
    readers to the new MasterS3/ + MasterH2/ tracks.
    - Issues #54 (idle power), #56 (EEPROM provisioning), #57 (MQTT)
    re-targeted to the ESP32 platform via the esp32-port label.
    Closes #62.
    [build_version.py]
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2026-04-22 refactor(firmware): firmware/ parent + partitions + LittleFS + Preferences + Row 1..8 (#65)
    Phase 2 polish before we start Phase 3. No functional behavior change
    yet — scaffolds real-device persistence and codifies the row-indexing
    convention so we don't fight off-by-one bugs later.
    - All firmware projects moved under firmware/: ESPMaster, Unit,
    UnitBootloader, MasterS3, MasterH2, lib. Git-detected renames for
    the untouched files; main.cpp shows as delete+add because I rewrote
    the contents in the same commit.
    - CI matrix (.github/workflows/build.yml) uses firmware/${project},
    test job runs from firmware/ESPMaster.
    - Custom partition tables:
    MasterS3 (16 MB): 20K nvs + 8K otada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
    [partitions.csv]
2026-04-22 feat(pcb/master_v2): LED bar (19 fixed + 16 RGB) + Row 1..8 convention (#64)
    Specifies the status LED bar along the front-facing long edge of the
    Master v2 Rev B carrier, and locks in Row 1..8 as the human-facing
    indexing for the 8 TCA9548A downstream channels (silkscreen, web UI,
    logs, BOM). Brings PCB docs in line with the firmware-side constants
    in firmware/lib/common/config.h.
    LED bar components:
    - 19 fixed side-emit SMD LEDs (1204 right-angle, 4 mm pitch):
    5V rail, 3V3 rail, S3 heartbeat, H2 heartbeat, WiFi, Zigbee, BLE,
    I2C activity, UART (S3<->H2) activity, Row 1..8 activity, OTA,
    fault. Activity LEDs pulse-stretch 50 ms min on-time for visibility.
    - 16 SK6812-mini RGB strip, s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
    [BOM.csv]
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2026-04-22 feat(firmware): S3↔H2 UART link alive + lib/common restructure
    Phase 3b of #58 / closes #67.
    Link layer:
    - firmware/lib/common/src/frame_reader.{h,cpp}: stateful byte-to-frame
    reassembler driving splitflap::frame::decode. Caller-provided buffers,
    explicit overflow handling, reset() for port-reinit.
    - firmware/lib/common/test/test_frame_reader/: 8 Unity tests (accumulate,
    delimiter, back-to-back frames, stray 0x00, bit-flip, overflow + recovery,
    reset).
    - firmware/lib/common/test/test_link_loopback/: 3 end-to-end tests driving
    the full S3→H2→S3 codec stack without hardware.
    - 44/44 native tests pass (pio test -e native in firmware/lib/common).
    lib/common restructure:
    - Moved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
    [main.cpp]
2026-04-22 feat(MasterS3): WiFi + async web server + web log + minimal dashboard
    Phase 3c of #58 / closes #68.
    New modules under firmware/MasterS3/src/:
    - web_log.{h,cpp} — 8 KB in-RAM ring buffer, Print subclass. Uses
    portMUX_TYPE spinlock instead of noInterrupts() so it's safe across both
    S3 cores. Port of firmware/ESPMaster/WebLog.h with an ESP32-friendly
    synchronization primitive.
    - dev_log.{h,cpp} — DualLogger Print subclass fanning out to both USB-CDC
    Serial AND webLogPrinter. Every devLog.printf/println call ends up on
    the USB console and in GET /log.
    - wifi_setup.{h,cpp} — Preferences-backed WiFi bring-up. STA connect
    with 15 s timeout; if no creds or connect fails, falls ba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
    [main.cpp]
2026-04-22 refactor(pcb/master_v2): Rev B corrections + 120x80 placement mockup (#59)
    BOM fixes:
    - U5 ESP32-S3-WROOM-1-N16R8: wrong variant code -> C5092449
    - C_H2_BULK: 6.3V 0603 part stamped "10V" -> 0805 10V X5R / C49678
    Buck commitment:
    - Pick AP63300WU-7 (C2158012) over TPS54302DDCR; jack-only drop budget
    leaves TPS with <=0 mV transient margin. Rationale section added.
    - SW node copper <= 3 mm2, no thermal pour on SW pin.
    - Thermal copper on GND pin 2 only (>= 50 mm2), VIN pad secondary.
    H2 consistency:
    - Fix SCHEMATIC vs PINOUT mismatch: IO23 = U0RXD_H2 (RX),
    IO24 = U0TXD_H2 (TX), matching ESP32-H2 datasheet default.
    - JP_DEBUG_H2: drop "auto-reset compatible" claim; it's manual
    reset /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
    [BOM.csv, master_v2.kicad_pcb]
2026-04-22 refactor(pcb/master_v2): Rev B pre-fab cleanup — cheap fixes now
    Address all 7 actionable items of #70 (item 8 already verified).
    Item 3 — debounce/ESD shunt caps: C_SW1_DEB and C_SW2_DEB (100 nF
    X7R 0603) across the S3 RESET and BOOT buttons. SCHEMATIC §8 docs
    why the 100 nF is worth adding in parallel with the existing 1 µF
    C_ESP_EN (lower ESL path for a fast finger-tap ESD edge).
    Item 7 — mux bypass jumper footprint: SCHEMATIC §13 now explicitly
    picks 0402 0R resistor (P&P-friendly, hot-air reversible) over a
    bare three-pad solder bridge, with the rationale captured. BOM
    already carried JP_BYPASS_SDA/SCL as 0R 0402 DNP — just needed
    the decision recorded.
    Item 5 — silkscre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
    [BOM.csv]
2026-04-23 feat(bootloader): EEPROM-first address + 0x29 dual-match + do_spm hook (#72)
    PR 3/4 of the Phase 5 wizard work (#72). Patches the vendored twiboot
    so the bootloader:
    1. Resolves its listen address EEPROM-first (slot 2 magic 0xA5, slot
    3 address 1..126), falling back to DIP+offset. This matches
    Unit.ino's getaddress() exactly, so bootloader and sketch always
    agree on where the unit lives. Without this, the first time a user
    burns an EEPROM identity that differs from the DIPs, OTA breaks
    for that unit (sketch answers on the new address, bootloader still
    on the old one).
    2. Listens on the 0x29 broadcast-recovery address simultaneously, via
    TWAMR = (resolved_address XOR 0x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
    [main.c]
2026-04-23 refactor(pcb): split into v1/ (original 2022 board) and v2/ (rework)
    Moves only. No content changes. Content rewrite lands in the next commit.
    - PCB/{BOM_...2022, Gerber, PickAndPlace, EasyEDA_Source} -> PCB/v1/
    - PCB/MASTER_V2/* -> PCB/v2/
    Prep for RS-485 + 48V system redesign (#73).
    [BOM.csv, BOM_PCB_Splitflap_2022-03-11.csv, PCB_PCB_Splitflap_2022-06-04.json, PickAndPlace_PCB_Splitflap_2021-06-27.csv, SCH_SplitFlap_2022-06-04.json, master_v2.kicad_pcb, master_v2.kicad_sch]
2026-04-23 feat(pcb/v2): RS-485 over CAT6 + 48V distributed + STM32 unit + power telemetry
    Full system redesign replacing I2C + 5V star topology with industrial
    RS-485 over CAT6 daisy-chain + 48V power distribution.
    Master:
    - 2x RJ45 out ports, 64 units per bus, 128 units per master
    - 48V DC input via terminal block, 60V-rated reverse-polarity PMOS + TVS +
    polyfuse, LMR16030 48->5V buck, AP63300 5->3.3V buck
    - 2x SN65HVD75 RS-485 transceivers with 120 ohm termination + fail-safe
    bias at master end (always populated)
    - 2x INA237 per-bus current + voltage monitoring (I2C, 85V rated; INA219
    won't survive 48V), 50 mOhm high-side Kelvin-tapped shunts, ALERT pins
    routed to S3 for over-current trip h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
    [BOM.csv]
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2026-04-23 revert: undo #71/#72 Phase 5 wizard work — superseded by v2 rework
    This is a bundled revert of b69a308, dff9f58, and 250eb5c:
    - b69a308 "docs: move ESPMaster from frozen to maintenance mode (#71)"
    - dff9f58 "docs: revert ESPMaster maintenance-mode wording (#72)"
    - 250eb5c "feat(bootloader): EEPROM-first address + 0x29 dual-match + do_spm hook (#72)"
    Mid-session decision: both the master firmware and the unit hardware
    are being reworked (see the v1/v2 split on pcb-v2-rs485-48v branch —
    ESP8266 + Nano is v1 legacy; STM32G030 unit + RS-485 master port is v2
    forward direction). The Phase 5 EEPROM-identity wizard was scoped to
    v1 hardware that is no longer the active target, so the work is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
    [main.c]
2026-04-23 revert: undo #71/#72 session work on feature branch too
    Mirrors the master-side revert (b77d906) on this branch so the
    pcb-v2-rs485-48v feature branch has no lingering session work either.
    Without this, the firmware/v1/UnitBootloader/ content carried
    #72 PR 3's bootloader changes (EEPROM-first address resolution,
    TWAMR 0x29 dual-match, do_spm self-update hook, HFUSE=0xDA fuse
    bump) baked in via the 2ae8fe0 rename. PR 4 (492fe24 provisioning
    wizard) was already dropped via force-reset on this branch before
    this revert.
    Preserves the v1/v2 reorg (530d501, 737a7a8, 2ae8fe0) intact —
    PCB/v2/ and the firmware/v1/ vs firmware/v2/ layout are unaffected.
    Refs #72 (closing as not planned separat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
    [main.c]
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2026-04-24 docs(pcb/v2): scope-reset master PCB to handoff-ready brief; unit deferred
    Reworked PCB/v2 from the inherited dual-MCU + STM32-unit + TLC5947-LED-bar spec
    into a scope-cut master-only brief. Replaces the six stale docs with five
    fresh ones bound to a single source-of-truth decisions file.
    Scope locked:
    - Single MCU (ESP32-S3-WROOM-1-N16R8); H2 coprocessor dropped.
    - 4 RJ45 ports x 32-unit RS-485 chains (128 units total), MAX14830 over SPI.
    - Single 48V→3V3 buck (LMR36015FDDA); no 5V rail.
    - Per-bus TPS259827YFFR eFuse (60V, adj I_LIM ~1.7A) + INA237 telemetry.
    - LM74700-Q1 ideal-diode + SMDJ58CA TVS + SMBJ60A secondary clamp.
    - BSS138 inverter isolates FAULT LED from PROT_FAULT_OR (LM7470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
    [BOM.csv, MASTER_BOM.csv]
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2026-04-25 docs(pcb/v2): apply post-review electrical fixes to master design
    Resolves the master-side findings from the 7-agent external review
    (issue #76) and the scottbez1 audit:
    POWER_DESIGN.md:
    - Delete R_SERIES + D_SEC surge chain (R_SERIES dissipated 950W steady at
    4.5A — architectural error). Replaced by LM74700 native OVP per TI
    SLVA936 + single SMAJ51A on V48_RAIL post-Q1 (D_RAIL).
    - Add C_BOOT 100nF on LMR36015 (was missing — would brick high-side gate
    driver).
    - Add 1k series on LM74700 GATE per SLUA975 (Q_g stability).
    - Per-bus C_dVdT 10nF -> 100nF (1.4A inrush vs 1.7A trip on 32-unit bus;
    was 12.8A inrush, master couldn't bring up populated chain).
    - INA237 VBUS divider 100k/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
    [MASTER_BOM.csv]
2026-04-25 docs(pcb/v2): pivot unit PCB to backplane connector + apply post-review fixes
    Major architectural pivot per #76: unit drops 2x RJ45 jacks and gains a
    single 2x3 box-header to the backplane (which now lives in the case and
    distributes V48+RS-485 to 16 unit slots). Plus electrical fixes from the
    7-agent review and the scottbez1 audit.
    UNIT_DECISIONS.md (rewrite):
    - System-shape: backplane connector replaces 2x RJ45 IN/OUT.
    - MCU: STM32G030F6P6 TSSOP-20 -> STM32G030K6T6 LQFP-32 (TSSOP-20 didn't
    bond PA12/PB0/PB1 referenced in pin map).
    - Stepper driver: ULN2003A -> TPL7407L (MOSFET drop-in, ~0.5W less heat
    per unit at 300mA stepping per scottbez1 audit).
    - ESD array: SP0504BAATG -> SM712-0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
    [UNIT_BOM.csv]
2026-04-25 docs(pcb/v2): introduce backplane PCB design (new third board for v2)
    Per-case backplane PCB introduced post-#76 audit to replace the per-
    unit RJ45 daisy-chain. 16 unit-slots per case via a single backplane
    that distributes V48 + RS-485 to all 16 slots.
    - 4 segments per case at 320 mm each (1280 mm continuous board exceeds
    JLC standard fab limit; 4 segments fit comfortably).
    - 4 unit slots per segment via 2x3 box header sockets (2.54mm).
    - Per-slot 0.2A polyfuse for fault isolation (one stuck stepper coil
    doesn't kill the whole bus).
    - Inter-segment 6-pin board-to-board carries the bus through the case.
    - Case-level RJ45 on the outer segments (segment-1 IN, segment-4 OUT)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
    [BACKPLANE_BOM.csv]
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2026-04-25 docs(pcb/v2): apply ChatGPT external-review refactor (BOM corrections + layout gates + open-issue triage)
    External review of the post-pivot v2 bundle returned:
    - 14 BOM rows updated across master + unit + backplane (REVIEW_VERIFIED
    for confirmed LCSC numbers; REVIEW_BLOCKER + CHECK for unverified ones).
    Master U1, U17 corrected; U13-U16 LCSC verified; U2, U3-U6, U_POR,
    U7-U10, U12, Q1, L2-L5 reverted to CHECK with explicit blocker reasons.
    Unit U1, U2, U3, U4, U5, U6, Q_REV LCSC verified; D2 reverted to CHECK.
    Backplane polyfuse + RJ45 lines + R_TERM annotated.
    - DECISIONS docs gain new sections:
    * MASTER_DECISIONS: BOM/sourcing gates, LAYOUT_CONSTRAINT pre-layout
    checklist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
    [BACKPLANE_BOM.csv, MASTER_BOM.csv, UNIT_BOM.csv]
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2026-04-25 docs(pcb/v2): apply ChatGPT pass-2 review (60V eFuse blocker + remaining CHECK rows + layout-readiness DRC)
    Pass-2 surfaced one real "this won't work" finding plus closed several
    remaining CHECK rows from pass-1 (#80).
    Critical blocker:
    - TPS259827YFFR (TPS25982 family, 24V class) and TPS25981QWRPVRQ1
    fallback (30V class) are ELECTRICALLY INVALID on the 48V bus.
    - Active candidate: TPS26600PWPR LCSC C544399 HTSSOP-16-EP (4.2-60V
    industrial eFuse). NOT drop-in: schematic + footprint + I_LIM +
    dV/dt rework required at schematic capture.
    - DSBGA-10 manufacturability gate is now moot (HTSSOP-16-EP is standard
    JLC PCBA package).
    Other CHECK row resolutions:
    - VERIFIED: U7-U10 INA237AIDG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
    [BACKPLANE_BOM.csv, MASTER_BOM.csv, UNIT_BOM.csv]
2026-04-25 pcb(v2): hobby-scale redesign — 4 rows × 16 units, ESP32-S3 master, no backplane, UID + IDENTIFY addressing
    De-scope from 48V / 4-bus / 128-unit / MAX14830 architecture to a simpler
    hobby-scale system designed around the actual 64-unit display:
    - 1 master PCB: ESP32-S3-WROOM-1-N16R8, USB-C native CDC, 12 V (master only),
    4 RS-485 row ports — 3 native UARTs + 1 from SC16IS740 expander.
    - 4 RS-485 buses, one per row of 16 units.
    - 64 unit PCBs (4 × 16), identical hardware. STM32G030K6T6 required for
    96-bit silicon UID, 28BYJ-48 12 V motor, A1101ELHL hall sensor, on-board
    12->3.3 V LDO, SN65HVD75 transceiver, IDENTIFY tact button + LED.
    - No backplane: per-row daisy-chain harness (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
    [BACKPLANE_BOM.csv, MASTER_BOM.csv, UNIT_BOM.csv]
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2026-04-25 pcb(v2): lock motor driver (TPL7407L) and IDENTIFY LED (dedicated yellow)
    Resolve the last two schematic-capture blockers:
    - Motor driver: TPL7407L primary, ULN2003A as PCBA-time substitute via
    shared 16-SOIC footprint.
    - IDENTIFY LED: dedicated yellow 0805 + dedicated MCU GPIO (not shared
    with FAULT).
    Schematic capture is now unblocked. All UNIT_BOM rows are concrete; no
    TBDs remain.
    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
    [UNIT_BOM.csv]
2026-04-25 pcb(v2): single 12V/15A brick — master sources row power over combined 6-pin cables
    Drop the 4× per-row brick design in favor of one 12V/15A SMPS feeding the
    master, which distributes 12V to each row via a per-row polyfuse and
    outputs combined power+signal on a single 6-pin connector per row.
    Master changes:
    - Input: 2-pin screw terminal (15A capable), 15A slow-blow fuse, AOD409
    reverse-block (DPAK), 470 uF bulk, SMAJ15A TVS.
    - 4× row outputs: 6-pin shrouded box headers carrying 12V/12V/GND/GND/A/B
    (doubled power pins for 2.54 mm pin current capacity).
    - 4× per-row polyfuses (Bourns MF-MSMF400, 4 A hold).
    - 4× row PWR LEDs hardwired post-polyfuse for diagnostics.
    - HT7833 LDO Kelv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
    [MASTER_BOM.csv]
2026-04-25 pcb(v2): switch from harness to DIN-rail bus PCB with pogo pins
    Replace the per-row cable harness with a passive DIN-rail bus PCB.
    Units clip onto a 35 mm DIN rail and contact the bus traces via 4
    pogo pins on the unit's underside. No connector or cabling between
    unit and bus.
    Per-row distribution: 2× 300 mm bus PCBs daisy-chained (fits within
    JLC's 400 mm standard fab limit). Same PCB design across all 8
    boards in a 4-row system.
    Trace layout: 12V (5 mm wide) and GND (5 mm wide) on the outside
    edges as guard rails for the differential pair; A (1 mm) and B
    (1 mm) in the middle. Wide power/GND for current capacity, narrow
    signal traces (microamp current). ENIG plating on contact strips
    for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
    [BUS_PCB_BOM.csv, MASTER_BOM.csv, UNIT_BOM.csv]
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2026-04-25 docs(pcb/v2): KiCad schematics for unit and master (best-effort hand-written)
    Add KiCad schematic files for unit (~25 components, 473 lines) and
    master (~50 components, 739 lines). All hand-written from S-expression
    spec — paren-balance verified but semantic correctness not validated
    without running KiCad.
    Approach: components placed on coarse grid, all connections via global
    net labels (no visible wires). Custom symbols defined inline as stubs
    with pin maps from datasheets. Standard KiCad library symbols
    (Device:R/C/LED/etc., Switch:SW_Push, Connector_Generic) used where
    possible.
    Caveats documented in PCB/v2/kicad/README.md:
    - Likely visual placement issues (will need rearranging in Ea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
    [master.kicad_sch, unit.kicad_sch]
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2026-04-25 docs(pcb/v2): drop broken .kicad_sch files; keep .net netlists
    Hand-written .kicad_sch files were failing KiCad's parser ("Expecting
    '(' " errors) due to schema differences between KiCad versions.
    Removed them rather than leaving broken artifacts in the repo.
    Kept:
    - .net netlist files (bus_pcb, unit) — simpler format
    - SCHEMATIC_*.md markdown specs — the ground truth for wiring
    - BOM CSVs with LCSC numbers
    If .net files also fail to import in EasyEDA, manual schematic
    capture from the markdown is the reliable fallback.
    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
    [bus_pcb.kicad_sch, master.kicad_sch, unit.kicad_sch]
2026-04-26 docs(pcb/v2): hand-off readiness — apply datasheet + consistency findings
    Per handoff-readiness audit (#84), apply BLOCKING corrections from the
    datasheet pin-numbering sweep and doc-consistency audit:
    - ESP32-S3-WROOM-1: rewrite pin map (Table 3-1 verified). IO9–IO13 were
    off by 1; IO45/46/47/48/IO0/IO21 were off by ~13 pins. Make strap
    defaults explicit (IO0 pull-up, IO3 pull-up, IO46 explicit external
    10 kΩ pull-down). Antenna keep-out dimensioned 18.6 × 5 mm.
    - SC16IS740: XTAL on pins 5/6 (not 3/4). Drop the design bug where RTS
    drove DE and /RE simultaneously — tie /RE permanently low and let
    firmware discard TX echo (standard half-duplex practice).
    - STM32G030: move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
    [UNIT_BOM.csv]
2026-04-26 docs(pcb/v2): hand-off ready — apply independent review findings
    Independent blind review (subagent in Fiverr-freelancer role) returned
    11 Critical + 12 Should-fix findings. Applied:
    - Q1 P-FET reverse-block topology corrected on BOTH master and unit
    (drain ← INPUT, source → LOAD, gate → GND via 10 kΩ). Earlier draft
    had source/drain swapped — body diode pointed wrong direction;
    protection would have been defeated.
    - J1 input terminal swapped from Phoenix MKDS 1.5/2 (rated 8 A — under
    the 15 A spec) to KF7.62-2P (16 A) with DECA MA231 5 mm as backup.
    - Master BOM: added missing PHY decap (C_decap_phy ×4 100 nF on the
    four SN65HVD75 Vcc pins). Harmonized ESD refdes D8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
    [MASTER_BOM.csv]
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2026-04-26 docs(pcb/v2): apply merged Gemini + ChatGPT review feedback
    Critical (ChatGPT correcting Gemini):
    - Drop HT7833 from BOTH boards (6.5V max VIN, would die at 12V).
    Master = K7803-500R3 buck. Unit = LDL1117S33 SOT-223 (40V VIN).
    - Rewrite SC16IS740 TSSOP-16 pinout (Gemini's was wrong; ChatGPT's
    NXP map locked, includes I2C/SPI mode-select pin tied to GND).
    - Rewrite STM32G030 K-32 pin map: pin 20 = PC6, USART1 PA9/PA10/PA12
    go directly at pins 19/21/23, no SYSCFG remap.
    - Delete PG_KEY 5th polarization pogo + bus pad (collided with PG1
    + spring on FR-4 isn't a hard interlock). Polarization moved to
    asymmetric 3D-printed DIN clip from MakerWorld (one per unit).
    - Lock JST-VH 4-pin (B4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
    [BOMS.csv, BUS_PCB_BOM.csv, MASTER_BOM.csv, UNIT_BOM.csv]
2026-04-26 docs(pcb/v2): apply internal audit fixes for final review round
    Fixes the 6 inconsistencies surfaced by 4 parallel internal-audit agents
    before sending to Claude + ChatGPT for final external review.
    - MASTER.md: polyfuse package 1812 SMD → 2920 (line 22 contradicted
    Power section + schematic, which both correctly say 2920; 1812 family
    does not support 4 A hold)
    - MASTER.md: add Z1 BZT52C12 12 V Zener gate→source clamp on Q1
    (AOD409) to block diagram + Power section. Was only in schematic;
    now mirrors the (mandatory) Z1 fix on the unit Q1 (AO3401A)
    - SCHEMATIC_MASTER.md: ASCII block diagram had stray HT7833 box; replace
    with K7803 to match the rest of the file (and the actual U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
    [BOMS.csv, BUS_PCB_BOM.csv, UNIT_BOM.csv]
2026-04-26 docs(pcb/v2): apply Gemini + ChatGPT external review fixes
    Final external review round (issue #86). Two AIs reviewed independently;
    findings cross-validated where they overlapped, datasheet claims verified
    against ST + NXP datasheets where they didn't.
    CRITICAL FIX (LDL1117 — caught by ChatGPT, internal audit missed):
    - VIN max corrected: was claimed 40 V, actually 18 V op / 20 V abs max
    per ST datasheet. 12 V brick + 15 V TVS clamp still fits inside 18 V
    op max so the design works, but the 40 V claim was wrong everywhere.
    - Pinout corrected: pin 1 = GND, pin 2 = VOUT (= tab), pin 3 = VIN
    (LM1117 family convention). Earlier doc had pin 2 / pin 3 swapped
    AND labelled the tab as GND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
    [BOMS.csv, BUS_PCB_BOM.csv, MASTER_BOM.csv, UNIT_BOM.csv]
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2026-04-28 fix(firmware/v1/Unit): write calOffset under noInterrupts to avoid torn ISR read
    calOffset is a 2-byte int on AVR; the assignment in CMD_SET_OFFSET tail
    ran outside the existing noInterrupts() block, so the TWI ISR firing
    between the two byte-stores could return a torn int16 to a follow-up
    CMD_GET_OFFSET. Move the store inside the critical section; EEPROM.put
    stays outside since it's not on the ISR read path.
    Closes #91
    [Unit.ino]
2026-04-28 build(firmware/v1): ship 1 MB and 4 MB master.bin variants
    Update.begin()'s ESP.checkFlashConfig(false) refuses an OTA when the
    running firmware's bin header claims a larger chip than the chip really
    is. A device stuck on a 4 MB-headed image therefore cannot accept any
    1 MB-headed upload — and vice versa — even though the source is
    identical. We now build both layouts so users can pick the matching
    bin without dragging out the USB cable.
    - New env espmaster_4m (board=esp12e, eagle.flash.4m.ld). Existing
    espmaster keeps esp01_1m + eagle.flash.1m.ld.
    - Common settings hoisted to [espmaster_common]; each env extends it.
    - default_envs builds both so CI still catches breakage on either.
    -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
    [build_assets.py]
2026-07-04 fix(firmware/v1/Unit): volatile ISR globals, status saturation, EEPROM/speed clamps (#93)
    - receivedNumber/stepperSpeed marked volatile (written in Wire ISR, read in loop; same class as aa21fd4)
    - CMD_GET_STATUS byte 7: saturate at 0xFF instead of wrapping (check ran after uint8_t truncation)
    - calOffset from EEPROM clamped to +/-STEPS, garbage falls back to 0
    - legacy 2-byte path clamps speed byte to >= 1 (Stepper::setSpeed divides by it)
    [Unit.ino]
2026-07-04 fix(firmware/v1/Unit): atomic status fields, repeatable homing from magnet, jog heat stamp (#96)
    - status fields read by requestEvent() ISR are now volatile and written
    under noInterrupts (16-bit writes could be torn mid-store)
    - calibrate() starting inside the hall window steps out and re-finds the
    edge from the same side instead of accepting the parked position;
    hall-stuck-at-0 falls through to the existing 3*STEPS failure path
    - jog stamps lastRotation so a rotation can't start back-to-back with
    sustained jogging; jogs themselves stay ungated (calibration UX)
    [Unit.ino]
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2026-07-04 docs(pcb/v2): apply pre-fab review corrections (#102)
    Multi-agent review pass (#99). Blocker fixes:
    - STM32 LQFP-32 pin table rewritten from DS12991 (pins 1-17 were wrong;
    single VDD/VDDA at pin 4, dedicated NRST at pin 6)
    - SM712 pinout corrected in both schematic docs (pin 3 = GND)
    - NTD2955 deleted as Q1 alternate (0.18 ohm, 26-67 W); AOD409 thermal
    warning added, topology decision -> #103
    - stale kicad/*.net netlists removed (encoded rejected pre-review design)
    - LDO power-tree pin fix, rejected-polyfuse checklist fix, 500 mA buck
    alternates -> 1 A
    Design changes from review:
    - 4 RS-485 buses -> 2 (SC16IS740 deleted: can't clock 250 kbaud from
    14.7456 MHz, RTS drives bus at powe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
    [BUS_PCB_BOM.csv, MASTER_BOM.csv, UNIT_BOM.csv]
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2026-07-04 refactor(firmware/v1/Unit): flash-resident letter table, drop dead desiredLetter (#109)
    RAM 654 -> 284 bytes static, flash -1.9 KB (Arduino String class code
    no longer linked). Also makes displayedLetter volatile ahead of #106's
    ISR read.
    [Unit.ino]
2026-07-04 feat(firmware/v1): closed-loop letter verification via CMD_GET_LETTER 0x84 (#106)
    Unit replies displayedLetter + bitwise complement; after a show settles
    the master reads every written unit back and re-sends once on mismatch.
    Old-firmware units reply with the 1-byte status fallback and are
    skipped. showMessage's duplicated wait loop extracted into
    waitForDisplayToStop().
    [Unit.ino, UnitProtocolHelpers.h]
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2026-07-05 feat(firmware/v1/ESPMaster): per-device network identity — chip-id defaults + EEPROM device name (#125)
    One shared firmware image for multiple displays on one LAN:
    - New DeviceIdentity.h (natively tested): name validation, chip-id
    default composition, EEPROM->default resolution order, SSID length
    static_asserts (24-char name + -rec/-ota/-setup suffixes <= 32).
    - resolveDeviceIdentity() at the top of setup() — before the quiet-OTA/
    recovery dispatch, with its own guarded EEPROM read (v5+ blob only).
    - Consumers switched to the resolved identity: WiFi hostname (both WiFi
    modes), mDNS, recovery AP (<name>-rec), quiet-OTA AP (<name>-ota),
    captive portal (<name>-setup), MQTT client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
    [DeviceIdentity.h]
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2026-07-05 feat(firmware/v1/ESPMaster): Home Assistant mode select over MQTT
    Adds a fifth HA discovery entity: a select (text/clock) with command
    topic splitflap/<id>/mode/set and a retained state topic
    splitflap/<id>/mode published whenever the mode changes from any
    source (boot, reconnect, HA command, web UI). An explicit mode switch
    — from HA or the web UI — cancels an active notification instead of
    waiting out the dwell (the confusion that motivated this issue).
    onMqttMessage now dispatches on topic (heap-free strcmp, explicit
    match for both command topics so unknown topics fail closed); mode
    commands use the same copy+flag+torn-copy-guard pattern as text. The
    retained state republish runs bef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
    [MqttHelpers.h]
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2026-07-07 feat(mqtt): Stage A — 13 read-only HA entities + event-driven state (#132)
    Expands the Home Assistant MQTT integration from 5 entities to 18, all
    read-only, so the display is genuinely useful in HA.
    MqttHelpers.h (natively tested):
    - Telemetry JSON grows to {heap,heapFrag,rssi,unitErrors,uptime,ntp} —
    continuous health only, sampled every 60 s.
    - Discovery refactored to a generic buildEntityDiscovery() + a bounds-
    guarded MQTT_DISC_APPEND macro; mqttDiscMeta() is the single source of
    truth for component + object-id so config topic and uniq_id can't drift.
    - New entities: heap-frag, uptime, NTP-synced, current-text,
    notification-active, display-width, units-responding, IP, SSID,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
    [DisplayWidth.h, MqttHelpers.h]
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2026-07-07 refactor(unit): DRY the fractional-step loop + real bounds guard (#136)
    Extract stepFlaps(int) from the two near-identical fractional-step loops in
    rotateToLetter() and hoist the constant (float)STEPS/AMOUNTFLAPS (2038/45)
    into file-scope STEPS_PER_FLAP_WHOLE / STEPS_PER_FLAP_FRAC — it was recomputed
    every step, and float division is slow on AVR. Behaviour is byte-identical to
    the originals (same rounding, same missedSteps carry), verified by build and
    toolchain-level disassembly.
    Replace the always-true `if (posLetter > -1)` check (and its dead else) with a
    real 0..AMOUNTFLAPS-1 bounds guard, evaluated before the overheat gate so a
    corrupted target can never drive the step loop into a ru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
    [Unit.ino]
2026-07-07 feat(unit): report busy while a letter is deferred by the overheat gate (#135)
    When a letter command arrives within OVERHEATINGTIMEOUT (2 s) of the previous
    rotation's start, rotateToLetter() defers the move (loop() re-issues it once the
    gate clears; the target is latched in receivedNumber). Previously the deferral
    was invisible to the master: the motor was off so currentlyrotating stayed 0,
    and showMessage()'s waitForDisplayToStop() -> #106 verify pass would read the
    stale displayedLetter, declare a mismatch and burn a wasteful re-send (and in a
    tight timing window leave the wrong letter standing).
    Report busy (currentlyrotating = 1) while a gated target is pending. This flows
    through the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
    [Unit.ino]
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2026-07-07 feat(unit-health): per-unit diagnostics web card (#45) + MQTT faulty telemetry (#137)
    Shared poll cache (pollUnitHealth, loop() context only) reads each sketch
    unit's CMD_GET_STATUS and builds one JSON snapshot served to both the web
    card and Home Assistant:
    - #45: GET /units/health (cached JSON) + POST /units/health/refresh (arms a
    loop()-drained re-poll; 503 while a firmware flash owns the Wire bus).
    Maintenance-tab table shows fw status, uptime, lifetime brownout/watchdog,
    last-home result and JS-decoded MCUSR; faulty rows flagged. Bootloader/
    silent units render as gaps, surfacing the "16/16 but N flap" case.
    - #137: new append-only DISCOVERY_UNITS_FAULTY HA sensor — integer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
    [MqttHelpers.h, UnitHealth.h]
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2026-07-07 fix(unit): zero lifetime reset counters on fresh EEPROM (#139)
    Fresh/erased AVR EEPROM reads 0xFF, so the brownout/watchdog counter slots
    (EEPROM 4/5) reported 255 on every freshly-provisioned unit — and the
    saturating increment guard then pinned them there, flagging every unit
    faulty in the #45/#137 health view.
    Gate the counters behind a dedicated init magic (EEPROM addr 6): when absent,
    zero both counters once and stamp the magic; otherwise read as before. Units
    must be reflashed with this firmware (bundled-hex regen) to clear the false
    255s.
    [Unit.ino]
2026-07-08 feat(mqtt): expose detected unit firmware rev per slot in units/attrs (#140) (#141)
    The master already reads each unit's 8-char git short-rev over I2C
    (detectedUnitVersions[i]) but only published the derived fw match/mismatch
    status code, not the rev string. In steady state units converge to
    BUNDLED_UNIT_REV, so the rev only diverges during a reflash-mismatch window
    (units not yet updated, or a failed reflash) — exactly when you want to see
    which rev a unit is stuck on.
    - buildUnitHealthJson (UnitHealth.h) gains a const char (*versions)[9] param
    and emits "rev":"<8char>" inside each valid-unit block. Flows to both the
    MQTT units/attrs json_attributes payload and GET /units/health (web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
    [UnitHealth.h]
2026-07-08 fix(unit): mark currentlyrotating volatile (ISR-shared, #143)
    `currentlyrotating` is read inside the Wire.onRequest ISR (requestEvent()'s
    status/idle byte the master polls) and written all over loop()
    (startMotor/stopMotor/calibrate, and the overheat-gate early return in
    rotateToLetter). It was the one ISR-shared status var never marked volatile,
    though every sibling (displayedLetter, receivedNumber, stepperSpeed, …) was,
    citing LTO caching.
    Under LTO the compiler can't see the async ISR read and may serve a stale 0,
    so the master's waitForDisplayToStop() concludes idle prematurely and runs
    the next message / #106 verify read against a still-rotating drum. Value is
    0/1, so the non-atomic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
    [Unit.ino]
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2026-07-08 refactor(fw): single source of truth for master↔unit protocol (#149)
    The opcodes, I2C address base and 45-char alphabet were duplicated across
    two independently-compiled sketches plus data/script.js, kept in sync by
    comment only — drift silently sent wrong characters or mis-decoded opcodes
    and nothing in CI caught it.
    New firmware/v1/shared/SplitFlapProtocol.h is the single source: SFP_CMD_*
    opcodes, SFP_I2C_ADDRESS_BASE, SFP_I2C_GENERAL_CALL_ADDRESS, SFP_ALPHABET
    and SFP_FLAP_AMOUNT (derived as (int)(sizeof(SFP_ALPHABET)-1), so the count
    can never disagree with the alphabet). Both firmwares #include it via a new
    -I ${PROJECT_DIR}/../shared build flag (ESPMaster, its native test env, an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
    [SplitFlapProtocol.h, Unit.ino, build_assets.py]
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2026-07-08 fix(master): restore browser OTA uploads — hash firmware client-side, md5-capable recovery/OTA pages (#160)
    #144 made ?md5= mandatory on /firmware/master, which killed every
    browser-based flash path: the web UI sent no digest and the plain HTML
    forms on the recovery and quiet-OTA pages could never send one — a
    device boot-looping into recovery could not be reflashed from a browser
    at all.
    - data/md5.js: vendored SparkMD5 v3.0.2 (MIT), baked into WebAssets
    PROGMEM like the other UI assets (+3 KB gz flash). Hashing verified
    against md5sum on binary blobs + known vectors.
    - data/script.js: Flash Master now reads the file, hashes it, and posts
    /firmware/master?md5=<digest>&v=<rev>; th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
    [build_assets.py]
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2026-07-08 fix(unit): clamp SET_OFFSET to one revolution + close two ISR-sharing gaps (#171, #172, #173)
    Three unit-side fixes batched for a single bundled-hex regen:
    #171 — SET_OFFSET accepted any int16 and persisted it; the boot-time
    getOffset() clamp never ran on the write path. An offset past ±STEPS
    makes calibrate()'s single blocking stepper.step(calOffset) outrun the
    8 s watchdog (~2.94 ms/step at HOMING_RPM=10 → >8 s past ~2700 steps):
    watchdog reset mid-rotation, stale huge value still reported by
    GET_OFFSET. Now: new shared SFP_OFFSET_LIMIT_STEPS (2038, static_assert-
    pinned to the drum's STEPS), unit drops out-of-range writes (bad-command
    counter), master /unit/offset rejects them with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
    [SplitFlapProtocol.h, Unit.ino]
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2026-07-08 refactor(master): extract POST / settings validators to SettingsValidation.h (#153)
    Pure per-field validators (alignment, device mode, flap speed, timezone,
    MQTT host/user/port/password) move out of the POST / handler into a
    header with no globals — slot lengths are passed in by the caller, so
    the header stays EEPROM-layout-independent. The handler is now a thin
    adapter: trim/normalize, validate, stage. New native suite
    test_settings_validation (16 tests, real LEN_* constants) pins every
    boundary, including the deliberate strtol quirk inherited from
    isNumber() (leading whitespace parses — ' 5' is a valid flap speed) so
    the extraction cannot silently tighten accepted inputs.
    cpp-reviewer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
    [SettingsValidation.h]
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2026-07-08 fix(ui): calibration 'Send to all' shows a transient pattern instead of persisting text mode (#165)
    New calibrationText POST field rides the MQTT-notification show-then-revert
    state (10 min dwell): a clock display resumes clocking on expiry, EEPROM is
    never touched, and an explicit mode change or message send cancels early.
    The cancel path no longer routes through the mqttInitialised-gated deferred
    flag (it would deadlock the transient on broker-less devices — reviewer
    catch); both callers are loop-context, so it cancels the loop-owned state
    directly.
    [MqttHelpers.h]
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2026-07-08 fix(build): pin UTF-8 for all build_assets.py text IO (Windows flasher CI)
    The Windows runner decodes text as cp1252; the new UI assets contain UTF-8
    punctuation, so the flasher exe build failed in verify_js_alphabet's
    read_text(). Regression test scans the script for unpinned text IO.
    [build_assets.py]
2026-07-08 fix(fw): alphabet tail matches physical drum order — '!' before '?', '-' last (#177)
    Hardware-verified: the drums are printed :.!?- while the table said :.-?!
    (inherited from the original project; #149 transcribed it faithfully).
    Units are index-based so their behavior is unchanged.
    [SplitFlapProtocol.h]
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2026-07-09 feat(v2): settings layer on NVS — store seam, sanitize-on-load, write-only password (#185)
    TDD: test_settings_store written first (12 cases — v1-parity defaults,
    round-trips, corrupted-value fallback, empty-password-keeps-secret).
    SettingsEepromLayout.h + test_eeprom_settings retired from v2 (NVS
    provides integrity natively; slot lengths survive as SettingsLimits.h
    validation bounds). Native suite 108/108 green; S3 build green.
    main.cpp now boots off NVS-loaded settings + resolved identity.
    [NvsSettingsStore.h, Settings.h, SettingsLimits.h, SettingsStore.h, main.cpp]
2026-07-09 docs(pcb-v2): 2026-07-09 decision sweep — THVD1410, card-edge interface, proto-first plan (#179, #100, #183)
    - #179 resolved: THVD1410 SOIC-8 on unit + master carrier (3-5.5 V,
    true failsafe, ±18 kV IEC bus ESD). Master 1k/1k failsafe bias and
    all SM712 arrays deleted; DE pull-downs stay. 250 kbaud locked.
    - #100 interface decided: card-edge (g000ze precedent), pogo system
    withdrawn. 2x5 keyed 2.54 mm dual-row: 12V/GND/A/B/spare mirrored
    on both card faces, GND first-make, bevel + hard gold. Mock-up
    re-scoped to insertion kinematics.
    - Bus PCB re-scoped to socket backplane; bus/master pogo-era docs
    bannered as superseded/amended; unit schematic + BOM updated.
    - Epic #183 Phase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
    [UNIT_BOM.csv]
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2026-07-09 feat(v2): dual-core task skeleton, N16R8 memory map, native OTA rollback (#187)
    Full FreeRTOS decomposition per the 2026-07-09 spec: displayTask (core 1,
    future exclusive I2C owner, stub worker) + clockTask; netTask (web drain) +
    mqttTask on core 0 with AsyncTCP; static stacks/queues; DisplayCommand in /
    DisplaySnapshot out (pure headers, natively tested); POST / message path
    enqueues ShowText end-to-end. largeAlloc() PSRAM policy, WebLog ring 2K->32K.
    N16R8 board profile, custom 16MB partition table (64K nvs, 2x4M OTA slots,
    coredump, ~7.8M reserve) with boot_app0 offset override, bootloader app
    rollback enabled via custom_sdkconfig (unused IDF components removed).
    Review fixes: webLogInit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
    [partitions_splitflap_16MB.csv]
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2026-07-09 feat(v2): WiFi join + captive portal + mDNS — netTask supervision, NVS credentials (#188)
    Stored-credential join with captive-portal fallback for the ESP32-S3
    master, v1-parity timings (30 s join -> 300 s <name>-setup portal ->
    reboot-retry):
    - WifiPolicy.h: pure join/portal state machine, natively tested incl.
    millis-rollover; Connected phase doubles as the LAN "move to another
    network" path.
    - WifiService.cpp: netTask executor — owns all radio/NVS work; async
    handlers only stage through one mutex (config/reset/scan + the portal
    captive-redirect URL, so handlers never touch the WiFi class).
    - WifiScanJson.h: deduped strongest-first scan list, capped at 20,
    natively tested inc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
    [NvsSettingsStore.h, Settings.h, SettingsLimits.h, SettingsStore.h, SettingsValidation.h, Tasks.cpp, WebEndpoints.cpp, WebEndpoints.h]
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2026-07-10 feat(v2): clock/NTP — configTzTime + 1 Hz mode ticker on clockTask (#192)
    clockServiceApplyTz() = configTzTime(settings.timezonePosix, pool.ntp.org),
    applied at boot, on WiFi join, and rebootlessly when a timezone POST lands
    (v1 #48 parity). clockTask (core 1) becomes the real mode ticker: pure
    decideClockTick() in ClockPolicy.h re-shows the active mode's content —
    clock time or the retained runtime inputText — deduped against the
    DisplaySnapshot text plus an in-flight lastQueued marker, so clock mode
    costs one DisplayCommand per minute. Unsynced clock holds content instead
    of flapping epoch-1970 times (deliberate v1 deviation). Message POSTs are
    mode-gated (text only, v1 parity) and e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
    [ClockPolicy.h, ClockService.cpp, ClockService.h, DisplayCommand.h, Tasks.cpp, WebEndpoints.cpp, WebEndpoints.h, WifiService.cpp]
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2026-07-10 feat(v2): reserve factory rescue slot + bootloader factory-reset on GPIO 4 (#193)
    2 MB factory app partition after coredump (storage shrunk to 0x5D0000;
    nvs/otadata/app0/app1 offsets unchanged, verified against the built
    partitions.bin). Bootloader factory reset: GPIO 4 low 5 s through reset
    erases otadata only — CONFIG_BOOTLOADER_DATA_FACTORY_RESET is explicitly
    emptied because IDF defaults it to "nvs", which would wipe WiFi
    credentials on rescue. Layout + config invariants pinned by
    tests/test_partition_table.py; GPIO 4 committed as the future carrier's
    reset button in PCB/v2.
    [partitions_splitflap_16MB.csv]
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2026-07-10 fix(v2): bump clockTask stack 2048 -> 4096 (#196)
    First devkit bench showed clock HWM at 124 B free on every boot -
    newlib's one-time tzset/localtime TZ parse runs deep inside the 1 Hz
    ticker. Match the other domain tasks; flat +2 KB static SRAM.
    [Tasks.cpp]
2026-07-10 feat(v2): boot banner prints partition diagnostics (#198)
    Running slot + esp_ota image state + otadata boot target, factory
    rescue-slot presence, and the live partition table — bench-verified on
    the devkit: captured the app1->app0 flip, PENDING_VERIFY->confirm, and
    a table matching partitions_splitflap_16MB.csv.
    [main.cpp]
2026-07-10 feat(v2): WS2812 status LED — wifi/OTA state colors + dim heartbeat (#199)
    Pure StatusLedPolicy.h (11 native tests): upload purple > pending-verify
    orange > boot white / joining yellow / portal blue (red when creds are
    stored — failed join) / connected dim green breathing. Glue on GPIO 48
    (HW-678 bench-verified), ticked from netTask at 10 Hz, write-on-change.
    Master carrier BOM gains the WS2812 (D13 + decap, 3.3 V-variant
    constraint noted; candidate to subsume discrete D2/D3).
    [MASTER_BOM.csv]
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2026-07-10 fix(v2): rescue exit ranks slots by NVS confirm records (#200)
    The app-descriptor date/time (and version) freeze at framework-assembly
    time under pioarduino hybrid builds, so every image carries the same
    stamp and /rescue/exit tie-fell to app0 — a stale master could be
    re-armed. Master now stamps a per-slot confirm record on first netif-up
    (slotRec0/slotRec1 in the shared "splitflap" NVS namespace: monotonic
    seq + image sha256 + git rev; wire-contract format "1|...", pure
    SlotRecord.h with parse-only copy RescueSlotRecord.h). Rescue accepts a
    record only when its sha256 matches the slot's actual image
    (esp_partition_get_sha256 both sides) and ranks by seq — confirm
    recency, so deliberate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
    [OtaService.cpp, RescueSlotRecord.h, RescueSlots.h, RescueWeb.cpp, RescueWeb.h, SlotRecord.h, main.cpp]
2026-07-10 fix(v2): build the bootloader from source — factory reset was never delivered (#201)
    pioarduino's custom_sdkconfig rebuilds app-side IDF libs only; the
    second-stage bootloader is always packaged PREBUILT from
    esp32-arduino-libs (stock Arduino config: rollback yes, factory reset
    no), so the #193 GPIO 4 escape hatch has been a silent no-op on every
    board — caught by the first hardware bench of that path.
    New firmware/v2/Bootloader/ (framework=espidf, same pinned platform,
    IDF 5.5.4 = exact prebuilt match) builds it with factory reset (GPIO 4
    low 5 s, otadata-only erase), rollback carried over, and INFO-level
    logs so the detection message is visible; flash header verified
    byte-identical to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
    [main.c, use_custom_bootloader.py]
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2026-07-10 feat(v2): I2C unit bus — displayTask drives real units: text, probe, health (#203)
    Slice A of the I2C port (epic #183 / meta #58), per the approved spec
    (docs/superpowers/specs/2026-07-10-v2-i2c-unit-bus-design.md):
    - UnitBus.cpp/.h: the only Wire toucher (SDA 8 / SCL 9, 100 kHz),
    displayTask-exclusive; straight port of v1's bench-proven transactions
    and timing (2 ms opcode settle, 30 s stuck-unit timeout, closed-loop
    CMD_GET_LETTER verify + one resend round)
    - FlapFrame.h (pure, tested): text -> per-unit letter indices with v1
    alignment semantics; approved deviation: unknown char -> blank; plus the
    exact v1 web->unit speed map
    - UnitHealth.h (v2 copy): UnitFacts in the DisplayS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
    [DisplayIpc.h, FlapFrame.h, Tasks.cpp, TwibootProtocol.h, UnitBus.cpp, UnitBus.h, UnitHealth.h, UnitProtocolHelpers.h]
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2026-07-11 feat(v2): calibration + provisioning over I2C — queue-native ops, op-result slot, twiboot probe guard, stop abort (#204)
    Slice B of the I2C port (#58/#183). All ops are DisplayCommands; web
    handlers validate (pure MaintenancePolicy.h) + enqueue + return {"seq":N};
    GET /unit/op-result serves the snapshot's MaintResult slot. Offset is a
    probe-time UnitFact; address ops are compound (burn → twiboot-safe settle
    → reprobe → postcondition grade). displayTask probe-inhibit deadline
    covers every runtime probe (v1 #88). /stop = abort flag (set-before-
    enqueue) + broadcast home. UI awaits critical ops; controls lock while
    polling. cpp-reviewer + codex cross-review applied; 337 native + 27
    pyte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
    [DisplayCommand.h, DisplayIpc.h, MaintenancePolicy.h, Tasks.cpp, Tasks.h, UnitBus.cpp, UnitBus.h, UnitHealth.h]
2026-07-11 feat(v2): persistent flash log on the storage partition + Logs tab (#206)
    LittleFS on `storage` (mounted by FlashLog.cpp): tee of the SerialPrint/
    web-log stream into log.txt/log.prev.txt (1 MB each — weeks of history).
    Per-line timestamps ([HH:MM:SS] after NTP sync, [+secs.ms] before), day
    marker lines at NTP-synced date changes, synchronous boot marker with
    reset reason. Producers stage under a mutex; netTask is the single flash
    writer (flush ~5 s / half-buffer, open-append-close). Web: GET /log/flash
    (+?prev=1), staged POST /log/flash/clear; new Logs tab hosts the live
    ring viewer + flash log cards. cpp-reviewer approved (3 doc Mediums
    fixed: partition-table tenant note, SerialPrintln f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
    [partitions_splitflap_16MB.csv]
2026-07-11 fix(v2): recover the I2C bus after a failed unit read — stale IDF read-state panics the next probe (#207) (#208)
    ESP-IDF 5.5's esp_driver_i2c clears its bus-level contains_read flag only
    when a read's ISR receive path completes. A failed requestFrom (address
    NACK, timeout) leaves it stale, and the next zero-length probe runs the
    ISR receive handler against a transaction with no read op — the RX FIFO
    is copied through a NULL data pointer (StoreProhibited crash-loop).
    Tear down and rebuild the bus (Wire.end + unitBusInit) after every short
    read, in all three requestFrom sites: queryUnit, isUnitInBootloader, and
    checkIfMoving's no-reply path before its wake-up ping (that ping is
    exactly th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
    [UnitBus.cpp]
2026-07-11 fix(v2): boot scan requires a status read before trusting a probe ACK
    IDF 5.5's i2c_master_probe returns OK for outcomes it doesn't map, so a
    floating bus scans as a full row of phantom units (16 units responding
    with nothing connected). A slot now only counts as a live sketch unit
    after a successful 1-byte rotation-status read — the one op every unit
    firmware generation answers; phantoms NACK it (and the #207 recovery
    inside checkIfMoving handles the failed read). Bootloader-mode units are
    unaffected: they were already gated on a successful chipinfo read.
    Fixes #209
    [UnitBus.cpp]
2026-07-11 fix(v2): drop 'Request for Settings Received' log spam
    The web UI polls /settings periodically; since #206 the SerialPrint
    stream is teed to the persistent flash log, so the v1-ported line floods
    log.txt with zero-information entries and rotates away real events.
    Fixes #210
    [WebEndpoints.cpp]
2026-07-11 fix(v2): drop per-request web log noise, reword action lines as events
    Page/poll requests (home, health check, form bracketing, wifi scan, unit
    health refresh) logged zero-information 'Request ... Received' lines into
    the persistent flash log. Removed. State-changing actions (reboot, wifi
    config/erase, reset-units, stop) keep one line each, reworded to describe
    the event — the flash log's forensic record of why the device rebooted or
    credentials vanished.
    Fixes #211
    [WebEndpoints.cpp]
2026-07-11 fix(v2): tee the boot banner into the web/flash log
    flashLogInit()/webLogInit() run before the banner, but the banner,
    printBootDiagnostics() and the setup() progress lines used raw
    Serial.print* — the Logs tab started mid-boot at 'NTP sync' and the
    chip/partition/identity block was serial-only. Convert the one-shot boot
    lines to the SerialPrint* tee via a new varargs SerialPrintf overload
    (the existing single-value template keeps winning two-argument overload
    resolution, so existing callers are unchanged). The 5 s heap ticker
    stays raw Serial by design: teeing it would churn ~1 MB/day through the
    1 MB flash log.
    Fixes #212
    [HelpersSerialHandling.h, main.cpp]
2026-07-11 fix(v2): canary probes detect a lying I2C bus — floating bench beat the status-read gate
    Bench on 443eeee still scanned 16/16 phantoms: a floating/held-low bus
    clocks back valid-looking 0x00 bytes, so #209's 1-byte status read
    passes. No single read value discriminates; the signature of a lying bus
    is that it ACKs every address. Probe two reserved-range canary addresses
    (0x3B, 0x7B — no unit can exist there) before the scan: both ACK →
    declare the bus floating, log it, report 0 units. One ACK only warns, so
    a glitch on a real display can't blank the scan. Restores the property
    v1's bit-banged master had for free (write_start refuses a non-idle
    line).
    Fixes #213
    [UnitBus.cpp]
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2026-07-11 feat(v2): pure reflash seams — plan, progress, producer gate (#205)
    ReflashPlan.h: reboot/flash target derivation, v1 batch constants,
    progress state machine, job-level MaintResult grading. DisplayIpc:
    ReflashProgress in the snapshot, displayAcceptsCommand() gate (Stop-only
    during a job), progress JSON. DisplayCommand: ReflashUnits opcode with
    ResetUnits-style baked re-show params. UnitHealth: unitFwStatusFromRev()
    (8-char v1 semantics). 374 native tests green.
    [DisplayCommand.h, DisplayIpc.h, ReflashPlan.h, UnitHealth.h]
2026-07-11 feat(v2): twiboot flash client in UnitBus + real fw grading in the probe (#205)
    unitBusFlashUnit(): ping retry, chipinfo verify, page write+readback with
    one rewrite (v1 #110), exit + post-boot CMD_REBOOT (v1 #113); abort flag
    polled per page — any failure leaves the unit in twiboot for recovery.
    Probe now grades fwStatus against BUNDLED_UNIT_REV instead of pinning 2.
    [UnitBus.cpp, UnitBus.h]
2026-07-11 feat(v2): reflash job orchestration in displayTask (#205)
    runReflashJob(): sweep → twiboot settle → rescan (deliberate #88-guard
    bypass, every pinned unit is flashed+exited) → batched flash with settle
    waits (v1 #138) → final reprobe. ReflashUnits case drains the queue
    (Stop survives) and re-shows the baked text; boot runs the same job with
    the narrower outdated-only sweep (v1 semantics) before the command loop,
    gate closed against the racing WiFi join. clockTask skips ticks while a
    job runs. Boot scan log now distinguishes 'no units responding'.
    [ReflashPlan.h, Tasks.cpp, UnitBus.cpp, UnitBus.h, WebEndpoints.cpp, WebEndpoints.h]
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2026-07-11 fix(v2): reflash hardening — drain after gate-close (both entry points), health JSON cap headroom, JS poll resilience (#205)
    [Tasks.cpp, UnitHealth.h]
2026-07-11 fix(v2): Codex review — Stop ordering in the drain, drain-time message gate (#205)
    Drain now collects every stale command and re-sends a single surviving
    Stop LAST, so nothing queued behind it mutates the display ahead of the
    cancel. Message drain in webEndpointsLoop re-checks the reflash gate
    (text stays retained; the mode ticker re-shows it after the job).
    [Tasks.cpp, WebEndpoints.cpp]
2026-07-11 fix(v2): cpp-review HIGH — abort exits flush the partial batch settle (#205)
    Both cancel paths now fall through to the trailing-batch idle wait, so a
    just-flashed unit's 15 s homing window is honored even on /stop (the
    'never abort-shortened' invariant held on the cancel path too). Spec
    wording fixed: Stop is the ONE gate exception.
    [Tasks.cpp]
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2026-07-12 chore(v2): retire v1 recovery/quiet-OTA boot-mode remnants (#220)
    A/B rollback (#190) + the rescue app (#193/#195) replace v1's recovery
    and quiet-OTA boot modes on the S3 — the 501 stubs for
    /firmware/recover-mark and /firmware/ota-mode, the unused -rec/-ota AP
    suffixes, and the stale comments pointing at those modes go away
    instead of waiting for a port that will never happen.
    [DeviceIdentity.h, WebEndpoints.cpp, WifiPolicy.h]
2026-07-12 feat(v2): MQTT + Home Assistant slice on espMqttClient (#224)
    v1's wire contract unchanged (22 discovery entities, availability LWT,
    five command topics, same device id) so a migrating display keeps its HA
    entities. mqttTask owns the client (UseInternalTask::NO — the default
    would task onto the display core); commands apply through mutex-guarded
    web-domain setters; text/set is a show-then-revert overlay gating
    clockTask; /mqtt/discover runs its blocking mDNS pass in netTask's drain.
    Pure lifecycle policy (backoff, topic dispatch) natively tested.
    Deviations from v1 (spec'd): no bus polls from the MQTT loop, NVS boot
    counter for diag/boots, MQTT_DEVICE_MODEL build flag keeps MqttHelpers.h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
    [DisplayIpc.h, MqttHelpers.h, MqttLifecyclePolicy.h, MqttService.cpp, MqttService.h, Tasks.cpp, Tasks.h, WebEndpoints.cpp]
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2026-07-12 docs: slim CLAUDE.md v2 slice bullets to pointers; fix UnitBus.h /stop ordering doc
    Closes #225. Each ported-slice bullet is now 1-2 lines (what + issue # +
    owning files); cross-file invariants (UnitBus Wire exclusivity, twiboot
    probe-inhibit, reflash producer gate, shared-LittleFS/sole-writer) move
    to Hard rules. UnitBus.h's header claimed the /stop abort flag is set
    after enqueue — the code (and the load-bearing ordering rationale in the
    /stop handler) set it BEFORE enqueue with 503 rollback; header corrected.
    [UnitBus.h]
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2026-07-12 fix(v2): port v1's I2C_BUFFER_LENGTH=256 flag — twiboot page writes were truncated to the 128-byte Wire default
    Twiboot's page-write is 132 bytes (4 header + 128 page) in one Wire
    transaction. v1 carries -DI2C_BUFFER_LENGTH=256 for exactly this; the
    #205 port copied the code but not the flag, so on the S3 the last 4
    bytes of every page were silently dropped (Wire.write past the buffer
    returns 0, unchecked, and the truncated burst still ACKs) and every
    page-0 verify failed — 0/16 on the first live reflash.
    Guards so the flag can't silently regress: static_assert on
    I2C_BUFFER_LENGTH in UnitBus.cpp (build fails loudly if the flag is
    dropped) and a queued-bytes check in twibootWriteFlashPa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
    [UnitBus.cpp]
2026-07-12 fix(ota): reject concurrent /firmware/master uploads with 409 + sanitize ?v= (#191)
    Both trees: a TU-static owner-request pointer guards the live Update
    session; an overlapping upload is marked rejected via its _tempObject
    (freed by the request destructor) and answered 409 without touching the
    owner's shared rejection state, MQTT freeze, TX power (v1) or Update
    session. Owner cleared in the completion handler, onDisconnect backstop,
    and v1's 30 s stall watchdog frees the slot too.
    v2 ?v= now goes through sanitizeIntendedVersion (shared rule with the
    boot load path, natively tested) instead of a bare length-truncate.
    [Settings.h, WebEndpoints.cpp]
2026-07-12 feat(v2): port v1's transient/mode service — clock-mode messages show with dwell (#219)
    Web transients now ride the #224 show-then-revert overlay instead of
    being dropped: the drain queues the ShowText and arms the dwell via
    mqttStartNotificationDwell() (atomic handshake into mqttTask; gate flips
    in the caller's task so the 1 Hz clock ticker can't sneak a re-show in).
    Overlay lifecycle moved above mqttServiceTick's initialised gate — v1
    rule: calibration transients exist without a broker. Async-side reflash
    409 / queue-full 503 gates now cover transientText like inputText, with
    a drain-time reflash re-check. Cancel drains before start, so a POST
    carrying mode + transient lands on the tra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
    [MqttService.cpp, MqttService.h, WebEndpoints.cpp]
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2026-07-12 feat(unit,v2): per-unit revolution wear odometer + relative wear alerts (#231)
    Unit (Nano): uint32 revolution counter — every drum move funnels through
    stepCounted(); persisted every 128 revs via a 16-slot wear-leveled EEPROM
    ring (magic-gated, #139 pattern); new opcodes GET_ODOMETER (5-byte reply,
    XOR^0xA5 checksum so pre-odometer firmware fails gracefully) and
    RESET_ODOMETER (physical rebuilds). New native test env for the Unit
    project (test_odometer, 13 tests) + CI step.
    v2 master: odometer in UnitFacts (probe + health-poll reads), relative
    wear flagging pure in WearPolicy.h (> max(2x median, median+10k), lower
    median), wear object spliced into /units/health, /unit/reset-odometer op
    on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
    [DisplayCommand.h, DisplayIpc.h, MqttHelpers.h, MqttService.cpp, SplitFlapProtocol.h, Tasks.cpp, Unit.ino, UnitBus.cpp]
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2026-07-13 fix(v2): review folds for #245/#246 — counter scope, atomics, worst-case test
    Batch cpp-reviewer gate over slices B+C (no CRITICAL/HIGH): maintenance
    ops now count into the bus tx/err counters (twiboot page stream and its
    expected programming NACKs stay excluded — documented scope); err-vs-tx
    denominator note; busTx/busErr, mqttDropCounter and lastSyncUptimeS moved
    from volatile to std::atomic per the file idiom; worst-case JSON test uses
    the true longest reset-reason string. CLAUDE.md gains the #245/#246 lines.
    [ClockService.cpp, MqttService.cpp, UnitBus.cpp]
2026-07-13 fix(v2): web UI polish — banner rev, CPU tile labels, yellow reflash strip, heap tile mislabel (#249)
    [main.cpp]
2026-07-13 feat(v2): reflash batch size 2 -> 4 — halves settle-waits; bench-gated on unit brownout counters (#250)
    [ReflashPlan.h]
2026-07-13 fix(flashing): ota-flash.sh — honest network-failure verdicts + one retry; log OTA throughput device-side (#248)
    [WebEndpoints.cpp]
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2026-07-13 fix(v2): review folds — SSE change-loss window, tz-save race, mirror rebuild timer leak; untrack clangd cache
    [WebEndpoints.cpp]
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2026-07-13 feat(unit+v2): drift detection + silent re-home, physical-letter readback, self-test op (#263 #264 #265)
    Unit: UnitDrift.h/UnitSelfTest.h pure headers (natively tested), per-step
    hall watch in stepFlaps, calibrate drift measurement, idle re-home with
    60 s cooldown, GET_DIAG/GET_SELF_TEST/START_SELF_TEST opcodes.
    v2 master: diag decode into health poll + /units/health drift fields with
    displayed==intended mismatch, SelfTest display op riding the {"seq":N}
    contract, /unit/self-test(-result) endpoints, Maintenance-tab self-test
    button + Drift column.
    [DisplayCommand.h, DisplayIpc.h, SplitFlapProtocol.h, Tasks.cpp, Unit.ino, UnitBus.cpp, UnitBus.h, UnitDrift.h]
2026-07-13 fix(unit+v2): review folds — park on failed self-test, poll-loop freshness/re-arm, no mismatch while moving, outcome log label (#263 #264 #265)
    [DisplayIpc.h, Tasks.cpp, UnitDrift.h, UnitHealth.h, UnitMotion.ino]
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2026-07-13 fix(v2): stamp displayed==intended verdict at diag-poll time, not render time (#267)
    Boot-time/stale phys compared against the live frame flagged phantom
    mismatches on every text column. displayApplyUnitFacts now stamps
    UnitFacts.mismatch when the poll and the standing frame are the same
    instant; buildUnitHealthJson only serializes it.
    [DisplayIpc.h, UnitHealth.h, WebEndpoints.cpp]
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2026-07-13 feat(v2): ClusterLayout.h — pure N-row grid layout engine (#271)
    Part of the multi-display cluster epic #270 (spec
    docs/superpowers/specs/2026-07-13-multi-display-cluster-design.md).
    Member-table {row,col,width} validation + derived grid (overlaps, gaps,
    missing rows rejected; coincident members = mirror, allowed), greedy
    word-wrap with hard-split of over-long words, v1 alignment math, slicing
    into pre-positioned per-member segments followers render verbatim, and
    cluster clock rows (time / date %d %b %y / blank). 34 native tests.
    [ClusterLayout.h]
2026-07-13 feat(v2): cluster follower — policy, /cluster endpoints, producer gate, banner (#272)
    Part of the multi-display cluster epic #270.
    ClusterFollowerPolicy.h (pure, 27 native tests): Standalone→Clustered→
    Grace(25 s contact-fresh)→LocalFallback(2 min) with seamless reclaim,
    boot-into-Grace on persisted membership, epoch/seq staleness armor
    (duplicates still feed the grace timer), commitAt flip-sync delay with a
    5 s bogus-timestamp clamp.
    ClusterFollower.cpp glue: module mutex, NVS membership (clLeader*/clRow,
    drained in netTask), single staged render slot enqueued at commitAt
    (retries through reflash gate / full queue). Endpoints /cluster/join,
    /render, /ping, /leave, /health on the a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
    [MqttService.cpp, SettingsJson.h, Tasks.cpp, WebEndpoints.cpp, main.cpp]
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2026-07-13 feat(v2): cluster leader — clusterTask fan-out, member table, producer reroute + fake-follower harness (#273, #278)
    ClusterLeaderPolicy.h (pure, 16 native tests): member-table NVS wire
    format (host|row|col|width;…, empty host = the leader's own row) with
    strict shape parsing, per-member supervision (join → render → ping,
    1-2-4-8 s backoff, degraded after 3 fails, recovery via fresh join,
    ping/render 409 → re-join without backoff), fixed-shape reply extraction.
    ClusterLeader.cpp + clusterTask (core 0, static 6144-word stack): the
    sole outbound cluster HTTP caller (esp_http_client, 1.5 s LAN timeouts,
    sequential fan-out) — netTask can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
    [Tasks.cpp, WebEndpoints.cpp, main.cpp]
2026-07-14 fix(v2): review gate — same-epoch rejoin keeps seq armor, host validation, fan-out polish (#272, #273)
    Batch reviewer gate over the branch diff (cpp-reviewer + codex cross-
    review; no CRITICALs).
    - HIGH (both reviewers): clusterFollowerJoin no longer resets lastSeq on
    a same-epoch rejoin — the degraded-recovery path could otherwise let a
    delayed retry of an old render regress the wall. Fixed in the policy,
    the fake-follower python twin, and both test suites.
    - Member-table hosts now reject non-visible-ASCII at parse time (they
    become esp_http_client URLs; same bar as the follower's leaderHost).
    - WiFi.localIP().toString() moved out of the 100 ms tick into the Join
    branch (stea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
    [MqttService.cpp, WebEndpoints.cpp]
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2026-07-14 feat(v2): fleet firmware convergence — leader streams its running slot to mismatched followers (#276)
    Rev mismatch (join handshake, BOTH directions — uncluster first to
    bench-test a follower build) makes clusterTask stream the leader's
    running partition (esp_image_verify for exact length, MD5 over the
    flash) into the follower's existing POST /firmware/master?md5=&v=,
    chunked across ticks so renders/pings keep flowing. Strictly sequential
    and health-gated: next member only after the previous rejoins on the new
    rev; a rollback/timeout burns one of 3 attempts, then the member is
    updateBlocked. Sequencing pure in ClusterRolloutPolicy.h (natively
    tested); rollout state + per-member flags in /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
    [WebEndpoints.cpp]
2026-07-14 fix(v2): review gate — bounded rollout stall, memberIndex guards, progress hygiene, discovery slot cap (#274, #276)
    cpp-reviewer HIGH: rollout chunk writes now ride the 1.5 s LAN timeout
    (only the finalize round-trip — the follower's whole-image MD5 verify —
    keeps the 10 s budget, documented as the accepted bounded stall).
    MEDIUMs: memberIndex bounds guards at the three use sites; progress
    bytes zeroed on every Idle transition; imageVerifyFailed surfaced in
    /cluster/status so a latched verify failure isn't mistaken for
    nothing-to-converge. codex LOWs: discovery drain no longer burns result
    slots on self/nameless answers; fake follower gained the real
    endpoint's concurrent-upload 409 gu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
    [WebEndpoints.cpp]
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2026-07-14 feat(v2): HA cluster surfacing — degraded sensor, member attrs, grid capacity; follower availability-only (#277)
    Leader: cluster_degraded binary problem sensor (config published on the
    leading transition, blanked on disable) with per-member availability +
    the deferred #276 rollout state as json_attributes; width publishes the
    grid's total units and text/state the '\n'-joined wall. Follower: while
    clustered, only availability/LWT + discovery stay live — state and
    telemetry publishes stand down. Pure logic in v2-only ClusterMqtt.h;
    MqttHelpers.h untouched (v1-tracking copy), #224 wire contract otherwise
    unchanged.
    [MqttService.cpp]
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2026-07-14 fix(v2): review gate — retained-config reconcile, SSE tick generation gate, selfRow -1, poll collapse fallback (#277)
    codex HIGH: mqttLastClusterConfigured starts/-resets to -1 so a fresh
    session reconciles — a former leader coming up standalone now blanks the
    stale retained cluster config. codex MED: /settings gains clusterLeading
    and the poll tears down a wall the dead SSE stream couldn't collapse.
    cpp-reviewer HIGH: grid-generation counter gates the 100 ms SSE tick —
    the wall reconstruction (mutex + String churn) now runs only when own
    text, generation, or leading actually changed. cpp-reviewer LOW: selfRow
    is -1 when the leader owns no row, so the health strip never anchors
    under a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
    [MqttService.cpp, SettingsJson.h, WebEndpoints.cpp]
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2026-07-14 feat(v2): cluster single pane of glass (#294) + leader failover promote (#295)
    The ping is piggybacked in both directions instead of adding a message
    bus (research-backed: Sonos-style single coordinator stays):
    - Health up: ping/join replies carry width/detected/faulty/faultMask/
    wear/rev (pure ClusterDigest.h + ClusterMemberHealth parse); leader
    folds them into the shared clusterStatusJson serializer -> health
    strips under EVERY wall-mirror row, HA cluster_degraded attrs.
    - Digest down: leader piggybacks gen/leader/table/rows/status on the
    ping body; follower stores it raw, serves GET /cluster/digest, and
    its own page renders the full wall read-only (any pane is the pane
    of gla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
    [WebEndpoints.cpp]
2026-07-14 fix(v2): #294/#295 review gate — digest trust gate, promote TOCTOU, suppress-leave leak, browser clamps
    Batch cpp-reviewer + codex cross-review findings on the single-pane diff:
    - CRITICAL digest ingestion: a follower now accepts the ping-piggybacked
    digest only from the joined leader's IP, only as ONE balanced JSON
    object <=8 KB (clusterDigestShapeOk, 5 native tests), and persists the
    table only when it parses as a valid member table — forged pings can no
    longer poison /cluster/digest, churn NVS, or steer a future promote.
    - HIGH suppress-leave leak: clusterLeaderStageConfig resets the demote's
    configSuppressLeave, so a user-staged config never applies with the
    leave fan-ou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
    [WebEndpoints.cpp]
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2026-07-14 feat(v2): cluster platform guard (#297) — plat key in join/ping replies, rollout skips foreign-platform members
    - ClusterMemberRuntime gains plat (join reply parse, ping refresh; absent =
    same platform as the leader — S3 fleet unchanged)
    - clusterRolloutNextCandidate excludes foreign-plat members: the leader
    never streams its S3 image into an ESP-01's /firmware/master
    - plat surfaced in /cluster/status members[] (additive) + discovery TXT
    parse/scan chip; member panel shows heap/rssi/up vitals when present
    - fake_follower grows a plat= variant (esp01 vitals) for bench drills
    [WebEndpoints.cpp]
2026-07-14 feat(v2): ESP-01 cluster follower dumb row — firmware/v2/FollowerEsp01 (#298)
    New minimal ESP8266 firmware turning v1 master boards (ESP-01 + Nano row)
    into cheap cluster wall rows under one S3 leader:
    - existing /cluster/{join,render,ping,leave,health} follower wire; join/ping
    replies add plat=esp01 + heap/rssi/up vitals; digest/promote absent by
    design (never a takeover candidate)
    - phases Standalone→Clustered→Grace→Blank (FollowerPolicy.h, natively
    tested); EEPROM clusteredBy marker boots into Grace; SNTP epoch-only
    commitAt flip sync
    - POST /firmware/master?md5= (v1 Update flow) + bundled unit hex +
    /reflash-units twiboot job (v1 machinery, batch 2) + {"seq":N}
    maint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
    [DisplayWidth.h, FollowerBus.cpp, FollowerBus.h, FollowerCluster.cpp, FollowerCluster.h, FollowerConfig.h, FollowerJson.h, FollowerOps.h]
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2026-07-14 fix(v2): #298 review gate — OTA stall frees the session slot, static health buffer, split MD5 diagnostics
    - webOtaUploadFrozen() owns the 30 s stall auto-thaw WITH the owner-slot
    release (v1 #191 guard the trim dropped — a half-open upload socket
    would otherwise 409 every later /firmware/master until power cycle);
    cross-review CONFIRMED (codex + cpp-reviewer, same finding)
    - /units/health renders into a static buffer (v1 ESP-01 RAM tactic) —
    per-request new/delete of 3.5 KB fragments this board's small heap
    - Update.setMD5 rejection reports its own diagnostic again (v1 parity)
    [FollowerWeb.cpp, FollowerWeb.h, main.cpp]
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2026-07-14 fix(v2): #301 bump netTask stack 4096->8192 — flashLogTick canary overflow
    Board split-flap-c8a746 crash-looped on rev 61a8ac1: netTask overflowed
    its 4096-word stack inside flashLogTick's LittleFS.open -> fopen ->
    esp_flash_read, whose cross-core cache-disable IPC is the deepest chain
    netTask runs. netTask now carries wifi+web+flashLog+cluster-follower+
    SSE(#251)+system-stats(#245) in one loop; the #294-era additions raised
    the per-iteration floor until the fopen spike no longer fit (net was the
    thinnest HWM at boot). Not the #297 plat change — surfaced bench-testing
    PR #300. +16 KB internal SRAM, trivial. Validate via the heartbeat net
    HWM column on hardware.
    [Tasks.cpp]
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2026-07-15 feat(v2): #304 Part B — S3 stores + relays ESP-01 follower firmware on-demand
    The S3 leader can now update a foreign-platform (esp01) cluster row's
    firmware from its own UI, without curl/ota-flash.sh to the follower and
    without poking a hole in #294's "/firmware/* stays closed" boundary.
    Chosen over the issue's browser-direct upload (capacity overturns the
    parked "380 KB relay burden": storage has ~3.8 MB free): the operator
    uploads a follower-*.bin to the S3 ONCE (same-origin), it's held on the
    shared `storage` LittleFS, and clusterTask streams it to a chosen esp01
    row server-to-server — reusing #276's chunked multipart machinery but
    sourcing the file instead of the running slot. On-de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
    [FollowerImagePolicy.h, FollowerImageStore.cpp, FollowerImageStore.h, WebEndpoints.cpp, main.cpp]
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2026-07-15 fix(v2): #305 confirm OTA image pre-inrush — stop brownout rollback of good images
    The S3 browns out momentarily during the post-OTA verify-boot inrush
    (display unit-move + WiFi PA), which happens BEFORE first-netif-up — the
    old confirm bar. So the bootloader A/B-reverted perfectly good images:
    bench-proven with an empty-commit rebuild of the running-healthy image,
    which rolled back identically (reset=Brownout), while being byte-identical
    to the on-board original bar the rev string. Not code, not build drift —
    confirm timing.
    Move otaHealthConfirm() to the end of setup(), immediately before
    tasksInit() — after every single-threaded init has proven the image
    doesn't hard-crash, but b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
    [OtaService.cpp, OtaService.h, WebEndpoints.cpp, WifiService.cpp, main.cpp]
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2026-07-15 feat(v2): headless observability API + unit Vcc diagnostics (#306 #307 #308)
    Unit (#306): new checksummed CMD_GET_VITALS I2C read — supply Vcc now/min
    (AVR bandgap, sampled mid-move), last commanded flap index, min free SRAM.
    Pure UnitVitals.h + native test_vitals; backward-compatible (pre-vitals fw
    fails the checksum -> diagV2=false, no garbage).
    Master (#307): GET /api (routes + terse-key legend, with a native
    legend-completeness guard so the legend can't drift from the data), GET
    /system/info (chip/partition inventory), GET /status (one-shot aggregate),
    per-unit vcc/vmin/cp/ram + headline vccMin in /units/health. UnitBus reads
    CMD_GET_VITALS on probe + health-poll. buildSystemNowJson /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
    [ApiIndex.h, FollowerBus.cpp, FollowerBus.h, FollowerCluster.cpp, FollowerCluster.h, FollowerJson.h, FollowerWeb.cpp, SplitFlapProtocol.h]
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2026-07-15 chore: migrate active Nano firmware v1→v2, freeze firmware/v1 (#311)
    Deprecate the whole firmware/v1 tree. git mv the still-active pieces to
    firmware/v2 (history preserved) so all live development is under v2:
    - firmware/v1/Unit -> firmware/v2/Unit
    - firmware/v1/UnitBootloader -> firmware/v2/UnitBootloader
    - firmware/v1/shared -> firmware/v2/shared (SplitFlapProtocol.h)
    firmware/v1 now holds only the already-frozen ESP8266 ESPMaster (out of
    CI, reference-only); its -I ../shared include dangles but it is never
    rebuilt.
    Lockstep reference updates:
    - build.yml: CI matrix + native-test dir v1/Unit -> v2/Unit
    - make_manifest.py (+tests): UNIT_BUILD / drift-gate path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
    [SplitFlapProtocol.h, TwibootProtocol.h, Unit.ino, UnitDrift.h, UnitI2CProtocol.ino, UnitMotion.ino, UnitOdometer.h, UnitVitals.h]
2026-07-15 feat(unit+v2): staggered boot-home + I2C heartbeat health (#309 #310)
    Arc-2 of the observability wave, across all three v2 trees. Spec:
    docs/superpowers/specs/2026-07-15-unit-boot-home-stagger-and-i2c-heartbeat-health-design.md
    #309 boot-home stagger (root-cause fix for the #305 power-up brownout):
    - Unit boots UNHOMED (no calibrate() in setup); homes on the FIRST of:
    SFP_CMD_HOME, a letter command while unhomed (rotateToLetter forces the
    calibrate branch), or a staggered self-home fallback (BootHomePolicy.h:
    30 s + addr*stagger + jitter when standalone, 120 s hard cap when a master
    is present but silent). 'homed' rides status flags bit5 -> master hs2.
    - Master + Follower orchestrat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
    [ApiIndex.h, BootHomePlan.h, BootHomePolicy.h, FollowerBus.cpp, FollowerBus.h, FollowerWeb.cpp, HeartbeatPolicy.h, MqttService.cpp]
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2026-07-16 feat(cluster): network hardening + cluster-wire HMAC auth (#313)
    Pre-v2.0.0 security gate for the multi-display cluster (epic #270).
    Core hardening (both S3 and ESP-01 trees):
    - CSRF: the CORS layer now ENFORCES, not just reflects — a mutating POST
    with a non-LAN Origin is 403'd; the three flash-writing upload routes
    gate CSRF inline at index==0 (server middleware fires post-body).
    - Leader-wire /cluster/{render,join,ping} source-IP-bound to the leader;
    /cluster/leave = leader-IP-OR-LAN-browser combined guard.
    - SSRF: member host restricted to LAN targets + disable_auto_redirect.
    - S3 /firmware/master gains the ESP-01's 30 s OTA stall watchdog.
    - /cluster/join persists membership on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
    [FollowerCluster.cpp, FollowerCluster.h, FollowerSettings.h, FollowerWeb.cpp, WebEndpoints.cpp]
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2026-07-17 feat(diag): /coredump summary+raw endpoints on the closed surface (#319)
    Remote crash diagnostics: GET /coredump/summary (crashed task, PC, backtrace
    via esp_core_dump_get_summary) and GET /coredump/raw (raw ELF for offline
    espcoredump.py). Deliberately kept off clusterCorsPathAllowed — a coredump
    holds live RAM (HMAC keys, WiFi creds), so the surface stays same-origin
    closed like /firmware/*. Read-only; coredump partition is written solely by
    the panic handler, so async-task reads are safe.
    [ApiIndex.h, WebEndpoints.cpp]
2026-07-17 fix(diag): gate /coredump/raw behind COREDUMP_RAW_ENABLE (security review)
    Background security review flagged /coredump/raw as unauthenticated sensitive
    disclosure. Correct: with CONFIG_ESP_COREDUMP_CAPTURE_DRAM off the dump is
    task-stacks-only (not the .bss key/cred store), but a stack CAN transiently
    hold key material (a key mid-HMAC-sign), and CORS-closing does not stop a
    plain HTTP client on a no-auth device. So raw is now compiled out of shipped
    images and only present in an opt-in -DCOREDUMP_RAW_ENABLE debug build. The
    summary (addresses only, no secrets) stays always-on.
    [ApiIndex.h, WebEndpoints.cpp]
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2026-07-17 feat(cluster): wire ranked auto-takeover + graceful-reboot hold (#321)
    Follower (ClusterFollower.cpp): parse the leader's succ list from the digest →
    this board's rank; a designated successor auto-promotes from the supervision
    tick once leader silence passes its staggered threshold (clusterFollowerPromote
    refactored into a shared core with a manual/auto gate, TOCTOU-safe at the
    commit point). Parse the digest's hold field → push the takeover deadline out.
    Leader: hold rides the (already HMAC-signed) digest — no new endpoint/canonical.
    clusterLeaderAnnounceRebootHold() stamps the hold and clusterTask force-pings
    every member once (self-contained, off the one-op-per-tick hot path, yield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
    [WebEndpoints.cpp]
2026-07-17 fix(cluster): address cpp-review of the auto-takeover branch (#319 #320 #321)
    HIGH: rebootHoldFanout burst-pinged every member in one clusterLeaderTick —
    the exact core-0-starving shape #320 fixed (up to 7 dead hosts x 1.5s HTTP >
    the 5s TWDT). Reworked to send ONE member per tick (watchdog-safe, same cadence
    as the normal fan-out), reachable/non-degraded members queued first so a tail
    of dead members can't starve the reboot drain's bounded wait.
    MEDIUM: a failed auto-promote re-fired every ~10ms service tick (inputs don't
    change on failure) — added a 5s backoff gate (CLUSTER_AUTO_TAKEOVER_RETRY_MS).
    LOW: calloc the coredump summary struct (no stale heap bytes on a partial dump);
    reset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
    [WebEndpoints.cpp]
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2026-07-17 fix(cluster): bump cluster task stack 6144->8192 (bench: 620B HWM at leading, #321)
    Bench serial showed the cluster task HWM fall to ~620 B free during the
    config-apply->leading->join-fan-out peak. The digest build stacks a full
    ClusterLeaderStatus (8 members x 4 Strings) + String mirror[8]; 6144 is too
    thin, and the reboot-hold fan-out builds the same objects. Bump to 8192 for
    margin — RAM is plentiful (150 KB+ free heap). Not a leak (heap stable).
    [Tasks.cpp]
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2026-07-18 fix(#314): feed TWDT inside UnitBus stuck-flap + reflash-settle poll loops (review)
    Final whole-branch review of #314 found two blocking poll loops in
    UnitBus.cpp that run in the subscribed displayTask but never feed the
    watchdog: waitForDisplayToStop() (up to SHOW_STUCK_TIMEOUT_MS=30s on a
    jammed flap) and unitBusWaitBatchIdle() (up to
    REFLASH_BATCH_SETTLE_MS=15s during reflash). Both could cross the 30s
    TWDT timeout and false-reboot mid-operation. Also feed once more in
    Tasks.cpp's runReflashJob between the trailing batch settle and the
    final reprobe, closing the last unfed gap before boot-home.
    [Tasks.cpp, UnitBus.cpp]
2026-07-19 fix(#328): reconnect watchdog reboots the S3 master after a sustained WiFi outage
    The WiFi policy parked permanently at Connected and delegated all recovery to
    WiFi.setAutoReconnect(true). That esp_wifi path wedges on the ESP32-S3 after an
    AP power-cycle (worse with WiFi.persistent(false)), stranding the board
    off-network until a manual power cycle — reproduced live on two S3 masters
    while the ESP-01 follower (different WiFi stack) rode the same outage out.
    Add a bounded reconnect watchdog: while Connected with the link continuously
    down for >= WIFI_RECONNECT_TIMEOUT_MS (90 s), return WifiAction::Reboot so the
    board re-runs the join from scratch — the same 'router may just have been dow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
    [WifiPolicy.h, WifiService.cpp]
2026-07-19 feat(#328): event-driven STA re-kick for fast WiFi recovery (on top of the watchdog)
    Supplement the reconnect watchdog with a WIFI_EVENT_STA_DISCONNECTED handler
    that re-issues WiFi.reconnect() while Connected, throttled to once per 5 s. This
    un-wedges the S3's esp_wifi auto-reconnect in seconds after an AP power-cycle,
    so the 90 s watchdog reboot becomes a rare last resort rather than the primary
    recovery. esp_wifi cannot be replaced (proprietary S3 WiFi blob); driving it
    harder from the disconnect event is the robust in-stack option.
    The handler runs in the Arduino event task, so netTask publishes its gate
    (Connected && !restartPending) through a std::atomic<bool> each tick rather than
    le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
    [WifiService.cpp]
2026-07-19 feat(#329): headless-mode slice 1 — no-units detection debounce + deviceRole knob
    Foundation for giving a physically unit-less S3 master a genuine role
    instead of enrolling it as an empty phantom display row. This slice is
    detection + settings plumbing + /settings surface only — no role
    BEHAVIOUR yet (spare/monitor/backup ride #331/#332/#333).
    - HeadlessPolicy.h (new, pure, natively tested): the deviceRole wire
    vocabulary (display|headless-{backup,monitor,spare}) + validator, a
    consecutive-zero-probe debounce (HeadlessDetector, threshold 3) so a
    real display's transient bus glitch never flips it, and the
    headlessShouldSuggest nudge gate (suggest only while still on the
    default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
    [DisplayIpc.h, PendingSettingsPost.h, Settings.h, SettingsJson.h, Tasks.cpp, WebEndpoints.cpp]
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2026-07-19 feat(#333): headless mode slice 3c — width-0 off-grid warm-standby backup member
    A cluster member with width 0 is now OFF-GRID: it keeps full membership
    (pings, digest, promote rank, HMAC) but claims no columns and never tiles
    a row, so a unit-less S3 can join a wall as a non-rendering, promote-
    eligible standby instead of a phantom row. Fixes the member-editor
    rejecting width 0.
    - ClusterLayout.h validateMemberTable: width-0 members excluded from
    maxRow / per-row contiguity / left-to-right tiling (row-bound check kept
    for segment-array safety). Segment slicing was already width-0-safe
    (substring(col,col+0), zero-iteration loops). Floor added: an all-off-
    grid table (nothing rende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
    [ClusterLayout.h]
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2026-07-19 feat(#335): expose heap/rssi/up/plat in S3 /settings for cluster-member vitals
    The System-tab 'Cluster members' panel fans out to each member's /settings
    for heap/rssi/uptime, but only the ESP-01 follower carried them (#297) —
    S3 rows showed dashes. Add the same keys/units (heap bytes, rssi dBm, up
    seconds) plus plat:"esp32s3" to the S3 /settings JSON so every S3 member
    surfaces vitals identically. Runtime reads (ESP.getFreeHeap/WiFi.RSSI/
    millis), no settings lock. No JS change needed — the panel already renders
    these when present; corrected its now-stale 'S3 has none' comment. plat
    also gives the member ⚙ panel + #334 table an explicit model label.
    748/748 native (+2). Closes #335.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
    [SettingsJson.h, WebEndpoints.cpp]
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2026-07-20 fix(#314): displayTask subscribes to the TWDT before the boot reflash/boot-home pass
    cpp-review of the master merge surfaced that wdtSubscribeSelf() ran only
    after the boot-time runReflashJob/runBootHomeSequence block, making every
    wdtFeed() inside that highest-risk window (cold first bus scan, twiboot
    recovery flash, staggered boot-home) a silent no-op — a wedged I2C
    transaction at boot would never trip the dog. Subscribe now happens right
    after unitBusInit(). Also refresh a stale pre-#320 fan-out comment in
    ClusterLeader.cpp.
    [Tasks.cpp]
2026-07-20 refactor(#338): split WebEndpoints.cpp into focused web TUs
    No behavior change — a pure mechanical move of the 2364-line monolith into
    a TU family behind the unchanged WebEndpoints.h seam:
    - WebEndpoints.cpp (456): shared state, buildCurrentSettingsJson, init
    (middleware + per-module registrars), the load-bearing-order loop drain,
    content snapshot + MQTT setters
    - WebEndpointsInternal.h (77): internal seam — extern shared state,
    WebStateLock, registrar/loop hooks; include from Web*.cpp only
    - WebContent.cpp (149): PROGMEM assets + SSE; sole WebAssets.h includer
    (/wifi-setup moved here — it serves a WebAssets blob)
    - WebSettings.cpp (275): /settings, / POST, /reboot, wifi flow,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
    [WebContent.cpp, WebEndpoints.cpp, WebEndpoints.h, WebEndpointsInternal.h, WebFirmware.cpp, WebSettings.cpp, WebSystem.cpp]
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2026-07-20 fix(#332): review fixes — leader self-row role, tier-precedence pin, wording
    cpp-review MEDs: (1) the /cluster/status self row never carried a role (the
    self row is not an HTTP peer, so the runtime table can't learn it) —
    clusterLeaderSetSelfRole() now seeds it at webEndpointsInit and the settings
    drain pushes changes, injected in statusFillLocked like GIT_REV; (2) pin the
    intentional table-width-beats-role precedence (clusterSuccessorTier) with a
    direct native test across all role/width combos. LOW: absent-role wording no
    longer implies equivalence with an explicit 'display'.
    [ApiIndex.h, WebEndpoints.cpp]
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2026-07-20 feat(#343): boot-rescue for ESP-01 rows — beacon + leader auto re-push
    Follower: RTC-memory bad-boot counter (FollowerRescue.h pure, offset 32,
    checksummed; native-tested) — every boot increments, 60 s stable uptime or
    the deliberate-reboot path (which OTA completion takes) zeroes it, a power
    cycle wipes it by nature. At 3 consecutive early deaths the next boot is a
    rescue beacon: WiFi + cluster wire + OTA only, no I2C/probe/boot-home/
    render, unit ops 409, join/ping/settings replies carry additive rescue:1.
    Leader: rescue parses into ClusterMemberRuntime; a beaconing esp01 is a
    follower-image candidate even at the stored rev (blocked cap still rules),
    and a rejoin still beaconing burns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
    [FollowerCluster.cpp, FollowerJson.h, FollowerRescue.cpp, FollowerRescue.h, FollowerWeb.cpp, main.cpp]
2026-07-20 feat(#342): local clock fallback on ESP-01 rows when the leader is lost
    Leader: clusterLeaderSetTz (seeded at init, pushed by the settings drain)
    rides every join body as additive tz=. Follower: tz persists with the
    membership (EEPROM blob v4, magic 3FFS->4FFS — old blobs decode false and
    boot standalone), applied via setenv/tzset; a Blank-phase row with a held
    membership, known zone and synced SNTP renders centered HH:MM (pure
    FollowerClock.h, repaint on minute change) instead of going dark. Leader
    content replaces the clock; a returning leader with an empty segment
    blanks it (a frozen clock must not pose as content); leave drops the
    zone; unsynced/no-tz keeps today's blank. fake_leader j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
    [FollowerClock.h, FollowerCluster.cpp, FollowerCluster.h, FollowerSettings.h, FollowerWeb.cpp, WebEndpoints.cpp]
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2026-07-20 test(#343): flag-gated RESCUE_CRASH_TEST bench-drill hook
    -DRESCUE_CRASH_TEST makes a normal boot abort() inside a beacon-skipped
    path — the vehicle for the crash-loop drill; compiled out otherwise.
    [main.cpp]
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2026-07-21 fix(#347): pre-auth body-size guard against heap-exhaustion DoS
    ESPAsyncWebServer buffers a urlencoded/plain/multipart non-file body into
    a heap String BEFORE any handler or the CORS/CSRF middleware runs, so any
    LAN client could exhaust the S3's SRAM pre-auth with one large POST. Add a
    first-registered AsyncWebHandler whose canHandle() rejects a body over a
    per-route ceiling (2 KB for forms/cluster-wire; genuine multipart uploads
    to /firmware/* + /cluster/follower-firmware exempt). isRequestHandlerTrivial
    makes the parser DISCARD the oversized body instead of buffering it, then
    413s — no heap String ever grows. A non-multipart body to an upload URL is
    still capped, closing the obvious bypa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
    [FollowerWeb.cpp, RescueWeb.cpp, WebBodyLimit.h, WebBodyLimitGuard.h, WebEndpoints.cpp]
2026-07-21 fix(#347): bound multipart non-file buffering in the parser (review CRITICAL)
    The canHandle guard alone left a hole: it must exempt genuine multipart on
    the upload routes (/firmware/master, /firmware/rescue,
    /cluster/follower-firmware) to let real firmware through, but the parser
    buffers a multipart NON-file part — header line (_temp) AND value
    (_itemValue) — into unbounded heap Strings and pushes each field into
    _params, all before the routes' onUpload CSRF/md5/Update.begin gate. So an
    unauthenticated LAN client could still heap-crash those routes (worst on the
    ESP-01). A Content-Length cap can't fix them (legit firmware dwarfs the
    heap), so the bound lives in the parser.
    patch_asyncwe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
    [WebBodyLimit.h, WebBodyLimitGuard.h, patch_asyncweb.py]
2026-07-21 fix(#347): symmetric param-count guard on file-part emplace + CORS comment
    Re-review CONFIRMED the CRITICAL closed; two LOW follow-ups. This applies
    the symmetry one: the file-part completion emplace now carries the same
    _params.size() < SF347_MULTIPART_MAX_PARAMS cap as the non-file branch, so
    the field-count bound is explicit on both paths rather than relying on the
    header budget indirectly. Also tightened the CORS-less-413 comment (follower
    does serve some browser routes, but none send a >2KB body).
    Clean rebuild applies all 6 patch sites on all three trees; native green.
    [WebBodyLimitGuard.h, patch_asyncweb.py]
2026-07-21 fix(#347): reject no-file-part POSTs to upload routes (unauth reboot DoS)
    Bench of the heap fix surfaced a pre-existing bug on the same attack
    surface: a POST to an upload route with no multipart file part never enters
    onUpload, so Update.begin() and the in-onUpload CSRF/md5 gates never run —
    then onRequest sees Update.isFinished() report success on a never-begun
    Update and reboots (or, for rescue-install, falsely reports 'installed').
    Unauthenticated, since the CSRF check lives inside onUpload.
    Guard each route's onRequest to take the success/reboot path only if an
    upload session was actually established for THIS request:
    - Master /firmware/master (otaOwnerRequest) — was: false flash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
    [FollowerWeb.cpp, RescueWeb.cpp, WebFirmware.cpp]
2026-07-21 fix(#348): feed the TWDT per page in the unit-reflash flash loop
    A degraded bus hitting the rewrite path across ~87 pages approaches the
    30 s TWDT with zero feeds (runReflashJob feeds once per unit) — a trip
    panics the whole S3 mid-reflash. Per-page feed bounds the inter-feed span
    to one page's worst case.
    [UnitBus.cpp]
2026-07-21 fix(#349,#359): Rescue hardening — CSRF gate, upload owner guard, idle-AP STA retry
    - RescueCors.h (trimmed copy of FollowerCors.h origin logic): mutating
    POSTs with a non-LAN Origin are 403'd — /firmware/master inline at
    index==0 before Update.begin, /rescue/exit at handler top. Natively
    tested (test_rescue_cors, vectors mirror the follower copy's).
    - Single-owner upload session (#359 included): a second concurrent
    /firmware/master upload is 409'd instead of abort+stealing the live
    recovery flash; every chunk gates on ownership so orphaned requests
    can't interleave bytes into the live Update session; onDisconnect
    backstop frees the slot.
    - RescueWifiPolicy: an idle AP with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
    [RescueWeb.cpp, RescueWifiPolicy.h, main.cpp]
2026-07-21 fix(#354): low-severity correctness batch
    - Unit odometer EEPROM ring gains a per-slot masked XOR checksum ring
    (bytes 72..87, magic 0xC3->0xC4 with in-place migration preserving the
    deployed count): a power-loss-torn slot write is now skipped at boot
    instead of adopted as a garbage wear count. Pure logic + native tests
    in UnitOdometer.h/test_odometer.
    - Follower /firmware/master validates the mandatory ?md5= BEFORE
    Update.begin: a malformed LAN POST no longer costs a full flash-erase
    cycle (functional DoS + wear amplifier).
    - Follower OTA size bound: guard freeSpace < 0x1000 before the
    (freeSpace - 0x1000) subtraction underflows maxSketchSpace.
    - millis()==0 sentinel guards on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
    [FollowerWeb.cpp, Unit.ino, UnitMotion.ino, UnitOdometer.h]
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2026-07-21 feat(#358): ESP-01 API self-consistency + foreign-contention observability
    API honesty:
    - ApiIndex.h gains GET /log (the one index/route drift) and a notServed
    array (/cluster/{digest,promote,config,discover}) so tooling can tell
    'this platform doesn't do that' from 'no such route'.
    - tests/test_api_index.py: pure-text drift gate diffing server.on()
    literals in FollowerWeb.cpp against API_ROUTES, plus notServed-vs-
    registered disjointness and the spec list pin.
    - CLAUDE.md FollowerEsp01 line now matches the spec's not-served list.
    Foreign contention (silent refusals made visible):
    - New ClusterForeign.h (byte-identical copy Master<->FollowerEsp01, gate-
    pinned): joins/pings/render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
    [ApiIndex.h, FollowerJson.h, FollowerWeb.cpp]
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2026-07-21 fix(#349): consume the Rescue OTA rejection verdict per request; EOF whitespace
    Review LOW: otaRejectionStatus/Reason stayed set after a pre-owner
    rejection (CSRF/md5), so a later bodyless POST echoed the stale verdict
    instead of its own 400. The completion handler now consumes the fields.
    Both reviewers (cpp-reviewer + codex cross-review) otherwise APPROVED the
    branch with zero CRITICAL/HIGH/MEDIUM findings.
    [RescueWeb.cpp]
2026-07-21 fix(#342,#362): install the leader tz via configTime from loop — no more UTC fallback clock
    Review nits folded in: tzInstalled is volatile (cross-context flag, matching
    membershipDirty/renderPending); clusterHandleLeave re-arms the latch too
    (defensive — eligibility already gates on leaderTz).
    Bench-proven root cause (ESP-01, not visible to a host test): the local
    clock fallback rendered UTC because
    1. setenv("TZ")+tzset() is INERT for localtime_r on the ESP8266 core —
    the zone must go through configTime(tz), which drives newlib's
    __gettzinfo;
    2. the zone was applied at clusterInit, BEFORE wifiServicesInit's
    configTime(0,0) reset it to UTC, and the rejoin skipped re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
    [FollowerClock.h, FollowerCluster.cpp]
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2026-07-22 fix(#324): stagger flap inrush across a bulk render
    A full 16-unit row commanded its new flap targets back-to-back spun every
    stepper up within milliseconds; the simultaneous inrush browned out the S3
    mid-takeover (#321 pull-plug drill). Runtime twin of the #305/#309 boot
    inrush — spread it the same way.
    RenderStagger.h (pure, natively tested, copied to FollowerEsp01) pauses the
    render write loop for a rail-settle before opening each new group of units.
    Starting points batch 4 / 100 ms (bench-tunable against #306 vmin) add
    ~300 ms to a 16-unit takeover, imperceptible against the flap movement;
    unchanged units draw no inrush so common small renders barely stagger.
    Wired into unitBusShowFr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
    [FollowerBus.cpp, RenderStagger.h, UnitBus.cpp]
2026-07-22 fix(#322): log unit health transitions (drift self-correction was silent)
    A unit that drifted and self-corrected left NO operator log line: the Nano's
    drift auto re-home (#263) prints only to its own unmonitored serial, and the
    master folded the de/ds/dp diag counters — plus home-failed, hall-never,
    heartbeat-stale (#310) and the #264 mismatch verdict — into passive
    /units/health JSON, never onto the flash/web log an operator watches. (The
    observed "several minutes" delay is the unit's deliberate ≤1/min re-home rate
    limit, not a bug.)
    Now logged on TRANSITION, where an operator looks:
    - drift: new-events delta off the unit's saturating de counter — pure
    DriftLogPolicy.h, emitted i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
    [DisplayTask.cpp, DriftLogPolicy.h, UnitBus.cpp, UnitEventLog.h, UnitHealth.h]
2026-07-22 feat(#366,#367,#375): unit diagnostics v2 — low-Vcc alert, per-unit I2C attribution, 400 kHz bus
    Master-only slice of epic #365 (no unit reflash — the Nano TWI slaves follow
    the master clock). Builds on the #322 event log.
    #375: raise the unit I2C bus 100 kHz -> 400 kHz (UnitBus.cpp). Shrinks the
    render burst + health-poll cadence on the wire; does not touch the #326
    clock-stretch stall (slave-ISR bound). Bench-validated against #367's per-unit
    error rate; revert path documented in the constant's comment.
    #366: low-supply-Vcc operator alert. A unit whose since-boot vccMin (#306) dips
    below a fixed UNIT_VCC_MIN_FLOOR_MV (4000 mV, TODO NVS) logs one flash/web line
    as a brownout precursor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
    [DisplayTask.cpp, FollowerWeb.cpp, MqttHelpers.h, MqttService.cpp, UnitBus.cpp, UnitEventLog.h, UnitHealth.h]
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2026-07-23 fix(#368): relocate UnitRebootWatch to shared UnitHealth.h for copied-header parity
    A3 added UnitRebootWatch and an #include "UnitEventLog.h" to Master's
    UnitHealth.h only, drifting it from the byte-identical FollowerEsp01 copy
    the copied-header CI gate requires. Moves the POD struct into UnitHealth.h
    (the shared data header) so UnitEventLog.h depends on it instead of the
    reverse; the follower copy carries the unused struct but no master-only
    header dependency.
    [UnitEventLog.h, UnitHealth.h]
2026-07-23 feat(#368): HA fleet-reboot-total telemetry sensor
    Sum of every unit's lifetime brownout+watchdog reset counts (valid
    CMD_GET_STATUS reads only), published on the existing telemetry topic
    as "reboots" and surfaced as a new diagnostic sensor entity, mirroring
    the #366 vccMin fleet sensor.
    [MqttHelpers.h, MqttService.cpp]
2026-07-23 feat(#365): GET_EXT_DIAG opcode 0x89 + UnitExtDiag.h wire format (3 trees)
    Foundational task of Slice B (unit-fw diagnostics epic #365): defines
    the GET_EXT_DIAG query packet (step-excess last/max, per-move Vcc sag,
    hall edges/rev, duty window, status bits) mirroring the GET_VITALS
    pattern. Header is byte-identical across Unit/Master/FollowerEsp01 and
    gated by tests/test_copied_headers.py. Nothing on the wire uses it yet
    (unit-side glue is B2, master-side read is B3).
    [SplitFlapProtocol.h, UnitExtDiag.h]
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2026-07-23 feat(#365): FollowerEsp01 reads GET_EXT_DIAG into /units/health
    FollowerBus.cpp now mirrors the master's readUnitExtDiag/refreshUnitExtDiag
    pair on its own I2C bus (probe + heartbeat-poll cadence, not charged to bus
    error attribution) so UnitFacts.extDiag/extDiagValid populate on the ESP-01
    row too - UnitHealth.h already emits the se/sx/sag/he/dw/sb keys once
    extDiagValid is true. Raised FOLLOWER_HEALTH_BUF 5120 -> 6144: with ext-diag
    now live (unlike the still-inert #367 err/errAge keys), the worst-case
    16-unit payload plus the wear/reflash splices measures ~5662 B.
    [FollowerBus.cpp, FollowerWeb.cpp]
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2026-07-23 fix(#383): revert I2C bus to 100 kHz — twiboot reflash unproven at 400 kHz + wall bus lockup
    [UnitBus.cpp]
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2026-07-24 feat(#385): cluster robustness — contact-age degrade + suspect tier
    Replace the 3-consecutive-failure degrade with wall-clock truth: a member
    degrades only when a counted failure lands >= 30 s
    (CLUSTER_DEGRADED_SILENCE_MS) after its last successful round-trip, so
    transient single-core follower I2C stalls of any class are forgiven by
    construction. Retires the #326 render-busy grace special-case.
    - Suspect tier (failures > 0, derived): quiet — membership + HMAC kept,
    no re-join, no HA alarm; amber pill, additive status key, transition log.
    - Leader-offline gate: failures while our own STA is down don't count;
    netif up-edge re-stamps every member's contact epoch (benefit of the
    doubt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
    [ApiIndex.h]
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2026-07-25 fix(#386): ping digest blew the body ceiling — route-aware cap + leader budget
    /cluster/ping is the one cluster-wire body that scales with the wall: it
    carries the #294 digest piggyback, and URL-encoding a JSON digest inflates
    it ~65% ({, ", :, , all become %XX). Measured on the bench with a third
    member in the table: 1236 B raw -> 2038 B encoded -> 2137 B with
    you/ts/mac, against a flat kMaxNonUploadBodyBytes of 2048.
    Every ping was therefore 413'd by the #347 body guard at canHandle(),
    BEFORE the handler ran — so no member ever logged a rejection and the
    foreign counters stayed at zero, while the leader's single unlogged
    failure path just counted it as "contact failed". lastContactMs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
    [WebBodyLimit.h]
2026-07-25 fix(#386): review findings — two-edge digest log + bench-measured heap rationale
    cpp-review LOW: the digest-omitted notice was a lifetime one-shot latch, so a
    wall that grew past the budget, shrank back under it and grew again would
    report only the first crossing. Now logs BOTH edges (#322 transition-only
    philosophy); clusterTask is the sole caller of collectMemberWork(), so the
    function-local static stays safe.
    cpp-review MEDIUM: the "~18 KB free heap" justification for kMaxPingBodyBytes
    was unattributed and contradicted an in-tree "~40 KB heap" comment. Measured on
    the ESP-01 instead: 18680 B free at rest; 50 consecutive 3913 B POSTs to
    /cluster/ping dipped it to 17576 B and it settled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
    [WebBodyLimit.h]
2026-07-26 feat(#391): surface the factory rescue-slot identity — it was invisible and never refreshed
    The rescue image is the last line of defence, but nothing about it was
    observable from the running app: the boot banner said only "image present"
    and no API carried its identity. The #389 bench run found .20 holding a
    rescue build from 2026-07-13 — predating the rescue CSRF gate (#349), the
    ESPAsyncWebServer alignment (#357) and the per-chunk overlap guard (#359).
    Nobody could have known without rebooting the board into it.
    This blocks #302/#281: auto-arming rescue on a boot-loop would hand recovery
    to an image of unknown vintage, on a board already in trouble.
    The slot's own app descriptor cann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
    [FactorySlot.cpp, FactorySlot.h, RescueSlotStatus.h, SettingsJson.h, WebEndpoints.cpp, WebFirmware.cpp, main.cpp]
2026-07-26 fix(#391): review findings — false STALE on a no-?v= install, plus NVS off the async task
    cpp-reviewer over the branch diff. Two HIGH, both real.
    HIGH: an install without ?v= reported STALE with rev "?" instead of
    UNIDENTIFIED — the exact false alarm this issue exists to prevent, on the
    one image you cannot afford to be wrong about. formatSlotRecord substitutes
    a literal '?' when a rev filters to empty (parse requires a non-empty
    field), and that round-trips back as a non-empty rev, so the rev[0]=='\0'
    guard never fired and "?" != GIT_REV read as stale. The unit test passed
    because it built the SlotRecord by hand; the bench run missed it because
    that slot had no record at all. Fixed at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
    [FactorySlot.cpp, FactorySlot.h, RescueSlotStatus.h, WebEndpoints.cpp, WebEndpointsInternal.h, WebFirmware.cpp, main.cpp]
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2026-07-26 feat(#406): day-0 EEPROM re-layout — persist every revolution, remember the decline
    Two problems in one place, both the unit's EEPROM.
    The odometer barely persisted. The interval was 128 revolutions, and 19 of
    21 units had never crossed that boundary in their lives — so the count was
    not merely undercounted, it reset to 0 at every power loss and started
    again. Interval is now 1, which makes the boundary unreachable.
    And the unit was amnesiac about its own decline. Unit 0x0f degraded pass ->
    marginal -> hall-dead in about two hours and nothing on the unit recorded
    the trajectory; its healthy hallWindow of 46 survived only in a session
    note. It now carries its own homeFailed count, a lif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
    [Unit.ino, UnitEeprom.h, UnitI2CProtocol.ino, UnitMotion.ino, UnitOdometer.h]
2026-07-26 feat(#406): GET_LIFETIME (0x8A) — surface what the unit remembers
    #406 as filed stored five lifetime health fields and specified no way to
    read them. That would have shipped them write-only: a 21-unit twiboot
    campaign to start recording data, and a second one to be able to see it.
    Avoiding exactly that is why epic #407 exists, so the read path rides the
    same reflash.
    A new opcode rather than widening GET_EXT_DIAG (0x89), for two reasons.
    0x89 is documented as unversioned — a format change there takes a new
    opcode anyway. And the two carry different things: ext-diag is since-boot
    and every reboot forgets it, this is what survives the power cycle. Keeping
    them separate keeps that distinct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
    [ApiIndex.h, FollowerBus.cpp, SplitFlapProtocol.h, Unit.ino, UnitBus.cpp, UnitHealth.h, UnitI2CProtocol.ino, UnitLifetime.h]
2026-07-26 feat(#405): checksum the core reads, complement the writes, gate on one version
    Five paths that predate the #231 checksum discipline. The bus is not
    failing — .91 reports i2cErr 0 across 10,604 transactions — but none of
    these would have DETECTED a silent corruption, which makes "0 errors"
    weaker evidence than it looks.
    GET_STATUS 8 -> 9 B the highest-frequency read on the bus, feeding
    fault flags, reset counts, uptime, stale
    detection, the event log and the HA sensors. A
    corrupted flags byte could invent a fault or mask
    a real one with nothing to catch it.
    GET_VERSION 8 -> 10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
    [ApiIndex.h, FollowerBus.cpp, ReflashPlan.h, SplitFlapProtocol.h, Unit.ino, UnitBus.cpp, UnitBus.h, UnitHealth.h]
2026-07-26 refactor(#408): share the 15 byte-identical headers instead of copying them
    The copy policy and its CI gate contradicted each other. The policy said
    pure-logic headers are copies, never shared includes; the gate enforced that
    15 of them stay BYTE-IDENTICAL. Together those mean the copies were
    forbidden from ever differing — so the duplication bought nothing and cost
    real mistakes.
    There was never a technical blocker. firmware/v2/shared/SplitFlapProtocol.h
    was already a genuine shared include and all four projects already built
    with -I ../shared, target and native envs alike. Rescue was the one
    exception and now has it too.
    Measured cost, from the session that prompted this: implementing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
    [BootHomePlan.h, DisplayWidth.h, HeartbeatPolicy.h, RenderStagger.h, TwibootProtocol.h, UnitExtDiag.h, UnitHealth.h, UnitLifetime.h]
2026-07-26 feat(#404): the self-test says WHICH of its three failures fired
    runSelfTest() sets `failed` in three places and they all collapsed into a
    bare SELFTEST_STATE_FAILED, after which the handler zeroed every
    measurement. /unit/self-test-result said exactly `{"state":"failed"}` — the
    master's own reason vocabulary (wire-fail / timeout / unit-failed) says why
    the MASTER gave up, never what the unit found.
    On a physical wall the three mean completely different repairs:
    hall-stuck cannot step OUT of the window — a magnet sitting against
    the sensor, or a sensor stuck low
    hall-never never saw the hall go low — a magnet that fell off, a dead
    KY-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
    [DisplayIpc.h, DisplayTask.cpp, FollowerOps.h, FollowerWeb.cpp, SplitFlapProtocol.h, Unit.ino, UnitMotion.ino, UnitProtocolHelpers.h]
2026-07-26 fix(#405): the protocol gate missed every single-unit maintenance endpoint
    Found by review over the combined branch diff, and confirmed: unitDrivable()
    was applied to renders, the moving-check, letter-verify and health polls, but
    maintValidateAddress() — the gate behind offset-write, jog, home, identify,
    reset-odometer, self-test, set-address and clear-address — only ever checked
    state == 1.
    So a unit reporting a contract we have no code for would still have received
    SET_I2C_ADDRESS: the single most consequential op in the protocol, an
    unverifiable address burn whose recovery is a physical trip to re-DIP, aimed
    at a unit whose reply layout we cannot parse. That directly contradicted bot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
    [FollowerBus.cpp, FollowerOps.h, MaintenancePolicy.h, UnitBus.cpp]
2026-07-26 feat(#268): the hall's one bit now polices a drum turned by hand at rest
    The sensor is sampled only while stepping, so hand-rotating an idle drum is
    invisible: the unit keeps believing its last commanded letter until some
    later move happens to sweep the magnet past the sensor. #263 already tracks
    drumPosition, so at rest the same bit still predicts what the sensor should
    read — a contradiction surviving 6 samples over 1.5 s means the drum moved
    without us, and it arms the SAME driftPending a mid-move observation does.
    The existing idle re-home is the entire correction path; this adds one
    digitalRead per 250 ms and no motion of its own.
    Ships dormant behind UNIT_GATE_IDLE_HALL_CHECK — #4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
    [Unit.ino, UnitIdleHall.h]
2026-07-26 feat(#409): SET_GATES (0x99) — the write half of the feature-gate byte
    #406 added featureGates (EEPROM byte 11) and #407's whole risk defusal rests
    on it being "settable over I2C": ship both motion changes off, prove the
    low-risk three on the wall, then enable one at a time. The byte was
    read-only. Nothing anywhere could write it, so enabling a gate would have
    taken a second 21-unit twiboot campaign — the exact cost the epic exists to
    avoid paying twice.
    Wire: gates + bitwise complement, the #405 write discipline, so neither an
    idle nor a stuck bus can spell a valid pair (0x00/0xFF and 0xFF/0x00 both
    decode; 0x00/0x00 and 0xFF/0xFF do not). Unlike SET_I2C_ADDRESS this write is
    fully ver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
    [ApiIndex.h, DisplayCommand.h, DisplayIpc.h, DisplayTask.cpp, FollowerBus.cpp, FollowerBus.h, FollowerOps.h, FollowerWeb.cpp]
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2026-07-26 fix(#409/#268): the review found three real ones — a dead endpoint and two loops
    Multi-agent adversarial review of the branch. 13 unique findings, 8 verified,
    4 confirmed. Three of those were defects in this arc's own code.
    **POST /unit/gates never executed on the S3.** `displayApplyCommand` gates the
    entire opcode dispatch in DisplayTask.cpp, and SetGates was missing from it —
    so the route validated, enqueued, answered 200 {"seq":N}, and was dropped.
    execSetGates, unitBusSetGates and displayApplyGatesWrite were all dead code;
    op-result sat on "pending" forever, giving the operator no failure signal. The
    ESP-01 follower dispatches on op.kind with no equivalent gate, so the same curl
    wor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
    [DisplayIpc.h, Unit.ino, UnitIdleHall.h, UnitMotion.ino]
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2026-07-26 feat(#412): stop the reflash from walking the row, and let it be gated
    Three control primitives for converging the fleet deliberately instead of
    handing a 21-unit sweep to a day-0 image that has never run on hardware.
    **Halt on consecutive failures.** The job logged a failed unit and walked
    straight on to the next one — an image that cannot land took the whole row
    down one unit at a time with nothing stopping it, and the boot auto-install
    does that unattended. Now two failures in a row end the run.
    Consecutive rather than total, because the two failure shapes need opposite
    answers and their signatures already distinguish them: a bad image fails on
    every unit it touches, so two is conclus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
    [ApiIndex.h, DisplayCommand.h, DisplayTask.cpp, PendingSettingsPost.h, ReflashPlan.h, Settings.h, SettingsJson.h, Tasks.cpp]
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2026-07-26 fix(#412/#413): review findings — surface the halt, harden the script's guard
    cpp-reviewer over the #412 firmware delta: no critical or high, one medium,
    and four of the five risks I asked it to attack came back unfounded with
    traces (halt vs. batch/settle, boot-gate seeding order, the unitAddress==0
    sentinel, both-phase filtering). It ran the native suite, compiled for the S3
    and ran cppcheck rather than reasoning from the diff.
    **The halt was invisible to anyone not watching the serial log.** It reached
    SerialPrintf and nothing else: /units/health's reflash object carries
    state/total/done/failed/cur, and a halted run with total=4 done=1 failed=3 is
    bit-identical to a run that attempted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
    [DisplayIpc.h, DisplayTask.cpp, ReflashPlan.h]
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2026-07-26 fix(#414): displayTask ran on 4 KB and crashed in the probe's vsnprintf
    The bench campaign (#413) killed split-flap-c8a746 repeatedly. The coredump
    is unambiguous: task "display", uncorrupted backtrace, faulting in the
    context-switch path while parked in newlib vsnprintf, reached from
    unitBusProbe's per-unit SerialPrintf.
    On Xtensa portSTACK_TYPE is uint8_t, so DISPLAY_TASK_STACK = 4096 is 4 KB --
    the only stack in this file with no bench evidence behind it, while netTask
    had already been moved off 4096 for overflowing its canary on this same
    board. runReflashJob rides displayTask too, so the fleet reflash pays the
    same peak the probe just proved is too deep.
    16384, not 8192: the HWM that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
    [Tasks.cpp]
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2026-08-05 feat(#431): remote coredump pull + purge, plus the board-side fixes for this week's forensics gaps
    - /coredump/raw ships in the release image (owner decision 2026-08-05:
    internal LAN-only deployment, task-stack exposure is accepted risk) and
    POST /coredump/erase purges the partition via the netTask drain; an open
    raw stream defers the erase so a download never reads a 0xFF tail (#431)
    - /coredump/summary carries the dump's own ELF sha, the running image's,
    and a computed stale flag — a dump is finally datable remotely (#416)
    - deliberate reboots stamp their cause to NVS (WiFi watchdog, web /reboot,
    MQTT restart) and the next boot serves it as lastRebootCause in
    /settings; consu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
    [ApiIndex.h, FollowerImageStore.cpp, MqttService.cpp, RebootCause.cpp, RebootCause.h, SettingsJson.h, SystemStats.cpp, SystemStatsPolicy.h]
2026-08-05 fix(#434): clockTask ran 4096 B at 364 B worst-case headroom — bump to 8192
    First /system/stats hwm readout (#415) put clockTask at 364 B free on BOTH
    wall masters — deterministic (newlib tz/localtime depth), one deeper library
    path from the #414 stack-canary panic class. displayTask stays 16384: its
    observed 4.1 KB peak excludes runReflashJob, which rides the same task and
    was not exercised this boot.
    [Tasks.cpp]
2026-08-05 fix(#411): FOLLOWER_HEALTH_BUF 6144 overflows since #405/#406 grew the health builder — 8192, lockstep with master
    The extended worst-case fixture (protocol + lifetime keys saturated)
    overflows 6144 exactly as the #410 review measured — a saturated 16-unit
    esp01 row would silently drop ALL per-unit health. Both trees'
    fullyPopulated() legend fixtures now exercise pv/pmm and the lifetime keys
    so neither the legend guard nor the capacity guard can go blind to the
    next key family.
    Closes #411
    [FollowerWeb.cpp]
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2026-08-07 chore(#437): clusterTask stack 8192 -> 12288
    Field HWM on a leader whose boot included a follower rollout: 1016 B free
    of 8192 (88% used) — the tightest task on the board, against display 26%,
    clock 49%, net 60%. It carries the deepest call stack: esp_http_client
    fan-out, SHA-256 HMAC signing on every leader-wire request, and the
    rollout chunk pump. Same trade as #434 took for clockTask.
    [Tasks.cpp]
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2026-08-14 fix(#440/#438/#448): make the standing warnings mean something again
    Three flags that were permanently on, and so permanently ignored. Two share
    a root cause: identity was stamped as "the commit I was built at" rather than
    "the thing I am", and repo HEAD moves for reasons the artifact does not care
    about.
    #440 — unit firmware identity is now the UNIT SOURCE HEAD, the last commit
    touching what compiles into the Nano binary, stamped by build_version.py into
    both the binary and the .rev sidecar so the two sides cannot drift. Previously
    every commit anywhere re-labelled all 21 units OUTDATED: 58 had landed since
    the last Unit source change. That is not cosmetic — ReflashPlan makes any
    fwSta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
    [ApiIndex.h, FollowerBus.cpp, RescueSlotStatus.h, UnitBus.cpp, UnitHealth.h, build_assets.py, build_version.py]
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2026-08-14 fix(#458): masters refuse feature-gate bits no unit firmware implements
    maintValidateGates checked the byte range only, on the reasoning that the
    vocabulary belongs to the unit "which refuses any bit it has no code for",
    with the SET_GATES read-back grading that refusal.
    The reasoning was sound; the premise was false. UNIT_GATE_ALL admits 0x02
    (#269 scheduled re-home) — declared in UnitEeprom.h and implemented nowhere.
    A unit accepts it, persists it to EEPROM, and reports it as active through
    GET_LIFETIME, so the read-back CONFIRMS a feature that does not exist. It is
    truthful about storage and silent about behaviour, and so cannot grade a
    vocabulary it never observes.
    Narrowing UNIT_GAT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
    [FollowerOps.h, MaintenancePolicy.h, SplitFlapProtocol.h]
2026-08-14 fix(#458/#417/#460): the unit tells the truth about its own gates, odometer and idle check
    Three unit-firmware changes that each needed a reflash, bundled so one
    campaign pays for all of them.
    #458, unit side. UNIT_GATE_ALL admitted 0x02, a bit no unit code ever
    read, so a unit accepted it, persisted it and reported it back through
    GET_LIFETIME — the SET_GATES read-back verified STORAGE and said nothing
    about BEHAVIOUR. The masters already refuse to send it (#459); this is
    the unit's own half. 0x02 is RETIRED rather than reserved: #269 turned
    out to be entirely master-side, so the bit was never going to grow code,
    and a constant nothing reads is what made this possible. Both ApiIndex
    lege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
    [ApiIndex.h, Unit.ino, UnitEeprom.h, UnitHealth.h, UnitLifetime.h]
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2026-08-14 fix(#462): re-probe the row after a follower unit reflash
    GET /unit/offset on the follower serves probe-time facts, and every reflash
    path reaches the flash through a probe taken with its targets sitting in
    twiboot — where the offset read cannot succeed. offsetValid was left false for
    every unit just flashed and nothing repopulated it: busPollHealth is a health
    poll, not a probe, and never reads the offset. A 5/5 row came back reporting
    "Unit did not return a valid offset (firmware may predate #32)" with its
    calibration completely intact, and restore-unit-offsets.sh read the same cache
    and called the whole row UNREADABLE — at the exact moment an operator checks
    whether the reflash destro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
    [FollowerBus.cpp]
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2026-08-14 chore(#466): gate the claimed-block table against the header it guards
    Codex review of the first cut: the rewritten guards still could not see a
    block that was never added to their table — the same hole #466 is about,
    moved one step back. No host test can see a constant it was not told about,
    so this reads UnitEeprom.h instead and requires the convention to hold: a
    checksummed block declares both a _BLOCK_LEN and a _CHECKSUM_MASK, and both
    must appear in test_eeprom_layout. A pinned inventory catches anything that
    declares neither, so a field cannot land un-checksummed and unnoticed.
    All three of the review's counterexamples now fail: an overlapping block, a
    field landing without EE_RESER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
    [FollowerBus.cpp]
2026-08-14 docs(#462): pin the twiboot-window math the settle relies on
    cpp-reviewer traced it to the bootloader source: TIMEOUT_MS is 1000 and the
    Nano's reboot path adds delay(10) + WDTO_15MS, so a unit jumps to its app at
    about T+1025 ms while the settle's first poll at T+1000 still reads 0xFF and
    cannot exit before T+1100. The safety is structural and independent of
    REFLASH_BATCH_SIZE, not an inherited margin — record the numbers so a future
    tuning of either constant can see what it would break.
    [FollowerBus.cpp]
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2026-08-26 fix: mqttTask stack 6144 -> 12288 — first broker connect overflowed it
    The first-ever broker enable on the fleet put the leader into a ~20 s
    boot crash-loop: coredump task=mqtt with the 0xa5 stack-fill pattern in
    excVaddr and a corrupted backtrace, and /system/stats showed hwm.mqtt at
    1768 bytes free while DISABLED-idle — the connect + 24-entity discovery
    burst had no headroom to run in. Same family as #434/#437.
    Closes #479
    [Tasks.cpp]
2026-08-26 fix: net/mqtt/cluster task stacks to >=50% margin at measured peaks
    Post-#479 audit with MQTT live: net 4888 peak / 8192 (40%), mqtt 7156 /
    12288 (42%), cluster 7256 / 12288 (41%). #479 proved a never-exercised
    path can need far more than the busiest observed one, so every app task
    now carries >=50% margin: net 12288, mqtt 16384, cluster 16384. +12 KB
    static DRAM (44.8% -> 48.5%); display/clock already qualify.
    Closes #480
    [Tasks.cpp]
2026-08-27 chore(#468): follower bus reads publish-on-complete so async readers never see a torn slot
    busProbe() zeroed each unitFacts slot wholesale and refilled it field by
    field over yielding I2C reads; busPollHealthOne() mutated the shared slot
    the same way on every heartbeat. An async GET (/units/health, /unit/offset,
    /settings) landing mid-update could report a unit absent/unversioned/
    offset-invalid — the same transient-wrong-reading shape as #462, and
    restore-unit-offsets.sh cannot tell it from a real UNREADABLE.
    Both now build the slot in a scratch UnitFacts and publish it with one
    struct assignment (no yield inside a copy on this single-core part);
    detectedUnitCount is published once at sc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
    [FollowerBus.cpp]
2026-08-27 chore(#390): blank a stale intendedVersion on the boot after an out-of-band recovery
    A rescue-path recovery (or USB flash) leaves the last normal OTA's ?v=
    diagnostic naming an image the board is no longer running. Pure
    otaShouldBlankIntendedVersion() (OtaStatus.h, natively tested) blanks it
    at boot when it mismatches the running rev — gated on the SYNTHESIZED
    verdict, not the raw rolledBack flag, so a genuine revert keeps the
    mismatch that is the field's whole purpose and a corpse-mark boot still
    blanks. One NVS write, only on the boot after such a recovery.
    [OtaStatus.h, main.cpp]
2026-08-27 feat(#465): odometer historian — per-unit wear history persisted to the storage LittleFS
    The unit's EEPROM was the only place a revolution count existed, and #417's
    sweep plus #463's ring resize each erased the whole fleet's history in an
    afternoon (a5's 2737-vs-19 anomaly is gone unrecorded). The unit stays
    authoritative; this is the historian.
    netTask (sole storage writer) appends CSV rows epoch,addr,revs[,R] from the
    mutex-copied snapshot: a boot baseline row per unit, then one row per unit
    per day once the count moves, and an immediate R row when a count goes
    BACKWARDS while the master is up — a reset is a fact, not a gap, so
    lifetime wear is the sum across the epochs the R rows del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
    [OdometerLog.cpp, OdometerLog.h, OdometerLogPolicy.h, Tasks.cpp, WebSystem.cpp]
2026-08-27 chore(#475): /api legend documents err/errAge — the last undocumented unit keys
    The per-unit I2C error attribution (#367) emits err/errAge from
    UnitHealth.h but the legend never listed them, so the TUI's drift gate
    carried them as a hardcoded exception — now removed, fixture updated.
    Also in ApiIndex.h (one file, one commit): #465's /units/odometer-log
    index row, and the API_JSON_CAP bump 8192 -> 9216 the two additions forced
    (caught by test_api; the /api handler heap-renders per request, so the
    cost is transient, not BSS).
    [ApiIndex.h]
2026-09-26 fix(follower): auto-recover a slave-held I2C bus instead of freezing the row
    The ESP8266 core's bit-banged write_start() refuses to START while SDA reads
    low and never clocks the bus itself, so a Nano left mid-byte holds SDA
    forever and the row freezes until a power cycle. A pure detector
    (FollowerBusRecovery.h) trips after 6 consecutive heartbeat liveness misses
    across >=2 units, runs Wire.status() to clock SDA free with 5 s..5 min
    backoff, re-shows the last frame once the bus answers, and reports the
    episode in /cluster/health's new `bus` block.
    Refs #488
    [ApiIndex.h, FollowerBus.cpp, FollowerBus.h, FollowerBusRecovery.h, FollowerJson.h, FollowerWeb.cpp]
2026-09-26 fix(follower): clock a held bus free at boot and recover an empty row
    Bench: a warm OTA reboot left the Nanos powered with SDA still held, the
    boot probe found 0 units, and the liveness detector had nothing to poll.
    busInit() now clocks the bus free before the first scan, and a row with no
    detected unit opens a recovery episode that clocks + quietly re-probes on
    the same backoff until units answer.
    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
    [FollowerBus.cpp, FollowerBus.h, FollowerBusRecovery.h]
2026-09-26 fix(unit): self-heal a wedged TWI that holds the bus low
    Bench: a Nano's TWI held SDA low with SCL free; no master clock-out freed it
    and the 8 s WDT never fired, so the row needed a power cycle. loop() now
    samples SDA/SCL; a line held >= 50 ms (1 s cooldown) drops TWEN, and a line
    that comes free right then was ours — counted since boot in ext-diag
    statusBits bits1-3 (`sb`), so the count names the culprit unit. Wire.begin()
    + TWGCE re-arm restore the slave. Wire format unchanged (reserved bits).
    Closes #489
    [ApiIndex.h, Unit.ino, UnitExtDiag.h, UnitI2CProtocol.ino, UnitMotion.ino, UnitTwiHeal.h]
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2026-09-28 ci: bump GitHub actions and esptool to 5.x
    checkout v7, setup-python v7, cache v6; esptool 5.4.0 in the flasher
    test job. esptool 5 renames subcommands and options to hyphen form
    (write-flash, merge-bin, erase-flash, --flash-size, no-reset); the
    flasher invocation, its test and the provisioning recipes move to them.
    Closes #494
    [use_custom_bootloader.py]
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2026-09-30 feat: runtime rescue of lost units on Master and ESP-01 rows (#498)
    A unit that stops answering was never re-probed: the heartbeat latched
    stale and nothing acted on it. Only boot and reflash ever checked for
    twiboot, so a unit pinned there, or rebooted blank, stayed dark until a
    power cycle.
    shared/UnitRescuePolicy.h decides, per unit, from the heartbeat tick:
    - lost -> probe at once, then every 60 s: no ACK / twiboot (send
    start-application) / sketch ACKs but reads fail; each outcome logged
    - the first good read after any loss episode re-shows the last frame (a
    rebooted unit comes back unhomed and blank)
    - twiboot exits are counted and surfaced as the per-unit "rsx" key in
    /units/he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
    [ApiIndex.h, DisplayTask.cpp, FollowerBus.cpp, UnitBus.cpp, UnitBus.h, UnitHealth.h, UnitRescuePolicy.h]
2026-09-30 feat: motion admission — cap concurrent movers, radio-quiet gate, sag-adaptive budget (#505)
    The master, its units and the steppers share one 5 V supply. The #324
    stagger only spread the START of each move; a move lasts seconds, so a
    full-row render still ended with every stepper energised at once, /stop
    broadcast-homed all units in one transaction, and boot-home ran in the
    same second as the WiFi join.
    shared/MotionBudget.h (natively tested):
    - MotionTracker: a unit is admitted only when fewer than `cap` tracked
    units still report moving (start grace, stuck cutoff, silent = idle)
    - MotionBudgetState: cap halves on each new unit vmin low under 4.70 V,
    restores one step per 10 quiet mi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
    [DisplayTask.cpp, FollowerBus.cpp, FollowerWifi.cpp, FollowerWifi.h, MotionBudget.h, UnitBus.cpp, UnitBus.h, WifiService.cpp]
2026-09-30 fix: join WiFi at reduced TX power on the S3 (#505)
    A plain OTA software restart came back as a brownout with every stepper
    idle: the join's TX bursts are the S3's own start-up peak on the shared
    5 V rail. Join at 8.5 dBm, restore the SDK default once online. The RF
    calibration inside WiFi.mode() still runs at full power (setTxPower needs
    a started STA).
    [WifiService.cpp]
2026-09-30 feat: persistent boot-stage trace — where do failed boots stop (#504)
    A soft reboot of the leader sometimes never comes back online until a
    manual power cycle, and that power cycle erased every trace of what the
    failed boots did. An NVS ring (8 boots) now records each boot's reset
    reason and the furthest stage it reached: setup -> init-done -> units ->
    join -> online, rewritten only when the stage advances.
    The next boot logs the streak of boots that never came online, and
    /settings serves the ring as "bootTrace".
    [BootTrace.cpp, BootTrace.h, BootTracePolicy.h, DisplayTask.cpp, SettingsJson.h, WebEndpoints.cpp, WebEndpoints.h, WifiService.cpp]
2026-09-30 feat: crash context — what each task was doing when the S3 died (#504)
    The leader's "doesn't come back after a reboot" turned out to be an
    interrupt-watchdog boot loop right after coming online, with no coredump.
    Each task now marks its current activity (every unit-bus transaction with
    its address, WiFi, web drain, MQTT, cluster fan-out, idle) in RTC_NOINIT
    memory, which survives watchdog/panic/brownout resets. The boot after a
    crash logs every task's activity and how long it had been in it, and
    /settings serves it as "crashContext".
    [CrashContext.cpp, CrashContext.h, CrashContextPolicy.h, DisplayTask.cpp, SettingsJson.h, Tasks.cpp, UnitBus.cpp, WebEndpoints.cpp]
2026-09-30 fix: crash context stores only 32-bit words in RTC memory (#504)
    Byte-wide act/arg fields read back as their armed zeros after a reset
    while the uint32 tick beside them survived, so the first captured crash
    reported every task as 'none'.
    [CrashContextPolicy.h]
2026-09-30 fix: crash context survives static init; panic handler runs from IRAM (#504)
    The crash record on the leader still read 'none' for every task after
    fa6ca0b, while its magic and tick survived. The cause was not RTC byte
    stores: CrashSlotState's default member initializers gave the RTC_NOINIT
    global a constructor, and C++ static init ran it at every boot, before
    setup(), zeroing exactly the fields that had initializers. The record is
    now trivially constructible, with a static_assert and a test that
    re-runs static init over a filled record.
    The leader's interrupt-watchdog resets leave no coredump. The panic
    handler lived in flash, so an IWDT that fires while the flash cache is
    off cannot run it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
    [CrashContextPolicy.h, FlashLog.cpp]
2026-10-02 fix: S3 radio stays at reduced TX power for its whole life (#506)
    The leader died on a corrupted instruction fetch right after startOnline()
    restored full TX power. Stop restoring it; apply the same reduced power to
    the setup portal.
    [WifiService.cpp]
2026-10-02 feat: WiFi TX power ladder — start lowest, one level at a time (#507)
    Every boot starts at 2 dBm. The join climbs one real IDF level every 7 s up
    to 8.5 dBm; online, a link drop or a sustained weak uplink estimate earns one
    level (idle units only, not in the first minute, at most one per minute,
    ceiling 13 dBm) and a long healthy period gives one back. Nothing persists
    across reboots. The level is reported as txPower in /system/stats.
    [ApiIndex.h, SystemStats.cpp, SystemStatsPolicy.h, WifiService.cpp, WifiService.h, WifiTxPolicy.h]
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2026-10-02 fix: a boot-section dump re-shows the frame once the unit is back (#511)
    The dumped unit restarts unhomed and blank, and nothing re-showed its flap.
    [ApiIndex.h, DisplayTask.cpp]
2026-10-02 fix: a boot-section dump homes the unit before the re-show (#511)
    A dumped unit whose flap is blank stayed unhomed: the frame write skips a
    unit that already reports its letter.
    [DisplayTask.cpp]
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2026-10-03 feat(#499): lean new twiboot image + both update stages proven in sim
    Build the second-generation twiboot behind -DSF_NEW_TWIBOOT: EEPROM dropped,
    MCUSR stashed to GPIOR0 (reset cause reaches the sketch), bounded pin (a
    pinned bootloader returns to the app after a quiet period instead of forever),
    do_spm at a fixed 0x7F80, ABI marker at 0x7FFE. make_new_twiboot.py assembles
    the image (pages 0-6 from main.c + page 7 from do_spm.S) and emits the PROGMEM
    header consumed by the sim and, later, the unit firmware.
    The simavr harness now proves both stages against the REAL new image (not test
    patterns), byte for byte over the whole boot section (sim/prove.sh):
    stage 1 drives the fielded twiboot'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
    [main.c, make_new_twiboot.py]
2026-10-03 feat: ESP-01 follower boot-reflash brake, per-unit reflash and reset history
    The follower reflashed every outdated unit at every boot with no way to stop
    it, and its /reflash-units ignored ?address= and did the whole row, so a
    gated one-unit-at-a-time campaign was impossible on an ESP-01 row.
    - reflashOnBoot (default true) gates both boot passes. Persisted in a 3-byte
    record behind the EEPROM membership blob, whose layout and magic are
    untouched; an unreadable record decodes to the default. Set with
    POST /settings, reported by GET /settings under the S3's key name.
    - POST /reflash-units?address=N reflashes exactly that unit as a {"seq":N}
    op. The address is decimal and query-only; a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
    [ApiIndex.h, FollowerBus.cpp, FollowerBus.h, FollowerCluster.cpp, FollowerJson.h, FollowerLog.cpp, FollowerLog.h, FollowerOps.h]
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2026-10-03 feat: WiFi TX ladder steps up on evidence of need and logs why
    A board that joined at 2 dBm and was answering its leader the whole time
    still climbed to 13 dBm and stayed there, because the ladder stepped up on
    a weak uplink ESTIMATE (rssi + own TX - 20 dBm < -80) alone.
    - A weak estimate now counts only while no two-way cluster exchange is being
    confirmed, and never takes the board past the join ceiling (8.5 dBm).
    Beyond that only a dropped link earns a level, up to the online ceiling.
    Confirmed = a member contact answered or a leader request served within
    30 s (S3), or Clustered with a fresh leader contact (ESP-01).
    - Losing leader contact is not evidence by itself (a rebooting le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
    [FollowerCluster.cpp, FollowerCluster.h, FollowerPolicy.h, FollowerWifi.cpp, WifiService.cpp, WifiService.h, WifiTxPolicy.h]
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2026-10-03 fix: a unit reply the master never read cannot answer a later request
    The unit kept one pending flag per reply type and requestEvent() served
    them in a fixed order, so a GET_* whose read never arrived left its flag
    set and every later read answered the request before it. One reply slot
    now holds the request; every master write, a bare probe included, clears
    it first.
    Refs #502 (item 2).
    [Unit.ino, UnitI2CProtocol.ino]
2026-10-03 feat: unit re-arms a TWI that stopped listening, and reports link health
    A unit whose TWCR lost TWEN/TWIE/TWEA, or whose TWAR lost its address or
    general-call enable, NACKs forever with both lines free: the held-line
    heal never sees it and loop() keeps the watchdog fed. loop() now checks
    both registers and re-inits the peripheral once the config has been wrong
    for the hold window, at an instant with both lines high.
    The ext-diag reply grows a checksummed 10-byte link extension behind the
    unchanged 11-byte base packet: seconds since boot as u32 (counted from
    millis() deltas, so no 18 h saturation and no 49.7-day wrap), frames
    received and replies sent, and the count of those re-inits. A mast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
    [Unit.ino, UnitExtDiag.h, UnitI2CProtocol.ino, UnitMotion.ino, UnitTwiHeal.h]
2026-10-03 feat: no-argument unit mutations carry a complement guard byte
    HOME, REBOOT, ENTER_BOOTLOADER, CLEAR_I2C_ADDRESS, IDENTIFY, RESET_ODOMETER
    and START_SELF_TEST were one unguarded byte on the wire, one bit flip away
    from a letter index (bit 7) or a GET_* poll (bit 4). Both row masters now
    send them as opcode + ~opcode; units predating the guard drain the extra
    byte, so the form is sent unconditionally.
    The unit refuses such an opcode when a trailing byte is present and is not
    the complement. That holds with no configuration and is what stops a
    bit-flipped two-byte letter write. Behind the new feature gate 0x04
    (off by default) it also refuses the bare one-byte form, closing the
    bit-flipped-po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
    [FollowerBus.cpp, SplitFlapProtocol.h, UnitBus.cpp, UnitEeprom.h, UnitI2CProtocol.ino, UnitWireContract.h]
2026-10-03 fix: unit I2C hardening review findings
    - Link counters are encoded in requestEvent(), not loop(): they froze for
    the length of a blocking move, so a busy unit read as a deaf one.
    - The deaf-slave check only accumulates bad samples while loop() samples
    densely; a transient caught either side of a blocking move no longer
    adds up to a re-init. Both TWI re-inits drop the pending reply.
    - Masters keep sending ENTER_BOOTLOADER bare. A unit sitting in twiboot
    ACKs exactly one byte, so a guard byte turned the reflash paths' success
    status into a data NACK; the unit accepts the bare form in every mode.
    - JOG carries its complement. A letter write whose index flips onto 0x91
    was a valid o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
    [FollowerBus.cpp, SplitFlapProtocol.h, Unit.ino, UnitBus.cpp, UnitEeprom.h, UnitExtDiag.h, UnitI2CProtocol.ino, UnitMotion.ino]
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2026-10-03 feat: master drivers for in-system twiboot update (#499)
    POST /unit/boot-update?address=N on both the S3 master and the ESP-01
    follower: reads GET_BOOT_INFO, decides which stages (if any) the unit
    needs, drives them with probe-inhibit and verify, and reports via the
    standard /unit/op-result?seq=N surface.
    Stage 1 (page 7 install) causes a WDT reset — the driver arms
    probe-inhibit, waits for the unit to return, homes it, and verifies
    PAGE7_INSTALLED before proceeding. Stage 2 (pages 0-6 rewrite) polls
    until the unit reports state NEW or a terminal failure.
    Decision logic extracted to shared/BootUpdatePlan.h with native tests
    (test_boot_update_plan, 8 cases) — both masters call bootUpdat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
    [ApiIndex.h, BootUpdatePlan.h, DisplayCommand.h, DisplayIpc.h, DisplayTask.cpp, FollowerBus.cpp, FollowerBus.h, FollowerOps.h]
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2026-10-03 fix: unit reports unreadable lock and fuse bytes instead of program bytes
    On 11 of the 21 fielded units boot_lock_fuse_bits_get() behaves as a plain
    lpm and returns the sketch's first four flash bytes (the reset vector) as
    lock, low, high and extended fuse: repeatable per unit, with interrupts off
    and no EEPROM write in progress. The boot report presented those as values,
    and the update guard passed on them because 0x94 happens to have the BLB11
    bit set.
    - The unit recognises the fall-through (all four bytes equal the flash bytes
    at their Z addresses) and flags the report: bit 7 of the result byte, with
    placeholder bytes. A report from a unit that reads its fuses is
    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
    [BootInfo.h, BootUpdatePlan.h, BootUpdateReport.h, UnitBootUpdate.ino]
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2026-10-03 perf: ESP-01 follower frees ~20 KB of RAM held by three handlers
    Static RAM 60,492 -> 40,748 B of 81,920 (flash +2.5 KB). The follower ran
    with ~11 KB free and dipped to 3.5 KB during a unit reflash; GET /api
    returned an empty body twice when the heap could not hold its copy.
    - GET /api: the reply is fixed text. build_assets.py renders it from
    ApiIndex.h's tables into ApiIndexAsset.h (PROGMEM) and the handler sends
    it from flash. Gone: a 6,144 B static buffer, the tables' string literals
    in RAM, and a ~5.8 KB heap copy per request. A pytest compiles
    buildApiJson() on the host and requires the generated text to match it
    byte for byte.
    - GET /units/health: built in a buffer sized fo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
    [ApiIndex.h, FollowerLog.cpp, FollowerLog.h, FollowerOps.h, FollowerWeb.cpp, build_assets.py]
2026-10-03 fix: boot-update drivers report what the unit said and do not act on stale results
    From the #499 driver review, on both row masters:
    - A stage 1 the unit refuses (not homed, lock closed) no longer costs a
    wait, a pointless homing run and a "verify failed". An accepted stage 1
    takes the unit off the bus at once and for over a second, so a unit that
    still answers at +200 and +500 ms never started; the op ends with the
    unit's own reason (new: boot-unit-busy).
    - The drum settles before stage 1 is requested: a request sent mid-move is
    held by the unit and would otherwise run after the op has reported.
    - The stage-2-only path (a unit already carrying page 7) homes first.
    - The stage 2 p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
    [BootUpdatePlan.h, DisplayIpc.h, DisplayTask.cpp, FollowerBus.cpp, FollowerOps.h, MaintenancePolicy.h]
2026-10-03 fix: review findings on the boot-update drivers and the follower handlers
    Boot-update drivers (both masters):
    - The settle wait before stage 1 was best-effort: on a timeout the request
    was sent anyway, the unit held it until its move ended, and then ran
    stage 1 after the op had reported, with nobody keeping the bus quiet. A
    drum that does not settle now ends the op with boot-unit-busy.
    - Whether stage 1 started is decided by a pure helper
    (bootStage1WentOffBus) with native tests; a single failed read is
    confirmed before it counts, so one corrupted reply from a refusing unit
    no longer sends the driver down the reboot path.
    - A unit that never left the bus and recorded no refusal r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
    [BootUpdatePlan.h, DisplayIpc.h, DisplayTask.cpp, FollowerBus.cpp, FollowerOps.h, FollowerWeb.cpp, MaintenancePolicy.h, UnitBus.cpp]
2026-10-03 feat: unit stays put on a failed home, clamps speed, and reports why it reset
    Failed home (items 1 and 3):
    - A seek that never finds the hall marker is no longer followed by stepping
    to the letter from an unknown position and reporting that letter as shown.
    The unit drops `homed`, keeps the commanded letter, and answers GET_LETTER
    with SFP_LETTER_UNKNOWN (outside every flap index, so a master treats the
    read as unreadable instead of verifying against a guess).
    - A failed home owes a retry the unit pays by itself: 30 s after the failed
    seek ended, doubling per consecutive failure up to 16 min (about 2 % motor
    duty on a unit whose sensor is dead). A one-off failure heals without th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
    [SplitFlapProtocol.h, Unit.ino, UnitBootUpdate.ino, UnitEeprom.h, UnitHomePolicy.h, UnitI2CProtocol.ino, UnitMotion.ino, UnitResetCause.h]
2026-10-03 feat: row masters show unit link health and decode the unit's reset cause
    - Both masters read the full GET_EXT_DIAG reply and validate the base packet
    and the link extension independently. /units/health gains per unit:
    ut (uptime in seconds, not saturating), rx / tx (frames the unit received /
    replies it sent, wrapping u16), dh (TWI self-check re-inits).
    - The S3 master names a unit's reset cause with shared/UnitResetCause.h, the
    rules the unit counts by: a power-up is no longer logged as a brownout, and
    a reboot the unit was asked for is logged as requested, not as a hang.
    - Each master asserts that its wire speed range stays inside what a unit
    accepts.
    - ESP-01 /units/health al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
    [ApiIndex.h, DisplayTask.cpp, FlapFrame.h, FollowerBus.cpp, FollowerOps.h, UnitBus.cpp, UnitEventLog.h, UnitHealth.h]
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2026-10-03 fix: a unit's lifetime reset counters are history, not a standing fault
    Both masters counted a unit as faulty whenever its lifetime brownout or
    watchdog counter was non-zero. That rule was never exercised while the
    counters could not move; now that units report real resets, the one reset
    every unit carries from the last firmware campaign made all 21 read faulty.
    A unit is now faulty for a reset only when a counter climbs while the master
    is watching it. Each master keeps a per-unit baseline in its bus layer
    (outside the facts, which a probe rescan rebuilds), so the verdict survives a
    rescan and clears on a master reboot. /units/health marks such a unit with
    "rs":1, and the web UI's fault hi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
    [ApiIndex.h, FollowerBus.cpp, FollowerOps.h, UnitBus.cpp, UnitHealth.h]
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2026-10-03 fix: one failed WiFi join no longer costs five minutes in the setup portal
    A board with stored credentials got one 30 s join window at boot, then sat in
    the setup portal for 5 minutes before rebooting to try again. On 2026-10-03
    the leader's first boot after an OTA failed to associate once and was off the
    network for 6 minutes; its second boot joined in 3 seconds.
    S3 master: a join window that closes without a link is followed by a reboot
    and another attempt, up to 3 boots in a row, before the portal opens. The
    tally is an RTC_NOINIT record (kept by a software reset, lost on a power
    cycle, validated by magic + complement), cleared on going online and on
    opening the portal, so the portal's o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
    [FollowerConfig.h, FollowerWifi.cpp, WifiPolicy.h, WifiService.cpp]
2026-10-04 fix(v2): twiboot wire code — post-flash retry, stats fix, safety guards
    - Post-flash ACK polls 5× at 500 ms instead of one shot after 2 s,
    reducing false PostBootSilent on slow-booting units
    - twibootWriteFlashPage uses bare Wire.endTransmission() instead of
    countedTransmission(), matching the design comment (twiboot traffic
    is deliberately not counted in the System tab I2C stats)
    - Verify-mismatch log includes the unit I2C address for batch clarity
    - CMD_REBOOT result is checked and logged on failure, using
    countedTransmission() since it is sketch-protocol traffic
    - Image size guard bails before flashing if the image would overwrite
    the twiboot boot section
    Closes #525
    Co-Aut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
    [UnitBus.cpp]
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2026-10-04 refactor: one twiboot client for both row masters
    The twiboot I2C flash protocol was written twice, in Master/UnitBus.cpp and
    FollowerEsp01/FollowerBus.cpp, and had drifted: of the five #525 fixes the
    follower still lacked three. It now lives once in shared/TwibootFlash.h as
    function templates over a bus adapter; each tree supplies a WireTwibootBus
    and keeps only its orchestration.
    Shared: ping, exit, ready-wait, bootloader liveness, bootloader probe, chip
    check, page read, page write with the truncated-burst check, write+verify
    with one rewrite, the image size guard and the post-exit sketch poll.
    The follower gains, by using it:
    - the image size guard before any page is written;
    - the 5 x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
    [FollowerBus.cpp, TwibootFlash.h, TwibootProtocol.h, UnitBus.cpp]
2026-10-04 fix: ESP-01 row renders lowercase and unknown characters like the S3
    The follower mapped characters to flaps with its own loop: no uppercasing,
    and a character the drum lacks was skipped, leaving the previous letter
    standing. Mixed-case content sent to an ESP-01 row (the cluster clock date
    row "13 Jul 26") left those positions un-rendered.
    shared/FlapLetters.h now holds the one mapping (flapLetterIndex,
    flapLetterOrBlank), the web-to-wire speed conversion and MIN_SPEED/MAX_SPEED;
    Master/FlapFrame.h keeps only the alignment pass. tests/test_shared_logic.py
    starts the epic's source gate: no tree walks SFP_ALPHABET or defines the
    speed range itself.
    Closes #528. Part of #538.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
    [FlapFrame.h, FlapLetters.h, FollowerBus.cpp, FollowerConfig.h, SplitFlapProtocol.h]
2026-10-04 refactor: one maintenance vocabulary and reflash plan for both row masters
    FollowerOps.h was a hand copy of Master's MaintenancePolicy.h, ReflashPlan.h
    and the op-result parts of DisplayIpc.h, and had drifted. The ESP-01 row
    gains, by using the shared headers:
    - the #405 protocol-mismatch clause: a unit reporting a wire contract we do
    not speak is a reflash target for both the operator job and the boot
    auto-update;
    - the #412 consecutive-failure halt: two failed units in a row stop the
    sweep, and /units/health's reflash object carries "halted".
    shared/MaintenancePolicy.h now holds the validators, encoders, outcome and
    reason vocabulary, and the op-result / self-test-result JSON (the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
    [DisplayIpc.h, FollowerBus.cpp, FollowerOps.h, FollowerWeb.cpp, MaintenancePolicy.h, ReflashPlan.h]
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2026-10-04 refactor: one LAN-origin / CSRF check for Master, follower and Rescue
    The LAN-origin check and the CSRF reject existed three times, identical
    apart from the prefix (ClusterDigest.h, FollowerCors.h, RescueCors.h), plus a
    fourth private-IPv4 parser behind the leader's SSRF guard. A fix to this
    security boundary would have reached one board.
    shared/LanOrigin.h now holds lanPrivateIpv4, lanHostIsLocal, lanOriginAllowed
    and lanCsrfRejectPost; each tree keeps only its CORS path allowlist. Rescue
    consumes the shared header: it already builds with -I ../shared, and the
    "shares nothing with Master" rule is about the Master tree, not about pure
    headers compiled into its own image. RescueCors.h is gon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
    [FollowerWeb.cpp, LanOrigin.h, RescueWeb.cpp, WebEndpoints.cpp]
2026-10-04 refactor: one cluster member phase machine and one set of unit timings
    FollowerPolicy.h was a near-identical, unlisted copy of the phase machine in
    Master's ClusterFollowerPolicy.h with every identifier renamed, which is why
    the copy gate never saw it.
    - shared/ClusterMemberPhase.h: the phase machine, epoch/seq armor, sticky
    leadership, commitAt delay and the contact timeouts. The last phase is
    LeaderLost; what it shows is the tree's choice (own clock on an S3, blank
    on an ESP-01 row), as is its name in /cluster/health ("local-fallback" /
    "blank", unchanged on the wire).
    - shared/UnitTimings.h: twiboot startup, pre-probe delay, probe inhibit,
    return/home timeouts and the stuck-ren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
    [BootUpdateOp.h, ClockTask.cpp, ClusterMemberPhase.h, DisplayTask.cpp, FollowerBus.cpp, FollowerClock.h, FollowerCluster.cpp, FollowerCluster.h]
2026-10-04 refactor: one OTA upload gate for Master, Rescue and the ESP-01 follower
    The upload session logic existed four times (Master app slot, Master factory
    slot, Rescue, follower) and had drifted. shared/OtaUploadGate.h now holds the
    decisions; each tree keeps its own flash calls.
    - otaUploadGate: CSRF, then unit-reflash-busy, then the md5, all before any
    flash is touched. The follower only checked md5.length() == 32, so a
    non-hex digest reached Update.begin — a flash erase — before failing; it
    now uses normalizeOtaMd5 like the others (the Rescue copy is gone).
    - The follower refuses an upload with 409 while a unit reflash is queued or
    running: the upload ends in a reboot that would s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
    [FollowerWeb.cpp, OtaStatus.h, OtaUploadGate.h, RescueWeb.cpp, RescueWeb.h, WebFirmware.cpp]
2026-10-04 fix: OTA upload review findings — rescue-slot ownership, watchdog races
    From the review of the shared upload gate:
    - Master /firmware/rescue: an overlapping request used to set the shared
    rejection, which also stalled the live install. With the rejection now
    consumed on send, the live install's owner marker could be left dangling
    (a later request at the same address would read as "installed") and the
    loser's remaining chunks could be written into the live session. The
    overlapper now gets a per-request 409 like /firmware/master, only the
    request that began the install writes into it, the marker is cleared
    whenever it is ours, and a disconnect clears it too. The live install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
    [OtaUploadGate.h, RescueWeb.cpp, WebFirmware.cpp]
2026-10-04 refactor: shared cluster-wire member guards, auth state and reply block
    The member side of the cluster wire was implemented in Master/WebCluster.cpp
    + ClusterFollower.cpp and again in FollowerEsp01/FollowerWeb.cpp +
    FollowerCluster.cpp, with small drift. shared/ClusterWireGuards.h now holds
    what is decision rather than glue:
    - clusterJoinValidate: row bound, leaderHost/leaderName shape and the #313
    source-IP binding. The ESP-01 accepted rows up to 255; every member now
    bounds the row by the leader's table (CLUSTER_MAX_MEMBERS).
    - clusterCallerIsForeign for render and ping, clusterLeaveAllowed for the
    keyed and unkeyed leave guards.
    - ClusterMemberAuth: the per-member key and replay ma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
    [ClusterLayout.h, FollowerCluster.cpp, FollowerJson.h, FollowerSettings.h, FollowerWeb.cpp]
2026-10-04 refactor: shared NVS contract between Master and Rescue; fold small duplicates
    - shared/NvsContract.h: the NVS namespace and the keys more than one S3 image
    reads (deviceName, wifiSsid, wifiPass, slotRec0/1/F). Rescue hard-coded
    what Master defines, with nothing tying the two together — a rename on the
    Master would have left a rescue image that cannot join WiFi. Both spell
    them from the header now, and a gate forbids the literals in the files that
    touch NVS.
    - shared/JsonEscape.h: one appendJsonString. There were three escapers with
    different escaping (SettingsJson.h, FollowerJson.h, and MdnsDiscovery.h,
    which the new gate found); the two weaker ones did not use the short for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
    [FactorySlot.cpp, FollowerJson.h, FollowerWeb.cpp, JsonEscape.h, NvsContract.h, NvsSettingsStore.h, OtaService.cpp, Settings.h]
2026-10-04 fix: a request without a file part never answers with an old flash error
    Found on the bench while probing the shared upload gate:
    - The flash layer's error state is a singleton that outlives requests, so a
    POST without a file part sent after a failed upload answered 500 with that
    earlier upload's error instead of its own 400. otaUploadCompletion now
    checks "did this request stream anything" before anything the flash layer
    says (same reasoning as the #347 rule for "finished").
    - Master: a client that died mid-upload cleared the session owner in
    onDisconnect, and the stall watchdog keys on the owner — so nothing thawed
    MQTT again until the next reboot. The disconnect handler now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
    [OtaUploadGate.h, WebFirmware.cpp]
2026-10-04 refactor: one unit-bus protocol layer for both row masters
    #526 put the twiboot client behind one Wire adapter; everything above it in
    Master/UnitBus.cpp + DisplayTask.cpp and FollowerEsp01/FollowerBus.cpp was
    still written twice. It now exists once, as templates over that adapter:
    - shared/UnitBusCore.h — the frames (guarded no-arg opcodes, payload writes,
    the bare ENTER_BOOTLOADER), every read with its validation, the verified
    writes (offset, gates), the folds into UnitFacts, the composed probe and
    health-poll reads, the batch-idle wait and the per-unit error ledger.
    - shared/UnitBusTwiboot.h — rescue probe, boot-section read, and one unit's
    flash (size guard → liveness →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
    [ApiIndex.h, BootDumpOp.h, DisplayTask.cpp, DriftLogPolicy.h, FollowerBus.cpp, ReflashPlan.h, UnitBus.cpp, UnitBus.h]
2026-10-04 fix: unit-bus review findings; API legend means the same on both row masters
    From the review of the shared unit-bus layer:
    - ESP-01: the per-unit error tally was folded only for a unit that answered,
    so a rescan zeroed err/errAge for exactly the silent and bootloader-mode
    units, and a failed render write showed only after that unit's own poll.
    Every column is folded on each poll and before each probe publish, as on
    the S3.
    - ESP-01: the flash path checks the image size before it sends a unit into
    its bootloader, not after.
    - S3: a probe's scan-log entry is completed (identity note) before the
    diagnostics can log a line of their own into the middle of it.
    - The composed probe / po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
    [ApiIndex.h, FollowerBus.cpp, UnitBus.cpp, UnitBusCore.h]
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2026-10-04 feat: gzip-packed OTA image for the ESP-01 follower, with its limits measured
    The ESP-01 has one app area (1,028,096 B) for the running image and the
    stored upload. A plain image must fit beside itself: ceiling 510,976 B, 56 KB
    above today's image. eboot in the pinned core also unpacks a gzip upload,
    which moves the ceiling to about 600 KB at today's 70 % ratio.
    - The build writes follower-<rev>-gz.bin beside the plain image, prints both
    margins, and fails when the image could no longer replace itself.
    - The core cannot check a gzip upload (no flash-size test, no flash-mode
    patch), and eboot does not notice when it unpacks over input it has not
    read yet. POST /firmware/master therefor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
    [FollowerJson.h, FollowerOtaImage.h, FollowerWeb.cpp, build_assets.py]
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2026-10-04 refactor(twiboot): optimise new image — 34 B saved, 152 B headroom
    Four optimisations to the SF_NEW_TWIBOOT lean build (778 → 744 B):
    - boot_timeout prescaled (÷8) to fit uint8_t in GPIOR2; prescaler
    counter in GPIOR1 — IN/OUT (2 B) replaces LDS/STS (4 B) per access
    - Timer ISR reads GPIOR2 once into a local, eliminating the compiler's
    redundant volatile re-read (CPI + SUBI on separate LDS)
    - LED-exit delay guarded out (SF_NEW_TWIBOOT has no LED)
    - Settle loop de-volatilised: the 50-nop busy-wait counter was
    volatile-qualified, forcing a memory round-trip per iteration — a
    register-only loop is correct and 20 B smaller
    152 B of headroom before page 7 — enough for the thr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
    [BootSectionClassify.h, main.c]
2026-10-04 fix(twiboot): recognise deployed e422a668 as PREV_NEW, not UNKNOWN
    259da45 changed BOOT_CURRENT_CRC32 to the optimised image (f8cdd7a1)
    but dropped e422a668 from the classifier's vocabulary. All 21 fielded
    units carry e422a668, which now fell through to BOOT_STATE_UNKNOWN →
    CORRUPT on the masters, with no update path (the updater refuses
    UNKNOWN).
    - Add BOOT_STATE_PREV_NEW (value 5) and BOOT_PREV_NEW_CRC32 to the
    classifier — a known previous new-twiboot image with do_spm already
    in page 7, needing stage 2 only
    - Update the decoder range check (BOOT_STATE_NEW → BOOT_STATE_PREV_NEW)
    - bootUpdateDecide accepts PREV_NEW for stage-2-only (same as
    PAGE7_INSTALLED / TRAMPOLINE)
    - boot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
    [BootSectionClassify.h, BootUpdateAvr.h, BootUpdatePlan.h, BootUpdateReport.h]
2026-10-04 fix(twiboot): restore the address settle time; name, pin and prove the previous image
    From the review of 259da45 and f306372 (no unit carries the 259da45 image):
    - The optimised settle loop before the address switches are read ran
    12.5 us; the image on every unit waits about 30 us. A line read early gives
    the wrong bus address, and a bootloader listening on the wrong address
    cannot be reached for a reflash. Back to 150 iterations (37.5 us), same
    image size. The current image is therefore 0x081c2954.
    - A unit on the previous image reported its boot state as "unknown" in the
    boot-info reply: the name table had no entry for PREV_NEW. It reads
    "prev-new"; the decoder's range check a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
    [BootInfo.h, BootSectionClassify.h, BootUpdateReport.h, main.c]
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2026-10-04 feat(twiboot): crash-reset recovery, identity bytes, fuse/lock reads
    Crash recovery (#542): .init3 reads MCUSR + GPIOR2 to count consecutive
    watchdog resets; main() holds twiboot open after SF_CRASH_THRESHOLD (3)
    so the master can reflash a boot-looping unit. The unit app writes a
    sentinel (GPIOR1 = 0xAA) early in setup() so intentional resets clear
    the counter; twiboot clears both GPIORs before jumping to the app.
    Identity bytes (#541): the info[16] reply for SF_NEW_TWIBOOT now carries
    {'S','F', version, capabilities, 0xFF...} instead of the "TWIBOOT v3.2"
    string, so the master can query crash-recovery and fuse-read support.
    Fuse/lock reads (#543): chipinfo response extended from 8 to 12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
    [BootSectionClassify.h, Unit.ino, main.c]
2026-10-04 fix(twiboot): move crash counter from GPIOR2 to .noinit SRAM
    The #542 crash counter lived in GPIOR2, aliased by boot_timeout during
    twiboot's runtime loop and zeroed before jump_to_app — the counter
    could never reach its threshold, making the feature a no-op.
    Move the counter (sf_crash_count) and its validity guard (sf_crash_magic)
    to .noinit SRAM, which the AVR preserves across WDT/EXT/BOD resets.
    A magic byte (0x5F) detects uninitialised SRAM on first power-on.
    PORF also clears the counter: a power cycle is never a crash loop.
    Old-app case: an app without the sentinel write counts every WDT reset
    as a crash and parks in twiboot after 3 — recoverable via I2C reflash.
    The update job fl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
    [BootSectionClassify.h, main.c]
2026-10-04 fix(twiboot): remove #542 crash recovery — counter cannot survive app startup
    The .noinit SRAM counter falls inside the app's .bss (crt0 zeroes it on
    every boot), and GPIOR1 is hardware-cleared on every reset so the
    sentinel cannot survive the WDT reset it reports. The sim proof only
    tested the comparison logic via state injection, never exercising a real
    app through a real reset.
    Remove all #542 code: .noinit variables, .init3 crash detection, main()
    hold check, pre-jump GPIOR1 clear, Unit.ino sentinel write, crash_app
    sim, R1-R4 proof tests, --init-data/--expect-hold harness extensions.
    Clear SF_INFO_CAP_CRASH_REC from the identity bytes.
    Keep #541 identity bytes, #543 fuse/lock chipin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
    [BootSectionClassify.h, Unit.ino, main.c]
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2026-10-05 feat: twiboot crash recovery, identity v3, fuse/lock chipinfo (#542, #541, #543)
    Bootloader side — the row-master protocol changes (TwibootFlash.h,
    TwibootProtocol.h) and the coordinated prebuilt/BootSectionClassify.h
    commit are in the peer session.
    Crash record (#542):
    - Two reserved bytes at SRAM 0x08FE/0x08FF survive WDT resets.
    Format: byte A = 0xA0|count, byte B = ~A. Validated on entry;
    invalid records default to count=1 on WDT, count=0 otherwise.
    - Threshold=3 consecutive WDT resets → app_installed=0, bootloader holds.
    - CMD_SWITCH_APPLICATION writes 0 to CRASH_REC_A (tag check fails → cleared).
    - init1 sets SP = CRASH_REC_STACK_TOP (0x08FD), both SPH and SPL.
    - Chipinfo b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
    [main.c, make_new_twiboot.py]
2026-10-05 feat: row masters read the bootloader's crash count and leave a held unit alone
    Master side of the crash record (#542). A bootloader that advertises it
    (identity version 3, capability 0x04) serves chipinfo byte 12: the number of
    watchdog resets in a row its application caused before it had run healthy.
    At 3 the bootloader stops starting the application and waits to be flashed.
    - twibootReadIdentity reads 13 chipinfo bytes from such an image, 12 from one
    that only serves fuses, none otherwise — an image is never asked for more
    than it says it has.
    - The runtime rescue no longer starts a unit that is held for crashing: it
    would repeat the crash with a cleared count. The unit becomes a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
    [ApiIndex.h, DisplayTask.cpp, FollowerBus.cpp, TwibootFlash.h, TwibootProtocol.h, UnitBus.cpp, UnitBus.h, UnitBusTwiboot.h]
2026-10-05 feat: unit app crash record clear + prebuilt update + real-app proof (#542)
    Unit application changes:
    - CrashRecordApp.h: shared crash record clear for the app side
    - Unit.ino: 20s health timer clears the record; pendingBootloader
    path clears before every intentional WDT reset
    - BootUpdateAvr.h: stage-1 boot update clears before its WDT reset
    - platformio.ini: --defsym=__stack=0x8FD reserves 0x08FE/0x08FF
    Prebuilt + classifier:
    - twiboot-new-progmem.h: regenerated, CRC 0x506b3970
    - BootSectionClassify.h: BOOT_CURRENT_CRC32 updated, c65e3dbf
    rotated into BOOT_PREV_NEW3_CRC32
    - twiboot-prev-c65e3dbf.hex: previous image archived
    - prove.sh: R1/R2 tests added for c65e3dbf as third previous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
    [BootSectionClassify.h, BootUpdateAvr.h, CrashRecordApp.h, Unit.ino]
2026-10-05 fix: the S3 re-reads a unit by itself after sending it through its bootloader
    A unit reboot or a boot-section dump voids that unit's probe-time reads
    (offset, odometer, version), and only a probe reads them again. The ESP-01
    follower queues one itself; the S3 served no offset for the unit until
    someone asked for a refresh. displayTask now owes itself a probe and runs it
    on the first idle tick after the twiboot window has passed.
    Part of #539.
    [DisplayTask.cpp]
2026-10-05 feat: a cluster member reports "leader lost" to Home Assistant and on its LED
    The leader's own cluster sensor dies with the leader, and a member used to
    publish nothing but its availability. Any joined S3 member now publishes a
    `leader_lost` problem sensor: OFF while the leader is in contact or merely
    quiet, ON once it has been written off (silent past the grace period). The
    entity exists only while the board is a member and is blanked otherwise.
    The status LED shows cyan in that state, below every state of the board's
    own (OTA, unconfirmed image, WiFi).
    The board to carry the alert is one that does not share the leader's fate:
    a unit-less S3 enrolled as a `backup` member (documented in Mas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
    [MqttService.cpp, StatusLed.cpp, StatusLedPolicy.h]
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2026-10-05 feat: the ESP-01 row restarts itself when its bus stays dead or its heap stays low
    Two conditions end in a self-restart (FollowerEscalation.h, natively tested):
    - the row-wide recovery has had the bus as dead for 10 minutes, on a row
    where at least one unit has answered this boot;
    - the largest free heap block has been under 4 KB for 5 minutes (logged
    after one).
    At most one such restart per 6 hours of uptime, counted in RTC user memory
    next to the rescue and reset-log records (layout held by static_asserts); a
    power cycle clears it. /cluster/health gains `esc`: how many, the last cause,
    uptime since.
    Not included, on purpose: restarting for WiFi down or a silent leader. Both
    are almos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
    [ApiIndex.h, FollowerEscalation.cpp, FollowerEscalation.h, FollowerJson.h, FollowerWeb.cpp, main.cpp]
2026-10-05 feat: the liveness watchdog reports where its own-server probe stopped
    /settings netLiveness gains selfStep and selfErr: a bare "fail" does not
    say whether the connect, the send or the reply was missing.
    Part of #501.
    [NetLiveness.cpp]
2026-10-05 fix: the liveness own-server probe falls back to the loopback interface
    On the S3 a connect to the board's own station address times out; the
    loopback interface reaches the same listener.
    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
    [NetLiveness.cpp]
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2026-10-05 feat: quiet mode — the wall issues no flap commands while it is on
    Round 1 of #227. While quiet is on the clock stops updating and the frame
    that is up stays up; texts and notifications that arrive are dropped, not
    queued. One way past it: an MQTT text whose JSON carries a top-level
    "force":true (an alarm). Operator actions — Stop, unit maintenance, reflash —
    are not content and keep working.
    Where it is set:
    - MQTT switch "Quiet" via discovery: command splitflap/<id>/quiet/set, state
    splitflap/<id>/quiet. The command is retained by the sender ("ret":true),
    so a board that was offline for the change gets it on reconnect; a change
    made elsewhere (the web toggle, a takeover) is wr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
    [ClockTask.cpp, FollowerCluster.cpp, FollowerCluster.h, FollowerWeb.cpp, MqttService.cpp, PendingSettingsPost.h, QuietPolicy.h, Settings.h]
2026-10-05 fix: a keyed cluster member takes the quiet flag only with its own signature
    The quiet flag rode the ping outside the signature that binds the rest of
    it, so a host on the LAN could flip it on a validly signed ping.
    The leader now adds `qmac`: an HMAC with the member's key over the flag and
    the ping's own timestamp. The ping's canonical message is unchanged, so a
    member that predates the flag still verifies every ping and ignores the two
    new params. A keyed member accepts the flag only with a valid qmac; a flag
    that is absent or not accepted changes nothing. The timestamp is the one the
    ping's signature and replay mark already cover, so a recorded flag cannot be
    replayed onto a later ping.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
    [FollowerCluster.cpp, FollowerCluster.h, FollowerWeb.cpp, QuietPolicy.h]
2026-10-05 fix: quieter crash count, no framework stamp on rescue, digest omission visible
    - #557: the bootloader's crash count reads 1 after any intentional reset, so
    every reflash logged "1 crash reset(s)". The scan log and `blx` now speak
    from 2 up; HELD at 3 as before.
    - #558: the app descriptor's version string is frozen into the framework
    libraries and repeats on every image. The rescue install log line no
    longer prints it, and the rescue page shows each slot's rev instead of the
    stamp and its build time.
    - #387: /cluster/status carries `digestOmitted`, and the Cluster card says so
    when the cluster digest no longer fits the ping and the rows' own wall
    view goes stale.
    - shared/Clust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
    [ApiIndex.h, FactorySlot.cpp, TwibootFlash.h, TwibootProtocol.h, UnitHealth.h]
2026-10-05 fix: the persistent flash log is reachable again — /log no longer answers /log/flash
    ESPAsyncWebServer matches a registered path against the path itself and
    every "<path>/..." request, first registered handler wins. /log was
    registered before /log/flash, so GET /log/flash and /log/flash?prev=1 were
    answered with the 32 KB RAM ring: the 1 MB persistent log (and the previous
    one) could not be read, and the web UI's flash-log view showed the RAM ring.
    The flash-log routes are now registered first. tests/test_route_shadowing.py
    walks every board's registrations in registration order and fails on any
    same-method route that an earlier, shorter one would answer.
    Part of #556.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
    [WebSystem.cpp]
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2026-10-05 feat: wall link message format, clock and pacing as pure code
    firmware/v2/link/WallLink.h holds the frame format, every message of the
    master to row-board link, the link clock (shortest of the last 25 round
    trips) and the master's pacing rule. 28 native tests, among them a replay
    of the round trips recorded on the live row. A Python twin for the
    host-side stand-ins is held to the C++ by shared byte vectors.
    Closes #561
    [WallLink.h]
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2026-10-05 feat: wall link messages from one schema, generated with nanopb
    Replaces the hand-written message format with firmware/v2/link/wall_link.proto:
    one envelope message per direction, length-delimited, generated for both
    boards at build time. Unit facts travel as the existing /units/health JSON
    in pieces. The link clock and the pacer are gone: rows will take their time
    from the master over NTP, and pacing is left to TCP.
    What stays hand-written is the piece nanopb leaves to the application:
    collecting a whole message from a polled socket, and putting the unit-facts
    document back together. 18 native tests; stock Python protobuf decodes the
    bytes the native test pins.
    buildtools/ensure_nanopb_de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
    [WallLink.h]
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2026-10-05 feat: row board dials its master over the wall link (first slice)
    The ESP-01 opens one TCP connection to the master it is paired with, says
    Hello, and from Welcome on takes Show, Quiet, Ping, Restart and Release from
    it and reports Status every 10 s. What arrives goes to the same cluster
    handlers the HTTP wire calls, so the phase machine, flip timing and fallback
    clock are unchanged. The old routes are untouched; the link is not started
    in rescue mode yet.
    link/fake_master.py is the bench stand-in a row can dial.
    Part of #564.
    [FollowerLink.cpp, FollowerLink.h, FollowerLinkPolicy.h, main.cpp]
2026-10-05 feat: settings and unit jobs reach the row over the wall link
    Config sets what the row shows once its master is written off (blank,
    time or date), whether it updates its units at start, and the tz rule.
    The fallback choice is stored beside the boot brake; a record written
    before the field existed reads as time, which is what such a row did.
    Op runs a unit job through the same staged-op slot and shared checks
    the routes use: home, identify, jog, set offset, self-test, restart
    unit, reset odometer, feature gates, boot info, boot dump, boot update,
    update one unit or the row, and a rescan. The master names the job; the
    row answers running or refused at once and reports the end from the
    result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
    [FollowerClock.h, FollowerCluster.cpp, FollowerCluster.h, FollowerLink.cpp, FollowerLinkOps.h, FollowerLinkPolicy.h, FollowerOps.h, FollowerPrefs.cpp]
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2026-10-05 feat: row board is driven over the wall link only
    The old cluster wire and the operator routes are gone from the ESP-01 row.
    It serves three routes, the ones it needs without a master: the firmware
    upload (unchanged), GET /settings as a small identity document (version
    and plat, as ota-flash.sh reads them) and a new POST /pair.
    Pairing: a row obeys one master, known by id and address. It takes a new
    one when it has none or has written its own off; its own master's id from
    another address counts only once the master is out of contact. A pairing
    that changes closes the open connection.
    The log goes up the link as LogLine while the master asks for it; the boot
    log carries the reset history. U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
    [FollowerBus.cpp, FollowerBus.h, FollowerCluster.cpp, FollowerCluster.h, FollowerEscalation.h, FollowerJson.h, FollowerLink.cpp, FollowerLink.h]
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2026-10-06 feat: master link rules and a bench row stand-in
    WallLinkPolicy.h holds the master's rules for a row's connection: ping only
    a connection not written to for 10 s, never a busy row; lost after 30 s
    without a message, except a busy row whose connection stands (TCP keepalive
    finds that one); the latest text per row and nothing queued; a new boot id
    means the row restarted.
    fake_row.py dials a master as the ESP-01 row does. tests/test_fake_pair.py
    runs it against fake_master.py so the two stand-ins cannot drift apart.
    Refs #566 (slice 1)
    [WallLinkPolicy.h]
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2026-10-06 fix: link review findings on the master's connection handling
    - A row that is not busy and not heard for 30 s is closed: keepalive only
    proves its TCP stack. A download counts as busy, as the row announces it.
    - A Hello for a connected row is taken only from the same address; from
    another one it is refused while the older connection stands.
    - With every slot taken, the connection that has been nobody the longest
    makes way for a new one.
    - Contact times are published every second for connected rows (a Pong
    moved them without anyone being told).
    - ENOMEM / ENOBUFS on a write mean "not now", not a lost connection.
    - The rows table and its generation are read under one lock.
    - A first me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
    [WallLink.cpp, WallLinkCore.h, WallState.cpp, WallState.h]
2026-10-06 feat: master reads a row's unit facts into the one UnitFacts struct
    UnitFactsJson.h is the inverse of the shared buildUnitHealthJson, on
    ArduinoJson: a remote row's units are judged and worded by the same code as
    the master's own. Proven by a round trip through the serializer; a pytest
    gate fails when the serializer gains a key the reader does not name.
    Refs #566 (slice 3)
    [UnitFactsJson.h]
2026-10-06 fix: a row's paired address always takes its place on the link
    A connection holding a row's place from another address (and claiming to
    be busy, so never closed for silence) could keep the real row out. A Hello
    from the address the row was paired at now always replaces; one from
    elsewhere only replaces a connection from that same address.
    An unreadable first message closes the connection instead of being logged
    and skipped, and log lines about connections that are nobody are held to
    one per 10 s.
    Also adds WallOps.h, the registry of operator-started jobs (not wired yet).
    Refs #566 (slices 2, 3)
    [WallLink.cpp, WallLinkCore.h, WallOps.h]
2026-10-06 feat: pairing, unit facts and the first /api/v2 routes on the master
    POST /api/v2/action starts a job (pair, release, arrange) and answers with
    its id; GET /api/v2/op/<id> says what became of it; GET /api/v2/wall lists
    the boards with what each row last said. The web side only stages: the
    worker task posts the pairing to the row and changes the rows table, and
    posts it again to a row the link has lost (a master whose address moved).
    The link task puts a row's unit facts together from their pieces and
    publishes them as UnitFacts; a row that restarted fails its open jobs.
    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
    [ApiIndex.h, Tasks.cpp, WallLink.cpp, WallPair.cpp, WallPair.h, WallState.cpp, WallState.h, WebEndpoints.cpp]
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2026-10-06 fix: /api and /log no longer answer for the paths below them
    server.on("/api") also matched /api/v2/wall and /api/v2/op/<id>, so the new
    routes returned the index (found on the bench). Both are registered exact
    now, and test_api_index.py fails on any plain route with a served route
    below it.
    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
    [WebSystem.cpp]
2026-10-06 fix: a row's address is never this board; stats carry the link task's stack mark
    A pairing posts to the row's address, so loopback is refused as one. The
    bench row's made-up unit facts use the shared serializer's keys (the master
    refused the invented ones, as it should). /system/stats hwm gains "link".
    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
    [SystemStats.cpp, SystemStatsPolicy.h, WallRows.h]
2026-10-06 fix: API answers copy the strings they take from a snapshot
    ArduinoJson only keeps a pointer to a char array member, and an async
    response is written after the handler's snapshot is gone: /api/v2/wall
    answered with freed memory (found on the bench). jsonCopied() makes such
    a string a plain pointer, which is copied; test_json_copied pins both the
    library behaviour and the fix.
    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
    [JsonCopied.h, WebWall.cpp]
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2026-10-06 feat: quiet and settings reach the rows; flip timing and own-row rules
    The connection core tells a row the wall's quiet state and its settings
    (fallback, units at start, time zone) at its Hello and when they change,
    before any text and never while it is busy. WallShowPolicy.h holds when
    rows flip (400 ms for typed text; the clock's next minute is given 3 s
    ahead to flip at the boundary) and what the master does with its own row.
    Not wired to the producers yet.
    Refs #566 (slice 4)
    [WallLinkCore.h, WallShowPolicy.h]
2026-10-06 feat: a wall with row boards shows its text over the wall link
    WallShow lays the wall's logical text out on the grid, queues the master's
    own row at the flip instant and hands every row board its piece through
    the link task. The clock ticker, the web text path and Stop go there while
    the rows table has rows; the clock's next minute is handed over 3 s ahead
    to flip at the boundary. Rows are told quiet and their settings (time
    zone, units at start, show the time when the master is lost).
    While the wall link holds rows the old cluster leader stands down; its
    members fall back by themselves. /api/v2/wall carries each row's text.
    Refs #566 (slice 4)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
    [ClockTask.cpp, Tasks.cpp, WallLink.cpp, WallShow.cpp, WallShow.h, WallState.cpp, WallState.h, WebEndpoints.cpp]
2026-10-06 feat: the wall answer says what each row shows and how late it flipped
    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
    [WallLink.cpp, WallState.h, WebWall.cpp]
2026-10-06 fix: link task stack sized to its measured peak
    4.2 KB used of 8 KB with a row connected and the wall showing the clock:
    12 KB keeps the 50% margin.
    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
    [Tasks.cpp]
2026-10-06 feat: the master answers time requests
    The link task answers SNTP on UDP 123 from its own clock (SntpReply.h),
    so a row board can follow the clock the master names flip instants on.
    A master without synced time stays silent.
    Refs #566 (slice 5)
    [SntpReply.h, WallLink.cpp]
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2026-10-06 fix: the row image offer is timed on the link pass's one clock
    A hook fed the offer rule a later millis() than the pass's own now, so the
    age of a download that had just begun read as wrapped and overdue.
    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
    [WallLink.cpp]
2026-10-06 fix: review findings on unit jobs and the row image offer
    An own-row unit update took the web state lock twice and hung the web
    server's task; jobs are now started before that lock. A job staged against
    a newer rows table waits for the link pass that has taken it. Rows take
    turns for the offer, so one that never answers does not keep the rest
    waiting. A failed read of the stored image's checksum is tried again; a
    repeated result piece no longer shortens what is held.
    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
    [FollowerImageStore.cpp, WallLink.cpp, WallState.cpp, WallUpdatePolicy.h, WebWall.cpp]
2026-10-06 feat: the old cluster is gone; the wall link is the only way rows are driven
    The master no longer calls member boards over HTTP: ClusterLeader*,
    ClusterFollower*, WebCluster.cpp, the digest, HMAC, device roles and the
    headless path are deleted with their tests and bench twins, and so are the
    terminal tool (cli/, with its CI job) and flashing/cluster-ctl.py. The page
    loses its cluster card, member panels and wall mirror and keeps working for
    the master's own row.
    What takes their place on the master:
    - POST /firmware/row stores the row image (was /cluster/follower-firmware).
    - The "update" action offers a row board the stored image again.
    - Home Assistant gets one wall_problem sensor with th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
    [ApiIndex.h, ClockTask.cpp, ClusterLayout.h, CrashContextPolicy.h, DisplayIpc.h, DisplayTask.cpp, FactorySlot.cpp, FollowerCluster.cpp]
2026-10-06 fix: review findings on the cluster removal
    - The row board names both time servers on every setup: with an empty
    second one the core freed the name lwIP still pointed at (after a
    release, or a pairing to another address).
    - An "update" retry is taken only by the link pass that runs on the rows
    table it was asked against, and a table change drops what was waiting.
    - The master_debug env traced code that no longer exists; comments of the
    phase machine and the LAN-origin rule named deleted routes and tests.
    Refs #566
    [ClusterMemberPhase.h, FollowerCluster.cpp, LanOrigin.h, WallLink.cpp, WallState.cpp]
2026-10-06 fix: the quiet switch's discovery payload read one argument too many
    Its format has seven %s (four topics, the device block's three) and got
    six values: the firmware rev landed in the device name and the rev itself
    was read from whatever lay behind the last argument. On the image without
    the old cluster that was an unmapped address, and the master restarted at
    every broker connect.
    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
    [QuietPolicy.h]
2026-10-06 fix: a row refused by its master waits before it dials again
    A master that does not know the row closes the connection after the Hello.
    The row only counted a lost connection once it had been welcomed, so that
    close armed no backoff and the next loop pass dialled again: about twenty
    connections a second, seen on the wall while the row was not yet paired.
    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
    [FollowerLink.cpp]
2026-10-07 feat: verdicts for a unit and for a board
    Facts in, a level (working / note / fault), the reason that leads with two
    numbers, and every reason that applies. The master's own units and a row
    board's are judged by the same code, since both are the same UnitFacts.
    A fault is something wrong now. A unit that restarted by itself and runs
    again is a note; so far it counted as faulty until the master restarted.
    The headers live in Master/, not shared/: only the master judges, and no
    unit or row compiles them. Nothing calls them yet.
    Refs #570
    [BoardVerdict.h, UnitVerdict.h]
2026-10-07 feat: a record of what happened on the wall, kept across restarts
    Fixed 24-byte entries (time, board, unit, kind, two numbers) on the storage
    LittleFS, staged by any task and written by netTask. GET /api/v2/history
    reads them newest first, a page at a time.
    Two files, appended to and rotated at 2048 entries, as the flash log does.
    Overwriting inside a LittleFS file copies the rest of the file, so a ring
    written in place is the costly form on this filesystem.
    An entry made before the clock is set waits for it and is dated back, so a
    start still has its time; after two minutes without a clock it is written
    undated. A board is named by a 16-bit key of its id, which needs no name
    table and sti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
    [ApiIndex.h, EventRecord.cpp, EventRecord.h, EventRecordPolicy.h, WebEndpoints.cpp, WebWall.cpp, main.cpp]
2026-10-07 feat: one place judges the wall and records what changed
    Once a second the worker task turns what the master knows into verdicts,
    for its own units and for every row board, and publishes them: GET
    /api/v2/wall carries a verdict per board and a level per unit, and the Home
    Assistant wall problem sensor is on while any board's verdict is a fault,
    the master's own row included.
    The same look writes the event record: a reason starting, a fault ending, a
    unit or a row board restarting. What a read could not speak for stays as it
    was, so a unit that goes quiet does not recover from its failed home. Units
    a job is working on are watched in silence. How every job ended is recorded
    where jobs are fi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
    [BoardVerdict.h, DisplayIpc.h, MqttService.cpp, Tasks.cpp, UnitVerdict.h, WallJobs.h, WallMqtt.h, WallOps.h]
2026-10-07 fix: what the first run on the wall showed about the event record
    A changed rows table drops every connection, and a row that had not dialled
    back within the second was recorded as never seen. Its silence is counted
    from the change of the table now, as it is from the master's start.
    A row paired while it takes the stored image had the end of its update
    recorded without the start. A board's recorded reasons are faults or what it
    is doing now, so the first look at a board records them too; only a row's
    units keep their notes to themselves at first sight.
    A pair or release job is recorded against the row it was about.
    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
    [WallPair.cpp, WallState.cpp, WallState.h, WallWatch.cpp, WallWatchPolicy.h]
2026-10-07 feat: a row board tells its master what happened on it
    Its start with the reset cause, a start that follows a restart it forced on
    itself, and memory running low go to the master as Event messages and into
    the event record. The row keeps them in a four-place queue until the master
    is reached, since a start is known long before that, and says with each how
    long ago it was; the master dates the entry back by that.
    Event gains age_s at its end and the codes get an enum in the schema. An
    older row sends neither and an older master skips both.
    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
    [EventRecord.cpp, EventRecord.h, EventRecordPolicy.h, FollowerEscalation.cpp, FollowerEvents.h, FollowerLink.cpp, FollowerResetLog.cpp, WallLink.cpp]
2026-10-07 fix: one row cannot fill the event record
    A row's events were written as fast as it sent them. A row gone wrong could
    then push everything else out of the record, which is the whole wall's, and
    keep the flash busy. Each row may add eight entries at once (two of its own
    queues) and one per half minute after that; the rest is dropped and logged
    once.
    The time a row gives for its events is taken as it is: the boards of a wall
    trust each other (the spec's trusted-LAN decision).
    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
    [WallLink.cpp, WallRowEvents.h]
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
