lvschouwen/split-flap/PCB/v1/PXL_20260426_125132482.jpg

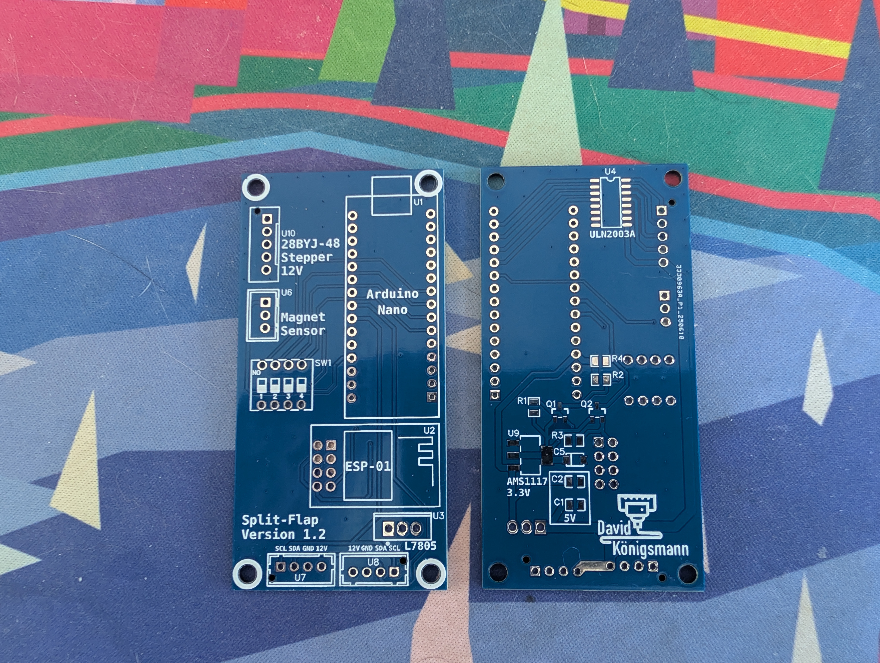
PCB/v1/PXL_20260426_125132482.jpg
